Ykai-f/wiki_yuekai_fr_BMCU/home.md

---
title: Home page
description: 
published: true
date: 2025-07-13T19:34:54.650Z
tags: 
editor: markdown
dateCreated: 2025-01-26T21:11:08.155Z
---

# Welcome to yuekai's wiki - BMCU wiki

Backup site that can be accessed in case of failure of this site ：wiki2.yuekai.fr

You can contact me by
Reddit : [u/Ok_Design6972](https://www.reddit.com/user/Ok_Design6972/)
By mail : contact@yuekai.fr
I also recommend asking your question directly in the Reddit forums to get responses from other enthusiasts: https://www.reddit.com/r/BMCU/.

>Update 4th June : 
>📢 Printer Firmware Update Notice –**A Series** - **01.05.00.00**
>✅ This update does not affect the functionality of BMCU. You can safely update your printer without concerns regarding BMCU compatibility.
>⚠️ However, this firmware does impact third-party integrations such as Orca Slicer and Home Assistant.
{.is-success}

> Update on 1st July
>📢 BMCU Firmware Update Notice –**BMCU-C 0019**
> The problem of not being able to change filament on P/X printers has been successfully fixed in BMCU-C firmware version 0019.
{.is-success}

# Table of contents

- [🏠 Home](/home)
- [🛍️ Buy BMCU](/BMCU/buy_bmcu)
{.links-list}

### Introduction
- [📖 What's BMCU](/BMCU)
- [🅿️ BMCU in P/X series](/BMCU/BMCU_in_p_series)
{.links-list}

### Before building
- [🌿 Current Version Branches](/BMCU/bmcu_branches)
- [📝 Preparation Before Building](/BMCU/preparation_before_building)
- [📦 BMCU Bill Of Materials](/BMCU/BMCU_bill_of_materials)
{.links-list}

### While building
- [🛠️ BMCU Download Center *Print files, Firmwares*](/BMCU/BMCU_Download_Center)
- [🎓 BMCU Tutorial Center *Tutorials*](/BMCU/BMCU_Tutorial)
- [🔬 BMCU Testing *Before connect to printer you must..*](/BMCU/BMCU_testing)
{.links-list}

### After building
- [🆕 First time using BMCU](/BMCU/new_bmcu)
- [⚙️ Troubleshooting](/BMCU/troubleshooting)
{.links-list}

# Content Sources & Acknowledgements

> **内容来源声明**
>本网站部分内容转载自作者的交流群，以及 BMCU WIKI 编辑部 其他成员的贡献内容。特此声明并向所有原作者及编辑部成员表示感谢。
>📌 BMCU WIKI 编辑部中文网站: https://bmcu-cf.wanzii.cn
>📌 BMCU WIKI 编辑部中文站点源码 (GitHub): https://github.com/xwzkj/bmcu-doc
>📌 BMCU 作者官方QQ交流群 ： 829433420
{.is-info}

> **Content Source Declaration**
>Some content on this website has been reposted from the author's discussion group and contributions from other members of the BMCU WIKI Editorial Team. We hereby acknowledge and express our gratitude to all original authors and editorial team members.
>📌 BMCU WIKI Editorial Team Chinese Website: https://bmcu-cf.wanzii.cn
>📌 Backup site for oversea visiter ： https://bmcu.wanzii.cn/
>📌 BMCU WIKI Editorial Team Chinese Site Source Code (GitHub): https://github.com/xwzkj/bmcu-doc
>📌BMCU authors Chinese exchange group : QQ group - 829433420
{.is-info}

# 特别感谢 / Special thanks
特别感谢WIKI编辑部的所有成员及作者大佬
Special thanks to all the members of the WIKI editorial team and the authors!
`@4061N`，`@括号`，`@苹果香蕉泥`，`@丸子`，`@高性能萝卜子`，`@星尘`，`@2333`，`@青铜扳子`，`@白小淘`，`@Carlos`，`@David`，`@独来独往独自言`，`@二月 喵～`，`@HC`，`@憨批`，`@花雨烟然、繁华乱了`，`@1064 aka 曼波 aka 朱孔明 aka 袁大头`，`@十`，`@神棍`，`@我是懒大王`，`@星玲可`，`@晓心乐子人`，`@心已死`，`@言`，`@知悟`，`@ `，`@。。。`，`@少年谈情不说爱`，`@.`

# To do list for the updates

~~- Hall version tutorials~~
- New what's BMCU page
- New first time use page
- BMCU videos
- BMCU Hub for multiple BMCU
- BMCU D info
- update version branch info
~~- troubleshooting rebuild~~
- test rebuild
- flashing -> linux and macos info
- troubleshooting hall version -> squeezes / Mouse sounds
- all versions -> update on motor fixiation
- aliexpress list for parts -> note for gears !
