Ykai-f/wiki_yuekai_fr_BMCU/not_only_bmcu.md

---
title: Not Only BMCU
description: 
published: true
date: 2025-05-27T17:19:48.553Z
tags: 
editor: markdown
dateCreated: 2025-05-27T17:18:15.644Z
---

To do

BMCU hub to connect 4 bmcus -> but in the end still 4 colors in one print.

B1 rewinder device

tool for catching packets
