Ykai-f/wiki_yuekai_fr_BMCU/BMCU/home.md

---
title: Home page
description: 
published: true
date: 2025-03-21T14:36:12.856Z
tags: 
editor: markdown
dateCreated: 2025-01-26T21:11:08.155Z
---

# Welcome to yuekai's wiki - BMCU wiki

You can contact me by
Reddit : u/Ok_Design6972
By mail : contact@yuekai.fr
By vinted : https://www.vinted.fr/member/234363406

> Please never hot-plug the cable between the BMCU and the printer, I have already fried my BMCU and printer 🥶. More details on : [BMCU-accident-hot-swapping](/BMCU/BMCU-accident-hot-swapping)
{.is-warning}

# Table of contents

- [🏠 Home](/home)
- [🛍️ Buy BMCU](/BMCU/buy_bmcu)
{.links-list}

### Introduction
- [📖 What's BMCU](/BMCU)
- [❓ FAQ](/BMCU/faq)
{.links-list}

### Before building
- [🌿 Current Version Branches](/BMCU/bmcu_branches)
- [📝 Preparation Before Building](/BMCU/preparation_before_building)
- [📦 BMCU Bill Of Materials](/BMCU/BMCU_bill_of_materials)
{.links-list}

### While building
- [🛠️ BMCU Download Center *Print files, Firmwares*](/BMCU/BMCU_Download_Center)
- [🎓 BMCU Tutorial Center *Tutorials*](/BMCU/BMCU_Tutorial_Center)
- [🔬 BMCU Testing *Before connect to printer you must..*](/BMCU/BMCU_testing)
{.links-list}

### After building
- [⚙️ Troubleshooting](/BMCU/troubleshooting)
{.links-list}

# Content Sources & Acknowledgements

> **内容来源声明**
>本网站部分内容转载自作者的交流群，以及 BMCU WIKI 编辑部 其他成员的贡献内容。特此声明并向所有原作者及编辑部成员表示感谢。
>📌 BMCU WIKI 编辑部中文网站: https://xwzkj.github.io/bmcu-doc/
>📌 备份站点 ： https://bmcu.wanzii.cn/
>📌 BMCU WIKI 编辑部中文站点源码 (GitHub): https://github.com/xwzkj/bmcu-doc
>📌 BMCUz作者官方QQ交流群 ： 829433420
{.is-info}

> **Content Source Declaration**
>Some content on this website has been reposted from the author's discussion group and contributions from other members of the BMCU WIKI Editorial Team. We hereby acknowledge and express our gratitude to all original authors and editorial team members.
>📌 BMCU WIKI Editorial Team Chinese Website: https://xwzkj.github.io/bmcu-doc/
>📌 Backup site for oversea visiter ： https://bmcu.wanzii.cn/
>📌 BMCU WIKI Editorial Team Chinese Site Source Code (GitHub): https://github.com/xwzkj/bmcu-doc
>📌BMCU authors Chinese exchange group : QQ group - 829433420
{.is-info}

> 特别感谢WIKI编辑部的所有成员及作者大佬
> Special thanks to all the members of the WIKI editorial team and the authors!
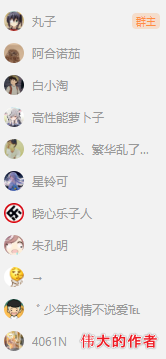
[picture p22: wiki编辑部.png]
>
{.is-success}
