Ykai-f/wiki_yuekai_fr_BMCU/BMCU/BMCU_in_p_series.md

---
title: BMCU with P/X series
description: 
published: true
date: 2025-07-21T20:22:22.619Z
tags: 
editor: markdown
dateCreated: 2025-03-20T14:42:09.077Z
---

> The problem of not being able to change filament on P/X printers has been successfully fixed in BMCU-C firmware version 0019.
{.is-success}

# BMCU Version Adaptation Status

- **BMCU-A**: Not supported; no plans for future adaptation.
- **BMCU-B**: Starting from firmware version 01.08.00.00, the switching filament parameter is no longer available, meaning filament switching in the AMS (BMCU) system cannot be configured. All versions below 01.08.00.00 are fully supported. Currently, there is no update planned to reintroduce this feature.
- **BMCU-C**: Fully supported and running well on the P-Series, Multi BMCU or BMCU+AMS supported.

# BMCU firmware with P/X printer

Starting from firmware version 2-6, the BMCU firmware is capable of identifying whether your printer belongs to the P/X series or A series. In the original firmware developed by `@4061N`, the logic for P/X series printers is as follows:

- **Feeding**: Identical to the A series, no special handling.

- **Unloading**: When unloading is triggered, the filament is retracted until the BMCU's filament detection mechanism (optical sensor or steel ball-based) no longer detects the filament. At that point, the unloading stops, the motor briefly reverses direction and feeds forward for 100ms to reinsert the filament slightly into the BMCU.

Under this default behavior, a rewinder is required to take up the slack, as the filament will be pulled out by a significant length.

This also means that, provided you have a compatible rewinder setup, you are free to upgrade your BMCU to any firmware version.

## With rewinder system

With a rewind device, you can use any BMCU and any version of BMCU firmware, and the BMCU will perform similar behavioral logic as the AMS.

## Without rewinder system
For setups without a rewinder, there are some special firmwares modified by `@XC`. Unlike the original firmware which relies on filament detection (e.g., optical or steel ball sensors), this version uses a time-based retraction mechanism to define the unloading distance.

This approach results in a **shorter** retraction distance.

> Note: Previous documentation have inaccurately stated otherwise. In reality, the default behavior causes the filament to retract all the way until it exits the BMCU, whereas this modified firmware only retracts until it reaches the internal or external five-way connector.
{.is-danger}

### Using externe 5 way

You will need a bambu 4-in-1 ptfe adapter or anything similar.
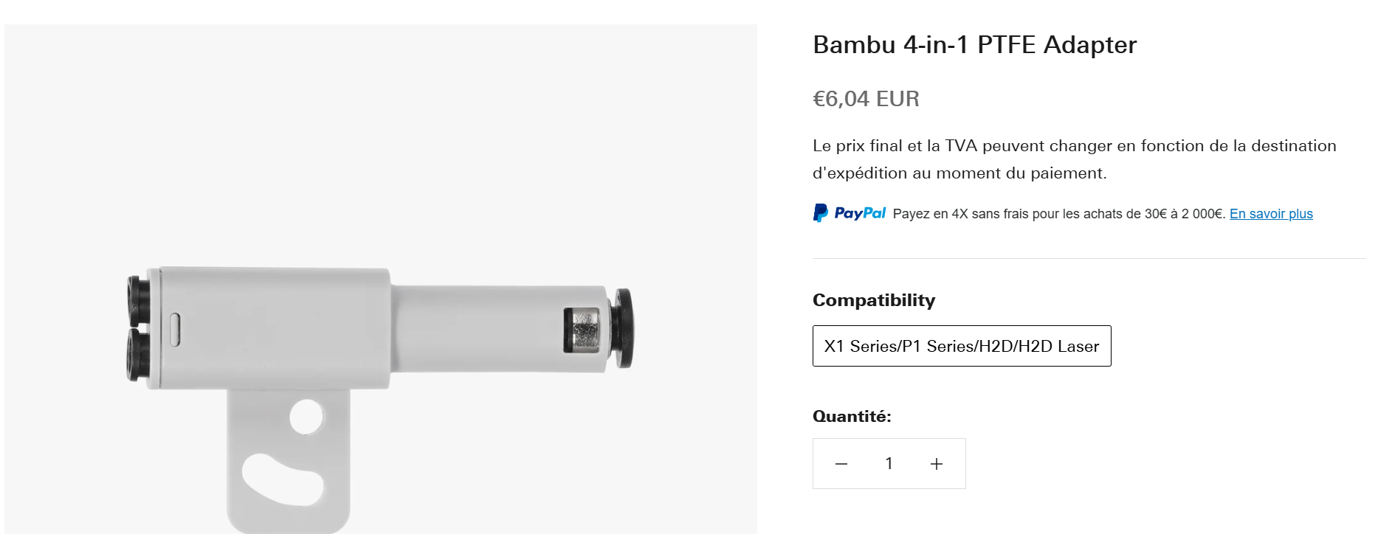
[picture p23: assets/images/p_series/4_in_1_adapter.png]
4-in-1 adapter


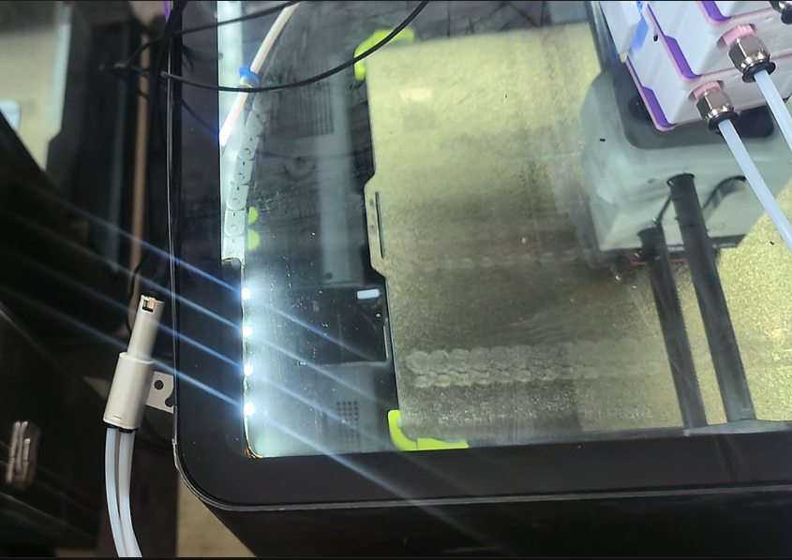
[picture p24: assets/images/p_series/bmcu_p_ext_5way.png]


### Using internal 5 way

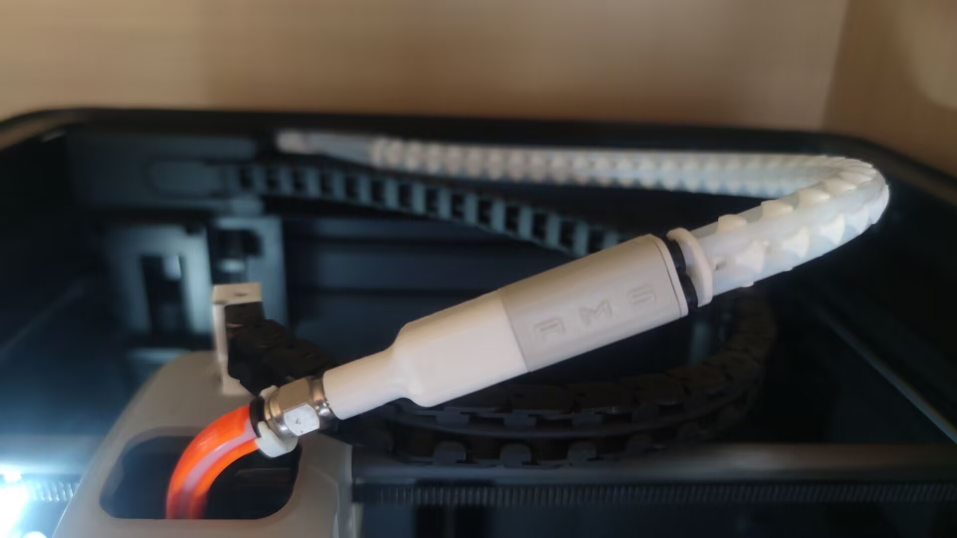
[picture p25: assets/images/p_series/p1_int_5way_1.jpg]
internal 5 way 1

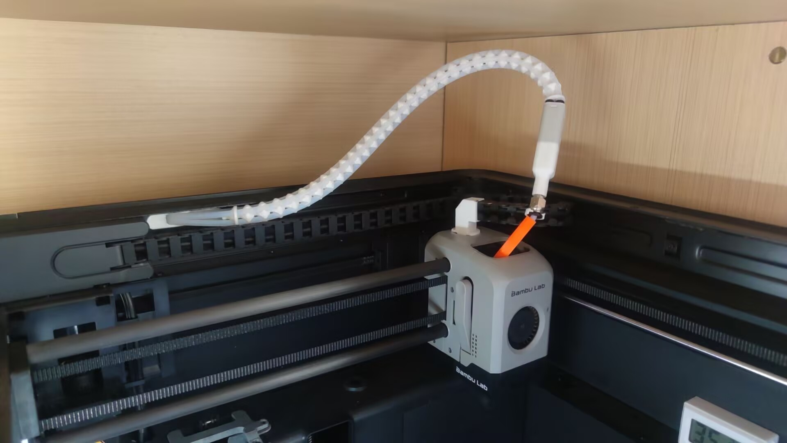
[picture p26: assets/images/p_series/p1_int_5way_2.jpg]
internal 5 way 2


### Firmwares

These firmwares are modified by XC `@星尘`

#### BMCU-B

##### 3.14
Externe 5 way:
- [P1S_RetModified_BMCU370-3.14_15s_Ext5Way.rar](/assets/files/download_center/p_series/P1S_RetModified_BMCU370-3.14_15s_Ext5Way.rar)
- [P1S_RetModified_BMCU370_3.14_14s_Ext5Way.rar](/assets/files/download_center/p_series/P1S_RetModified_BMCU370_3.14_14s_Ext5Way.rar)

Internal 5 way:
- [P1S_RetModified_BMCU370_3.14_4s_Int5Way.rar](/assets/files/download_center/p_series/P1S_RetModified_BMCU370_3.14_4s_Int5Way.rar)
- [P1S_RetModified_BMCU370_3.14_3.5s_Int5Way.rar](/assets/files/download_center/p_series/P1S_RetModified_BMCU370_3.14_3.5s_Int5Way.rar)

#### BMCU-C

##### Using internal 5 way
- [0013-Plus-Color-Noise-Heat-Improve.zip](/assets/files/download_center/firmware_and_source_code/0013-Plus-Color-Noise-Heat-Improve.zip)

- [BMCU-C-V0.1-0020.zip](/assets/files/download_center/firmware_and_source_code/BMCU-C-V0.1-0020.zip)

# Using AMS + BMCU or more than one BMCU

> **Update on 2nd July 2025**:
> We are excited to announce that in the latest firmware release (currently available as version 0019), @4061 has introduced support for using multiple BMCUs alongside AMS units on P/X-series printers. With this update, combining BMCU and AMS has become simpler and more user-friendly than ever. Due to inherent limitations of the P-series system, you can now freely mix and use any combination of BMCUs and AMS units, as long as the total number of devices does not exceed four.
{.is-success}

- You can only use the BMCU-C for the following operations
- You can use up to 4 devices, any number of combinations of AMS and BMCUs.
- You can safely upgrade your P/X printer to the latest firmware
- You will still need a rewind device to rewind the filament as it will exit quite a distance.
- For multiple BMCUs, you will need to flash different firmware for each of the up to four BMCUs you own, number 1 to 4 respectively

**Current Known Issues:**
- Because BMCUs do not communicate with each other / between BMCUs and AMS, when switching filament, it is possible that BMCU1 is still retreiving but BMCU2 is starting to feed, so you need to make the BMCU-Hub distance much larger than the Hub-Printer distance
- We have noticed that in the current 0016-0019 firmware, the AT8236 chip may heat up abnormally in an unworked state, waiting for the developer to fix it in a future release
- In the current 0016-0018 versions of the firmware, the authors have not included the PID tuning parameters etc. developed by @XC for the time being, so there is a possibility that it may not be as good as the 0013Plus version in terms of gear wear/noise/heating issues

## Interface diagram

```diagram
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
```

## Wire diagram

```diagram
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
```

### Multi BMCU

You can simply connect the cables in parallel to split multiple 4-pin ports from a single 4-pin port, as shown below：
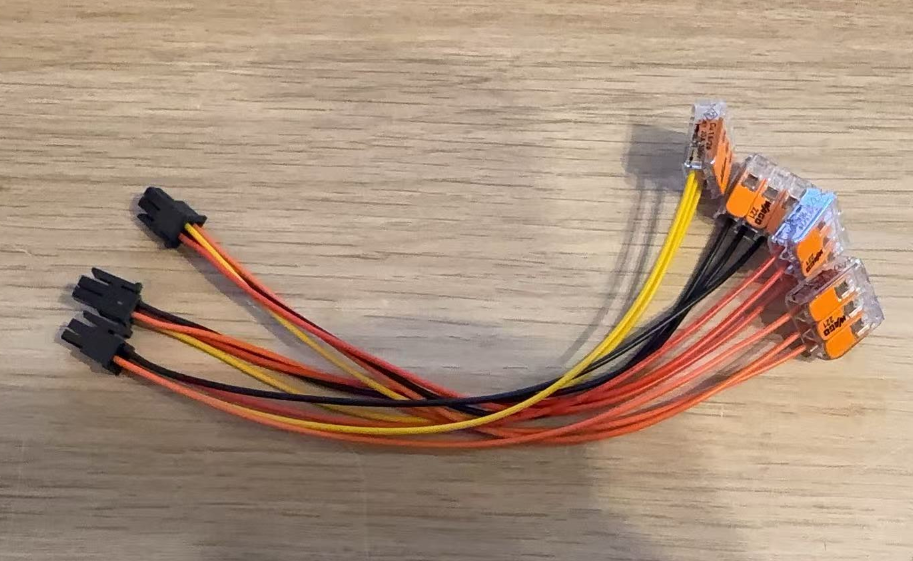
[picture p27: assets/images/p_series/并联接线.png]


You can also use e.g. BIGREETECH's Panda Branch or similar devices to connect multiple bmcu/AMS：

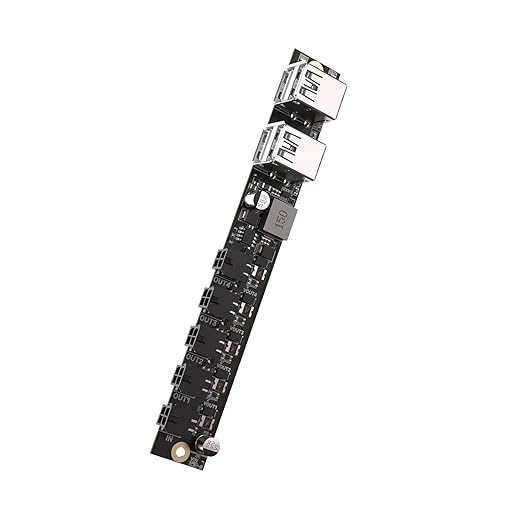
[picture p28: assets/images/p_series/panda_branch.jpg]


### AMS + BMCU

❌ There is no need to buy a Bambu AMS Hub.

```diagram
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
```

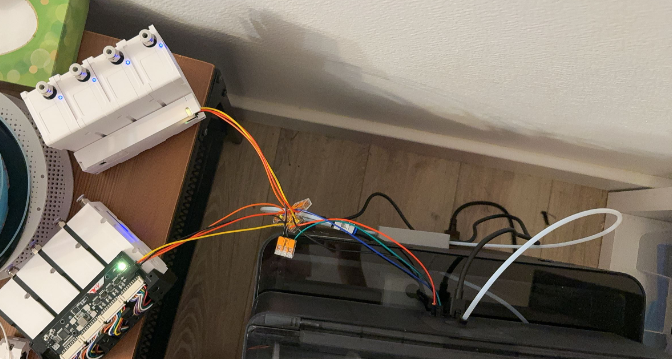
[picture p29: assets/images/p_series/AMS_plus_BMCU.png]

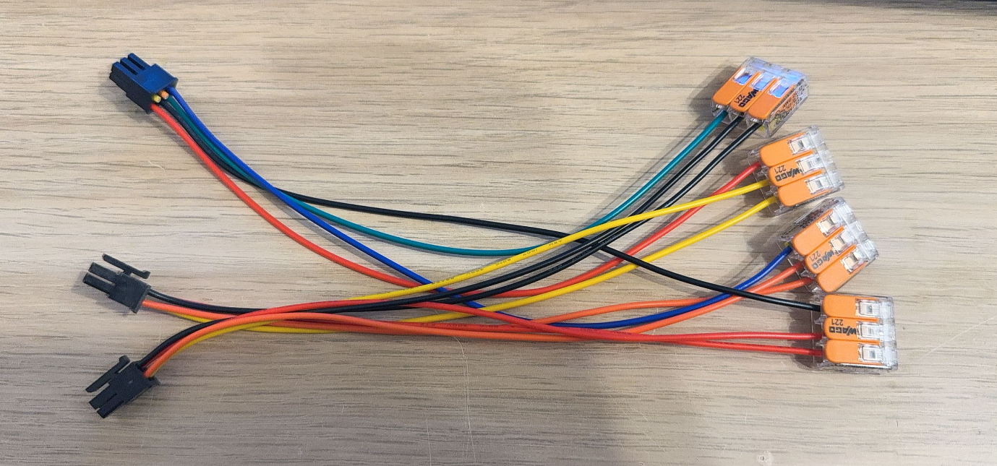
[picture p30: assets/images/p_series/并联接线AMSBMCU.png]


## PTFE tube diagram

```diagram
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
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
