Ykai-f/wiki_yuekai_fr_BMCU/assets/images/bmcu_bracket/all_bracket.jpg

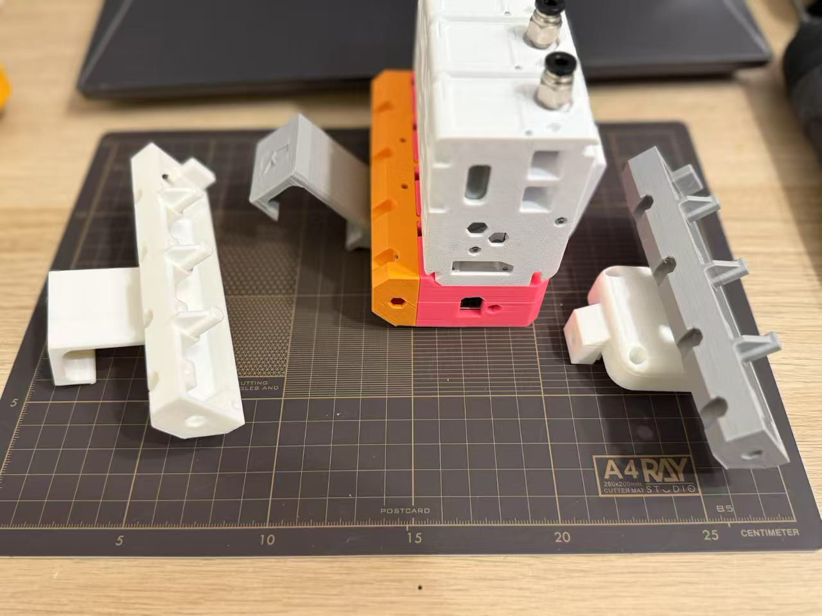
assets/images/bmcu_bracket/all_bracket.jpg
