Ykai-f/wiki_yuekai_fr_BMCU/assets/images/bmcu_branch/bmcu_version_diagram240205.png

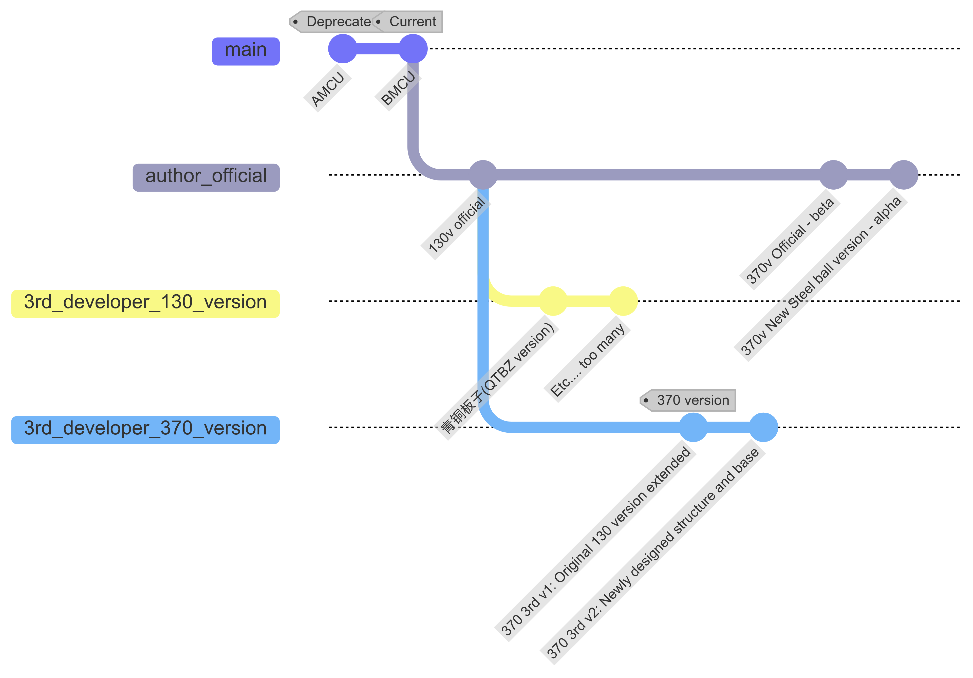
assets/images/bmcu_branch/bmcu_version_diagram240205.png
