Ykai-f/wiki_yuekai_fr_BMCU/assets/images/bmcu_flashing/2.png

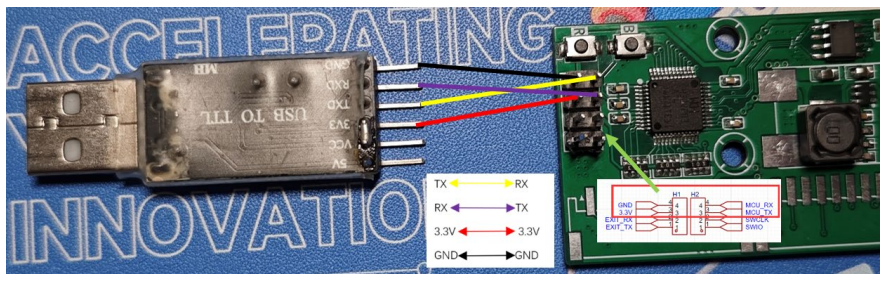
assets/images/bmcu_flashing/2.png
