Ykai-f/wiki_yuekai_fr_BMCU/assets/images/bmcu_flashing/5.png

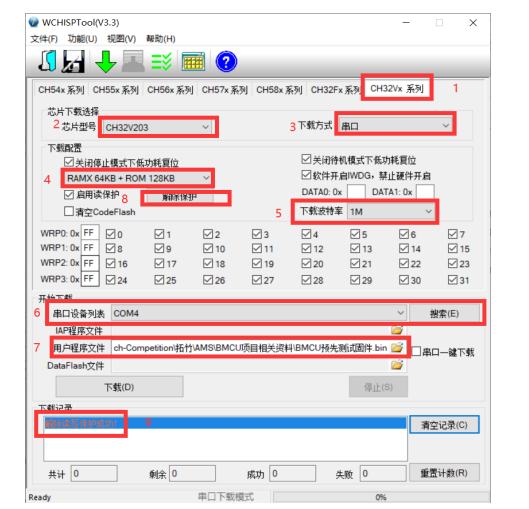
assets/images/bmcu_flashing/5.png
