Ykai-f/wiki_yuekai_fr_BMCU/assets/images/bmcu_flashing/6.png

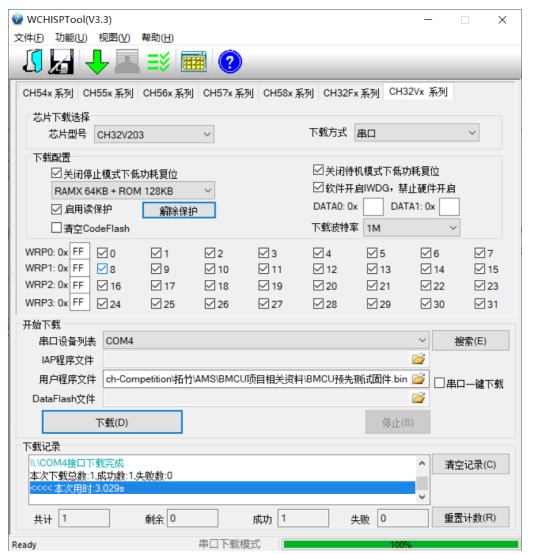
assets/images/bmcu_flashing/6.png
