Ykai-f/wiki_yuekai_fr_BMCU/assets/images/p_series/bmcu_on_p_1.jpg

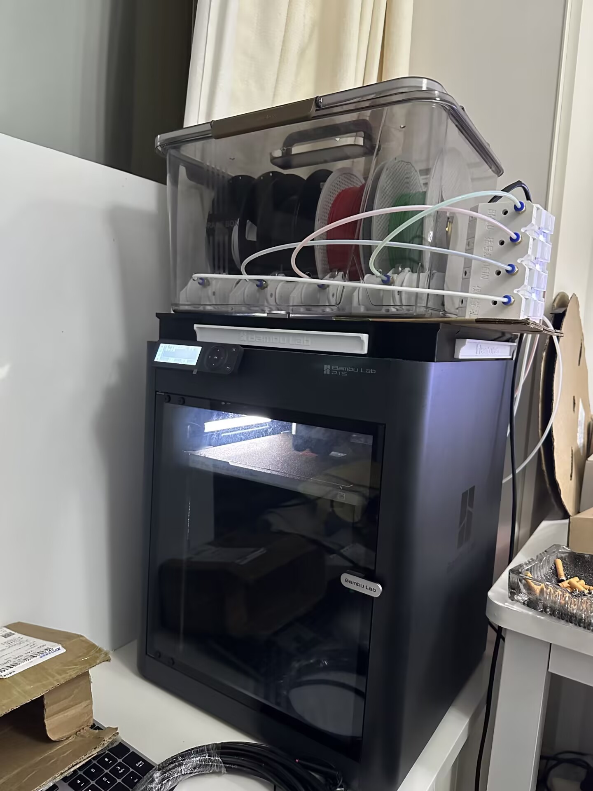
assets/images/p_series/bmcu_on_p_1.jpg
