Ykai-f/wiki_yuekai_fr_BMCU/assets/files/bom_sheet/mechanical_components_bom.xlsx

Sheet: English
Extruded component parts (already multiplied by four channels)
 | Name | Quantity | Link(note: only avaible in china) | quantity in the link
 | MR85ZZ bearing | 8 | https://item.taobao.com/item.htm?id=729395585260&skuId=5058406261745 | 8（recommend 9）
 | BMG gear set | 4 | https://item.taobao.com/item.htm?id=623450049026&skuId=5274263566537 | 4
 | D5x22mm shaft | 4 | https://detail.tmall.com/item.htm?id=690274527829&skuId=5659167538247 | 1
 | D2x10mm shaft | 16 | https://detail.tmall.com/item.htm?id=680516964370&skuId=4882059537282 | 1
 | D2x20mm shaft | 12 | https://item.taobao.com/item.htm?id=25771992682 | 12（recommend 15）
 | 20082B double-layer straight gear | 8 | https://item.taobao.com/item.htm?id=18751470868&skuId=45440640259 | 8（recommend 9）
 | 182A gear | 8 | https://item.taobao.com/item.htm?id=18760030298 | 8（recommend 9）
 | 242A gear | 4 | https://item.taobao.com/item.htm?id=18762710098 | 4（recommend 5）
 | 682A worm gear | 4 | https://item.taobao.com/item.htm?id=20964703851 | 4（recommend 5）
 | FF-130 SH motor | 4 | https://item.taobao.com/item.htm?id=586011289551 | 4（recommend 5）
 | Wires (over 5cm) | 8 | https://item.taobao.com/item.htm?id=555198400702&skuId=3425843024777 | 1
 | 62B shaft sleeve | 28 | https://item.taobao.com/item.htm?id=557038811656 | 3（recommend 4）
 | PC4 pneumatic connector 6mm | 4 | https://detail.tmall.com/item.htm?id=644546493913&skuId=4816633895773 | 4（recommend 5）
 | Spring 0.5*6x10mm | 4 | https://detail.tmall.com/item.htm?id=649882524891&skuId=4728198936053 | 1
 | Spring 0.6*4x10mm | 4 | https://detail.tmall.com/item.htm?id=651034855393&skuId=4686988224285 | 1
 | M2*8 countersunk self-tapping screws | 48 | https://detail.tmall.com/item.htm?id=535515124518&skuId=3193947919795 | 1
 | 1.75mm transparent consumables (used for light guidance) | 1m
Chassis section
 | M2*8 countersunk self-tapping screws | 3 | already bought | The above purchases are sufficient (100 units)
 | M3*14 countersunk self-tapping screws | 9 | https://detail.tmall.com/item.htm?id=535515124518&skuId=4431253120193 | 1
 | MX3.0-4P mirrored connecting cable | 1 | https://item.taobao.com/item.htm?id=748449242763&skuId=5162239945869 | 1
Support section
 | M3*10 standard screws | 2 | https://detail.tmall.com/item.htm?id=534706775015&skuId=3191939497531 | 1
 | M3 nuts | 2 | https://detail.tmall.com/item.htm?id=584675839451&skuId=5087996454459 | 1
Other tools and consumables (please check yourself, not counted in the total BOM)
 | One roll of opaque consumables
 | Lubricating oil/grease (worm gear must be lubricated)
 | Four Teflon tubes with an inner diameter of over 2.5mm and an outer diameter of 4mm
 | USB to TTL serial module
 | Four Dupont wires
 | 3mm Phillips screwdriver (thicker ones cannot be used)
 | Soldering tools, including soldering iron, tweezers, solder wire, flux, etc.
 | Bambulab printer
 | Stand for holding consumables

Sheet: Sheet1
挤出组件部分（已乘四通道）
 | 名称 | 总数量 |  | 链接选择购买量
 | MR85ZZ轴承 | 8 | https://item.taobao.com/item.htm?id=729395585260&skuId=5058406261745 | 8（推荐9）
 | BMG齿轮套装 | 4 | https://item.taobao.com/item.htm?id=623450049026&skuId=5274263566537 | 4
 | D5x22mm轴 | 4 | https://detail.tmall.com/item.htm?id=690274527829&skuId=5659167538247 | 1
 | D2x10mm轴 | 16 | https://detail.tmall.com/item.htm?id=680516964370&skuId=4882059537282 | 1
 | D2x20mm轴 | 12 | https://item.taobao.com/item.htm?id=25771992682 | 12（推荐15）
 | 20082B双层直齿轮 | 8 | https://item.taobao.com/item.htm?id=18751470868&skuId=45440640259 | 8（推荐9）
 | 182A齿轮 | 8 | https://item.taobao.com/item.htm?id=18760030298 | 8（推荐9）
 | 242A齿轮 | 4 | https://item.taobao.com/item.htm?id=18762710098 | 4（推荐5）
 | 682A蜗杆齿轮 | 4 | https://item.taobao.com/item.htm?id=20964703851 | 4（推荐5）
 | FF - 130 SH电机 | 4 | https://item.taobao.com/item.htm?id=586011289551 | 4（推荐5）
 | 导线（5cm以上） | 8 | https://item.taobao.com/item.htm?id=555198400702&skuId=3425843024777 | 1
 | 62B轴套 | 28 | https://item.taobao.com/item.htm?id=557038811656 | 3（推荐4）
 | PC4气动头 6mm | 4 | https://detail.tmall.com/item.htm?id=644546493913&skuId=4816633895773 | 4（推荐5）
 | 弹簧0.5*6x10mm | 4 | https://detail.tmall.com/item.htm?id=649882524891&skuId=4728198936053 | 1
 | 弹簧0.6*4x10mm | 4 | https://detail.tmall.com/item.htm?id=651034855393&skuId=4686988224285 | 1
 | M2*8沉头自攻螺丝 | 48 | https://detail.tmall.com/item.htm?id=535515124518&skuId=3193947919795 | 1
 | 1.75mm透明耗材（用于导光） | 1m
底座部分
 | M2*8沉头自攻螺丝 | 3 | 已有 | 上述购买量已足够（100只）
 | M3*14沉头自攻螺丝 | 9 | https://detail.tmall.com/item.htm?id=535515124518&skuId=4431253120193 | 1
 | MX3.0-4P镜像连接线 | 1 | https://item.taobao.com/item.htm?id=748449242763&skuId=5162239945869 | 1
支架部分
 | M3*10普通螺丝 | 2 | https://detail.tmall.com/item.htm?id=534706775015&skuId=3191939497531 | 1
 | M3螺母 | 2 | https://detail.tmall.com/item.htm?id=584675839451&skuId=5087996454459 | 1
其他工具及耗材（请自行核对，不计入总BOM）
 | 不透明耗材一卷
 | 润滑油/润滑脂（蜗杆齿轮必须润滑）
 | 内径2.5mm以上,外径4mm特氟龙管四根
 | USB转TTL串口模块
 | 杜邦线4根
 | 3MM十字螺丝刀（更粗的不能用）
 | 烙铁、镊子、焊锡丝、焊油等焊接工具
 | 拓竹打印机
 | 放耗材的支架
