Ykai-f/wiki_yuekai_fr_BMCU/assets/files/bom_sheet/pcb_bom.xlsx

Sheet: ENGLISH
Main PCB
 | N° | Quantity | Name | Package/Model | Reference Purchase Link （only avaible in china) | Quantity to purchase via the link
 | 1 | 4 | PH2.0 connector | PH2.0/10P (horizontal mount) | https://item.taobao.com/item.htm?id=553223118722&skuId=4983117084125 | 1
 | 2 | 3 | 10kΩ resistor array | 0603*4 | https://item.taobao.com/item.htm?id=522573249593 | 1
 | 3 | 12 | 100nF capacitor (50V voltage rating) | C0603 | https://item.taobao.com/item.htm?id=522573286298 | 1
 | 4 | 4 | 0.68Ω resistor | R1210 | https://item.taobao.com/item.htm?id=524216878082 | 1
 | 5 | 4 | AT8236 | SOP8 | https://item.taobao.com/item.htm?id=803949868593 | 4（Recommend 5）
 | 6 | 2 | Micro switch | KEY-SMD_B3U-1000PM | https://item.taobao.com/item.htm?id=546724645617&skuId=3950794532931 | 1
 | 7 | 1 | CH32V203C8T6 | LQFP48 | https://item.taobao.com/item.htm?id=708687799232&skuId=4970679344122 | 1（Recommend 2）
 | 8 | 1 | MX3.0 connector | 4pin | https://detail.tmall.com/item.htm?id=624554633508&skuId=4592301798674 | 1
 | 9 | 2 | 2.54mm pin header | 4pin | https://item.taobao.com/item.htm?id=553875848479&skuId=3694578925276 | 1
 | 10 | 1 | SMBJ24CA | DO-214AA | https://item.taobao.com/item.htm?id=565061951670 | 1
 | 11 | 1 | TP75176E-SR | SOP8 | https://item.taobao.com/item.htm?id=654383182827 | 1（Recommend 2）
 | 12 | 1 | WS2812B | 5050 | https://item.taobao.com/item.htm?id=686018450822 | 5（Recommend 7）
 | 13 | 2 | 10Ω resistor | 0603 | https://item.taobao.com/item.htm?id=525724626983 | 1
 | 14 | 1 | 120Ω resistor | 0603 | https://item.taobao.com/item.htm?id=525735174372 | 1
 | 15 | 1 | PSM712 | SOT23-3 | https://item.taobao.com/item.htm?id=652999552289 | 1（Recommend 2）
 | 16. Either one of the following
 | Use of power supply modules | 1 | 3.3V power module | 24V-3.3V | https://item.taobao.com/item.htm?id=644346322045&skuId=4634423556340 | 1（Recommend 2） | Simple soldering, lower cost
 | Use IC | 1 | TPS54202DDCR | SOT23-6 | https://item.taobao.com/item.htm?id=635845819681 | 1（Recommend 2） | Free mix and match with alternative components
 |  | 1 | 47pF | C0603 | https://item.taobao.com/item.htm?id=537579223445 | 1
 |  | 1 | 15kΩ | R0603 | https://item.taobao.com/item.htm?id=525796963242 | 1
 |  | 1 | 68kΩ | R0603 | https://item.taobao.com/item.htm?id=525878306847 | 1
 |  | 3 | 22uF | C0805 | https://item.taobao.com/item.htm?id=555159599251 | 1
 |  | 1 | 10uH | 7.3*6.8mm | https://item.taobao.com/item.htm?id=522572781147&skuId=4554704774433 | 1（Recommend 2）
Component PCB (already multiplied by 4)
 | 1 | 4 | WS2812B | See n° 12 in the Main PCB section |  | already purchased 5 in section Main PCB, no need to buy additional
 | 2 | 16 | 100nF | See n° 3 in the Main PCB section |  | already purchased 50 in section Main PCB, no need to buy additional
 | 3 | 4 | PH2.0 connector | See n° 1 in the Main PCB section |  | already purchased 7 in section Main PCB, no need to buy additional
 | 4 | 4 | PH2.0 cable | 10Pin | https://item.taobao.com/item.htm?id=607000261049&skuId=4258117528707 | 4（Recommend 5）
 | 5 | 8 | 470Ω resistor | 0603 | https://item.taobao.com/item.htm?id=525787826203 | 1
 | 6 | 8 | ITR9606 photoelectric switch | Through-hole mount (or direct insertion) | https://item.taobao.com/item.htm?id=522574501806 | 8（Recommend 9）
 | 7 | 4 | AS5600 (with magnet) | SOP8 | https://detail.tmall.com/item.htm?id=708179430150&skuId=5003349357859 | 4（Recommend 5）
 | 8 | 4 | LM393 | SOP8 | https://item.taobao.com/item.htm?id=548082479129 | 4（Recommend 5）
 | 9 | 8 | 1kΩ resistor | 0603 | https://item.taobao.com/item.htm?id=525795113143 | 1
 | 10 | 8 | LED | 0603 | https://item.taobao.com/item.htm?id=522554271548 | 1
 |  |  |  |  |  | If purchased in Recommend quantities, the total cost of the components is RMB 80, including shipping.

Sheet: BOM_Board1_Schematic1_2024-09-2
主机PCB
 | 序号 | 数量 | 名称 | 封装/型号 | 参考购买链接（已选择好对应型号） | 链接选择购买数量
 | 1 | 4 | PH2.0座子 | PH2.0/10P（卧贴） | https://item.taobao.com/item.htm?id=553223118722&skuId=4983117084125 | 1
 | 2 | 3 | 10kΩ排阻 | 0603*4 | https://item.taobao.com/item.htm?id=522573249593 | 1
 | 3 | 12 | 100nF(50V耐压) | C0603 | https://item.taobao.com/item.htm?id=522573286298 | 1
 | 4 | 4 | 0.68R电阻 | R1210 | https://item.taobao.com/item.htm?id=524216878082 | 1
 | 5 | 4 | AT8236 | SOP8 | https://item.taobao.com/item.htm?id=803949868593 | 4（推荐5）
 | 6 | 2 | 微动开关 | KEY-SMD_B3U-1000PM | https://item.taobao.com/item.htm?id=546724645617&skuId=3950794532931 | 1
 | 7 | 1 | CH32V203C8T6 | LQFP48 | https://item.taobao.com/item.htm?id=708687799232&skuId=4970679344122 | 1（推荐2）
 | 8 | 1 | MX3.0座子 | 4pin | https://detail.tmall.com/item.htm?id=624554633508&skuId=4592301798674 | 1
 | 9 | 2 | 2.54排针 | 4pin | https://item.taobao.com/item.htm?id=553875848479&skuId=3694578925276 | 1
 | 10 | 1 | SMBJ24CA | DO-214AA | https://item.taobao.com/item.htm?id=565061951670 | 1
 | 11 | 1 | TP75176E-SR | SOP8 | https://item.taobao.com/item.htm?id=654383182827 | 1（推荐2）
 | 12 | 1 | WS2812B | 5050 | https://item.taobao.com/item.htm?id=686018450822 | 5（推荐7）
 | 13 | 2 | 10Ω电阻 | 0603 | https://item.taobao.com/item.htm?id=525724626983 | 1
 | 14 | 1 | 120Ω电阻 | 0603 | https://item.taobao.com/item.htm?id=525735174372 | 1
 | 15 | 1 | PSM712 | SOT23-3 | https://item.taobao.com/item.htm?id=652999552289 | 1（推荐2）
 | 16.以下二选一
 | 使用电源模块 | 1 | 3.3V电源模块 | 24V-3.3V | https://item.taobao.com/item.htm?id=644346322045&skuId=4634423556340 | 1（推荐2） | 焊接简单，成本更低
 | 使用IC | 1 | TPS54202DDCR | SOT23-6 | https://item.taobao.com/item.htm?id=635845819681 | 1（推荐2） | 自由搭配，有替代元件
 |  | 1 | 47pF | C0603 | https://item.taobao.com/item.htm?id=537579223445 | 1
 |  | 1 | 15kΩ | R0603 | https://item.taobao.com/item.htm?id=525796963242 | 1
 |  | 1 | 68kΩ | R0603 | https://item.taobao.com/item.htm?id=525878306847 | 1
 |  | 3 | 22uF | C0805 | https://item.taobao.com/item.htm?id=555159599251 | 1
 |  | 1 | 10uH | 7.3*6.8mm | https://item.taobao.com/item.htm?id=522572781147&skuId=4554704774433 | 1（推荐2）
组件PCB（已乘4）
 | 1 | 4 | WS2812B | 见主机部分序号12 |  | 主机已购买5只，无需额外购买
 | 2 | 16 | 100nF | 见主机部分序号3 |  | 主机已购买50只，无需额外购买
 | 3 | 4 | PH2.0座子 | 见主机部分序号1 |  | 主机已购买10只，无需额外购买
 | 4 | 4 | PH2.0排线 | 10Pin | https://item.taobao.com/item.htm?id=607000261049&skuId=4258117528707 | 4（推荐5）
 | 5 | 8 | 470R电阻 | 0603 | https://item.taobao.com/item.htm?id=525787826203 | 1
 | 6 | 8 | ITR9606光电开关 | 直插 | https://item.taobao.com/item.htm?id=522574501806 | 8（推荐9）
 | 7 | 4 | AS5600（带磁铁) | SOP8 | https://detail.tmall.com/item.htm?id=708179430150&skuId=5003349357859 | 4（推荐5）
 | 8 | 4 | LM393 | SOP8 | https://item.taobao.com/item.htm?id=548082479129 | 4（推荐5）
 | 9 | 8 | 1K电阻 | 0603 | https://item.taobao.com/item.htm?id=525795113143 | 1
 | 10 | 8 | LED | 0603 | https://item.taobao.com/item.htm?id=522554271548 | 1
 |  |  |  |  |  | 若按推荐量购买，元件总花费80元，包含运费
