Ykai-f/wiki_yuekai_fr_BMCU/assets/files/print_files/BMCU_C.3mf

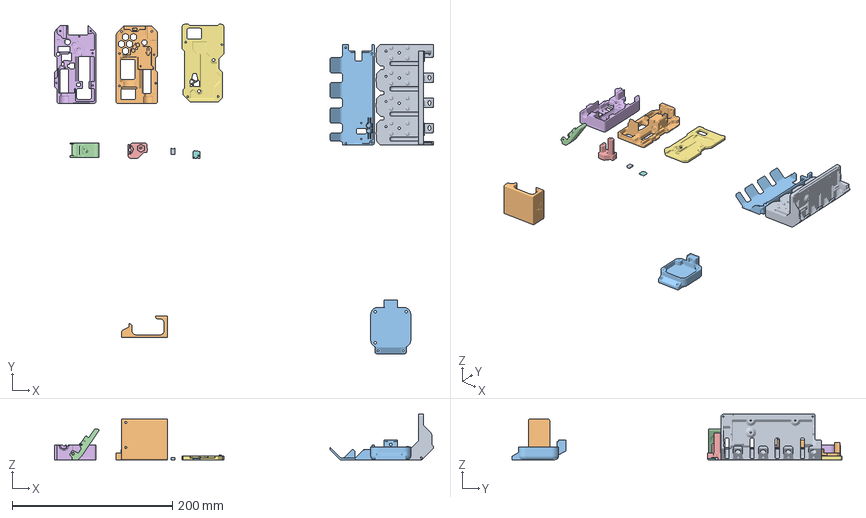
[picture p40: CAD file, 2025-04-15]
assets/files/print_files/BMCU_C.3mf
472.8 x 411.1 x 56.8 mm
Base.obj
Back cover.obj
PCB cover.obj
Lever.obj
Buffer.obj
Middle frame.obj
Front cover.obj
Steel ball slider.obj
Nut plug.obj
370+steel+ball+version+3.stl_1
370+steel+ball+version+3.stl_2
