Ykai-f/wiki_yuekai_fr_BMCU/assets/files/print_files/180 version.3mf

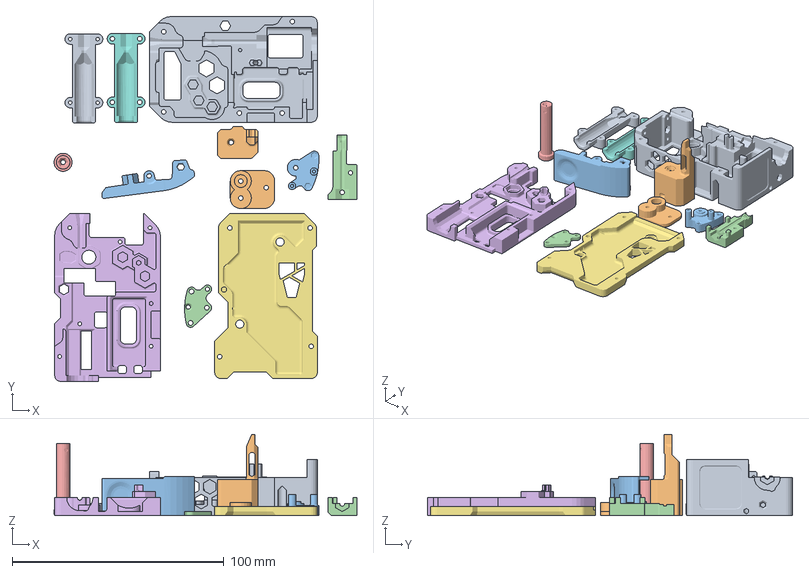
[picture p41: CAD file, 2025-03-31]
assets/files/print_files/180 version.3mf
142.9 x 172.3 x 38.3 mm
_组件_底盖_V2.1.stl
_组件_双向缓冲器.stl_1
_组件_手柄.stl
_组件_耗材流道盖_V2.1.stl
_组件_双向缓冲器.stl_4
_组件_中框.stl
_组件_上盖.stl
_组件_双向缓冲器.stl_2
_组件_双向缓冲器.stl_3
_组件_安装辅助件.stl
_组件_离合器零件B.stl
_组件_离合器零件A.stl
