Ykai-f/wiki_yuekai_fr_BMCU/assets/files/print_files/370+v2.5+original.3mf

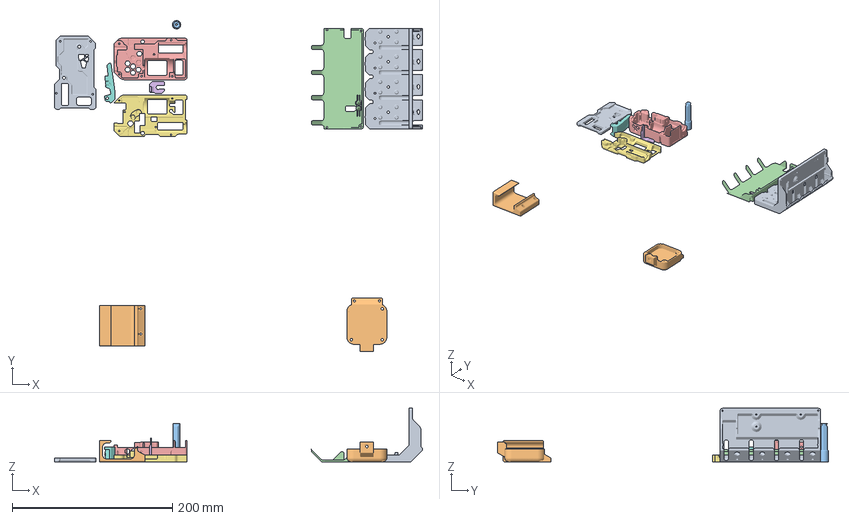
[picture p42: CAD file, 2025-03-31]
assets/files/print_files/370+v2.5+original.3mf
459.4 x 413.1 x 66.8 mm
底座.obj
BMCU0.6底座支架a1mini.stp
滑块柱 (1).obj
PCB盖板.obj
后盖.obj
滑块.obj
中框.obj
扳手.obj
前盖.obj
BMCU0.6底座支架A1（孔没有开歪）.stp
