Ykai-f/wiki_yuekai_fr_BMCU/assets/files/print_files/370+steel+ball+version+3.14.3mf

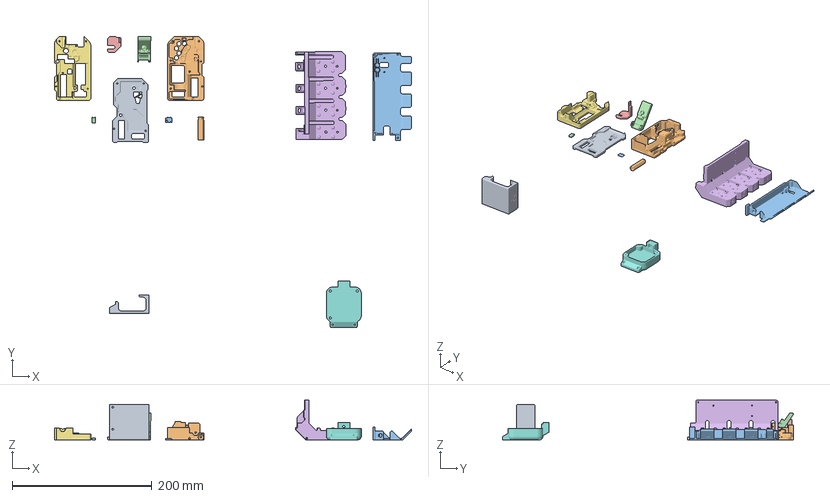
[picture p43: CAD file, 2025-03-31]
assets/files/print_files/370+steel+ball+version+3.14.3mf
511.0 x 416.6 x 56.8 mm
370 底座A1.stl.stl
Back frame.obj
PCB cover.obj
lever.obj
Buffer slider.obj
Base.obj
Middle frame.obj
370 底座A1 mini.stl.stl
Front frame.obj
Buffer slider bar.obj
Ball slider.obj
nut plug.obj
