Ykai-f/wiki_yuekai_fr_BMCU/BMCU/BMCU_Tutorial.md

---
title: BMCU Tutorial
description: 
published: true
date: 2025-06-23T10:58:03.189Z
tags: 
editor: markdown
dateCreated: 2025-02-25T12:56:58.306Z
---

# BMCU Flashing
> If you build your own PCB, please make sure that there are no short circuits, otherwise you may damage your computer/printer.
{.is-warning}

- [BMCU_Flashing](/BMCU/BMCU_Tutorial/BMCU_Flashing)
{.links-list}

# BMCU Assembling

## BMCU-C
- [BMCU-C Hall version v0.2](/BMCU/BMCU_Tutorial/BMCU_Assembling_370_Hall)
{.links-list}

## BMCU-B

- [📝BMCU-B v3.14 edited by Wanzi](/BMCU/BMCU_Tutorial/BMCU_Assembling_370_steel_ball_by_wanzi)
- [📝370X edited by XC (!Attention different PCB required!)](/BMCU/BMCU_Tutorial/BMCU_Assembling_370_mircoswitch_by_xc)
{.links-list}

🎬An amazing assembleing video for the 370 steel ball version made by `@Lukas`!
- https://www.youtube.com/watch?v=sP-fDCnXkro

## Obsolete version

We no longer recommend that you assemble or print these obsolete versions, except for specific reasons.

<details>
<summary>Click here to expend</summary>

### BMCU-B
- [Obsolete - 📝370 version v2.5 edited by Yuekai](/BMCU/BMCU_Tutorial/BMCU_Assembling_370_v1_Yuekai.md)
{.links-list}
## BMCU-A:130 and 180

### BMCU-A
- [Obsolete - 📝130 version edited by QTBZ (Adjustable photoelectric sensing block)](/BMCU/BMCU_Tutorial/Assembling)
- [Obsolete - 📝130 version edited by Yuekai](/BMCU/BMCU_Tutorial/BMCU_Assembling_130_Yuekai.md)
- [Obsolete - 📝180 version edited by BXT](/BMCU/BMCU_Tutorial/BMCU_Assembling_180_by_bxt)
{.links-list}

</details>

# BMCU Bracket Installation
- [BMCU Bracket Installation](/BMCU/BMCU_Tutorial/BMCU_Mounting)
{.links-list}
