Ykai-f/wiki_yuekai_fr_BMCU/BMCU/BMCU_Tutorial/BMCU_Assembling_370_Hall.md

---
title: BMCU-C (370 Hall Version) Assembly Guide
description: 
published: true
date: 2025-07-21T20:36:17.787Z
tags: 
editor: markdown
dateCreated: 2025-06-17T13:28:36.330Z
---

New version is Still todo
also check https://bmcu.wanzii.cn/doc/build/370hall.html

# Introduction

This guide is written for BMCU-C v0.2 channel component assembly.

# Pre-assembly Preparation

Integration package for this tutorial: Coming soon, please check group files

- **A fully soldered BMCU `Hall version` circuit board**: ensuring no soldering defects (cold joints, missing solder, bridges, wrong components, etc.).
- **Flash the mainboard with Hall version compatible firmware**. As of 21/07/25, the latest available firmware is `v0020`
- **3D printed housing** : You can choose between 
	[1. The original file from the author](https://makerworld.com/zh/models/1322913-bmcu-c-hall-sensor-version#profileId-1359453)
  [2. BMCU-C improved version by @Kongmingn](https://makerworld.com/zh/models/1539594-bmcu-c-v0-2-model-kongming-optimized-final-version#profileId-1615601)
  [3. BMCU-C improved version by @ZhuBuZaiHu (Highly recommended!!!)](https://makerworld.com/zh/models/1438783-bmcu-hall-sensor-version-370-optimized-casing#profileId-1500247)
  **I strongly recommend you to use the 3rd link!**
- **Print this tool to check the polarity of magnets later** [Magnet Polarity Detector](https://makerworld.com.cn/zh/models/1141340)

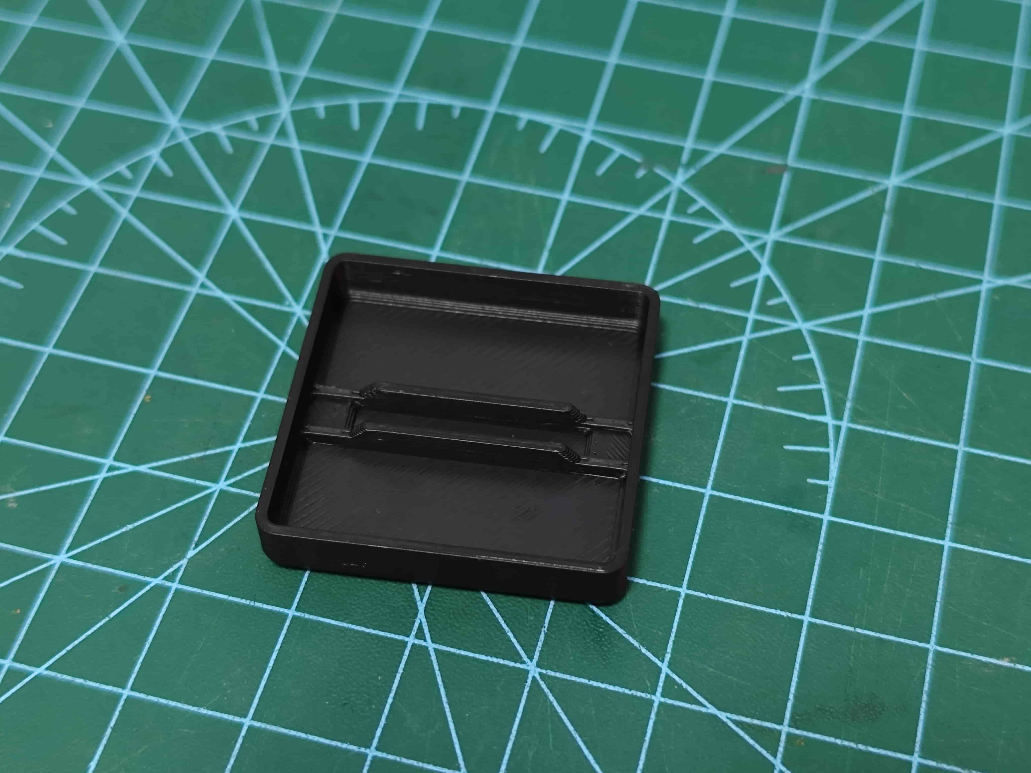
[picture p44: assets/images/bmcu_c_hall/极性确定装置.jpg]
Magnet Polarity Detector


# Main Content

## Component Names

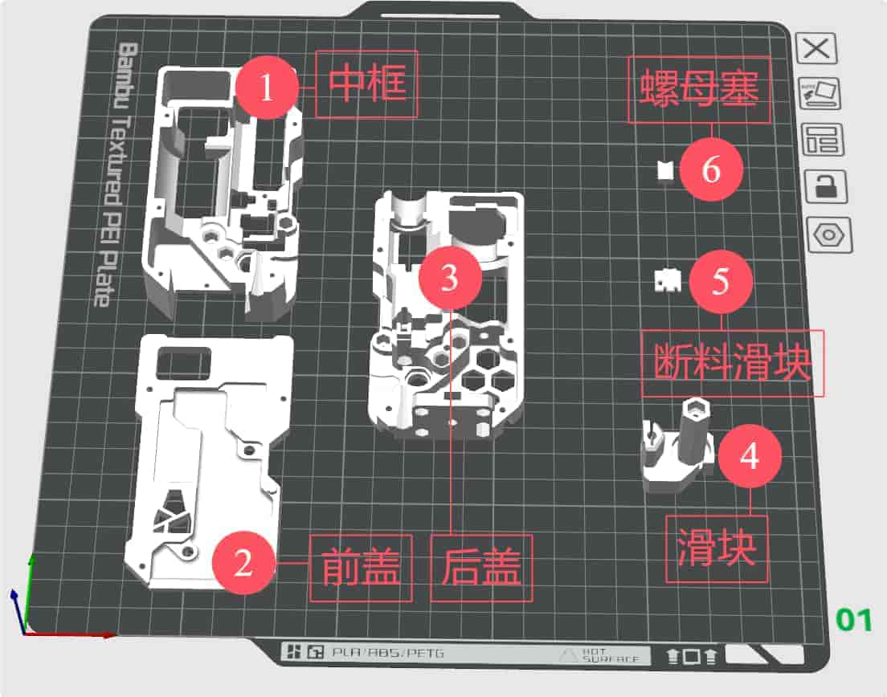
[picture p45: assets/images/bmcu_c_hall/名称介绍.jpg]
Component Names


1. Middle Frame
2. Front Cover
3. Bottom Frame
4. Buffer Slider
5. Filament Detection Slider
6. Nut Plug

## Install Bushing

Insert 62B bushing into back cover and middle frame as shown

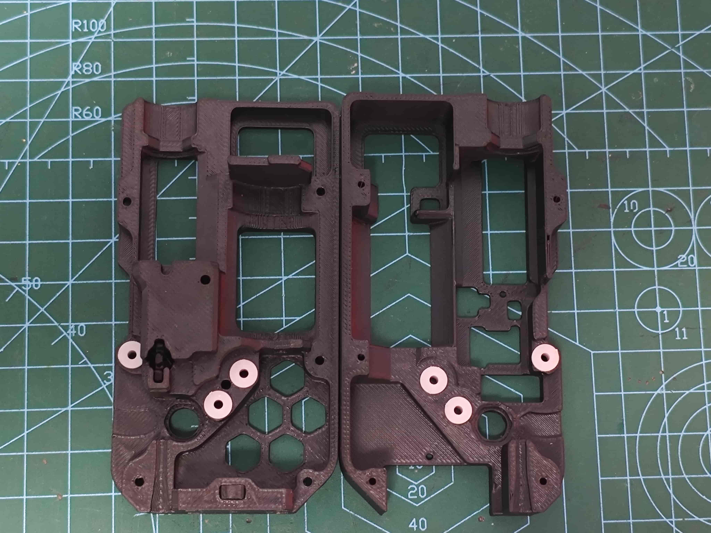
[picture p46: assets/images/bmcu_c_hall/轴套.jpg]
Install Bushing


## Assemble D2\*20 Shaft with 182A Gear

Ensure both ends protrude approximately equal lengths

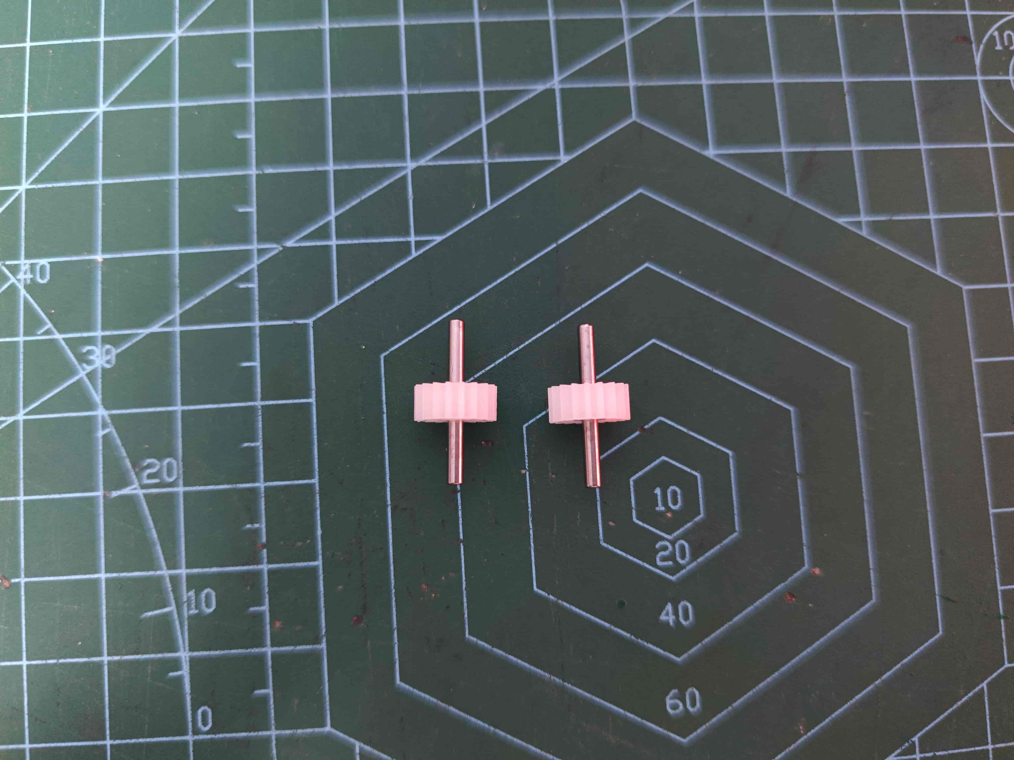
[picture p47: assets/images/bmcu_c_hall/齿轮轴.jpg]
Assemble Shaft and Gear


## Install Worm Gear on 370 Motor and Solder Wires

Align motor shaft with worm gear. Apply 502 glue if needed.

The pin with red dot is positive

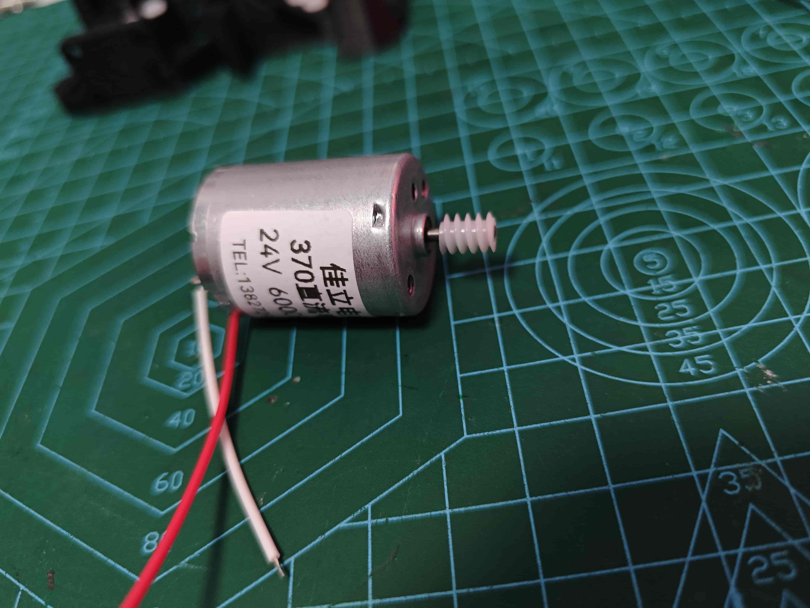
[picture p48: assets/images/bmcu_c_hall/蜗杆.jpg]
Install Worm Gear


## Determine Slider Magnet Polarity

> You can use the magnetic pole detection device designed by @Wanzi to detect the magnetic poles of a magnet. 
> [Magnet Polarity Detector - Link Makerworld](https://makerworld.com.cn/zh/models/1141340)
{.is-info}

Find a container and add water

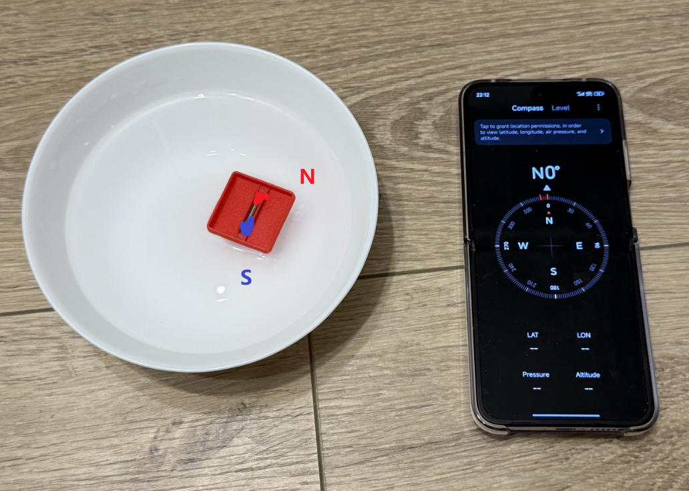
[picture p49: assets/images/bmcu_c_hall/Magnet_dirction.png]
Water Container.png


Attach two D3\*10 magnets or one single D3\*20 magnets, place in the [Magnet Polarity Detector](https://makerworld.com.cn/zh/models/1141340), and float on water

The geographic north pole is slightly different from the geomagnetic north pole, so just take the one with a similar direction.

Once stable, the end pointing south is the south pole, the other end is north pole

## Install Magnet in Slider

With slider oriented as shown, insert magnet (south pole near pneumatic)

Important: **Center the magnet in the slider's magnet mounting position**

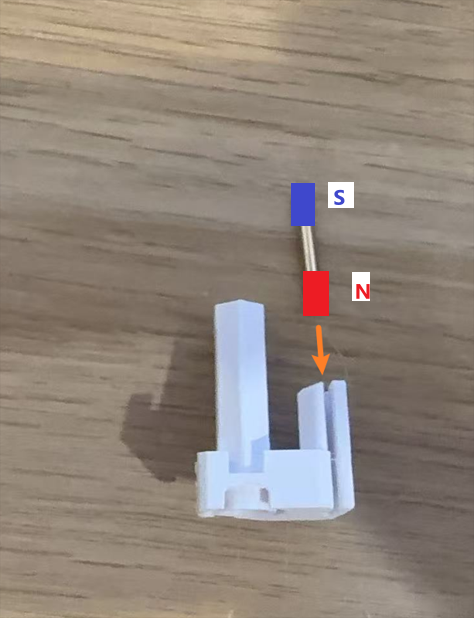
[picture p50: assets/images/bmcu_c_hall/Insert_magnet.png]


> Emergency withdrawal of the picture, previously shown with the wrong magnetic poles!
{.is-danger}

## Secure Slider Magnet

Use M2*8 self-tapping screw to secure

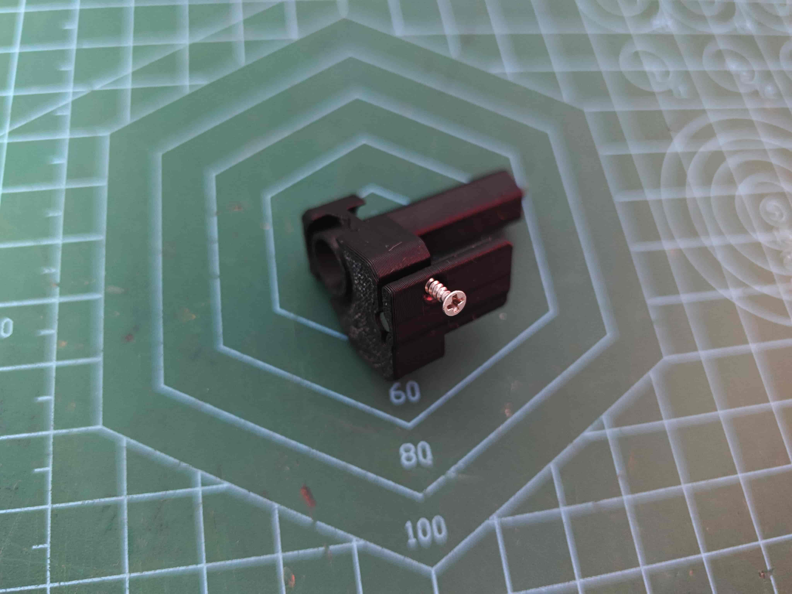
[picture p51: assets/images/bmcu_c_hall/滑块螺丝.jpg]
Secure Slider Magnet


## Install Motor

Place motor in position and secure with M3*5 machine screw

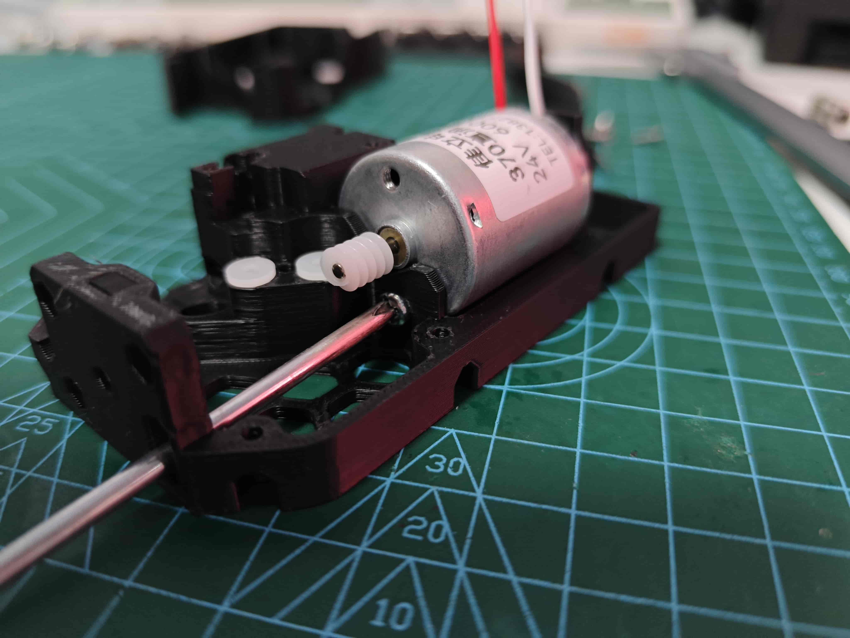
[picture p52: assets/images/bmcu_c_hall/电机螺丝.jpg]
Install Motor


## Install Nut and Nut Plug

Place M3 hex nut in recess and insert nut plug to secure

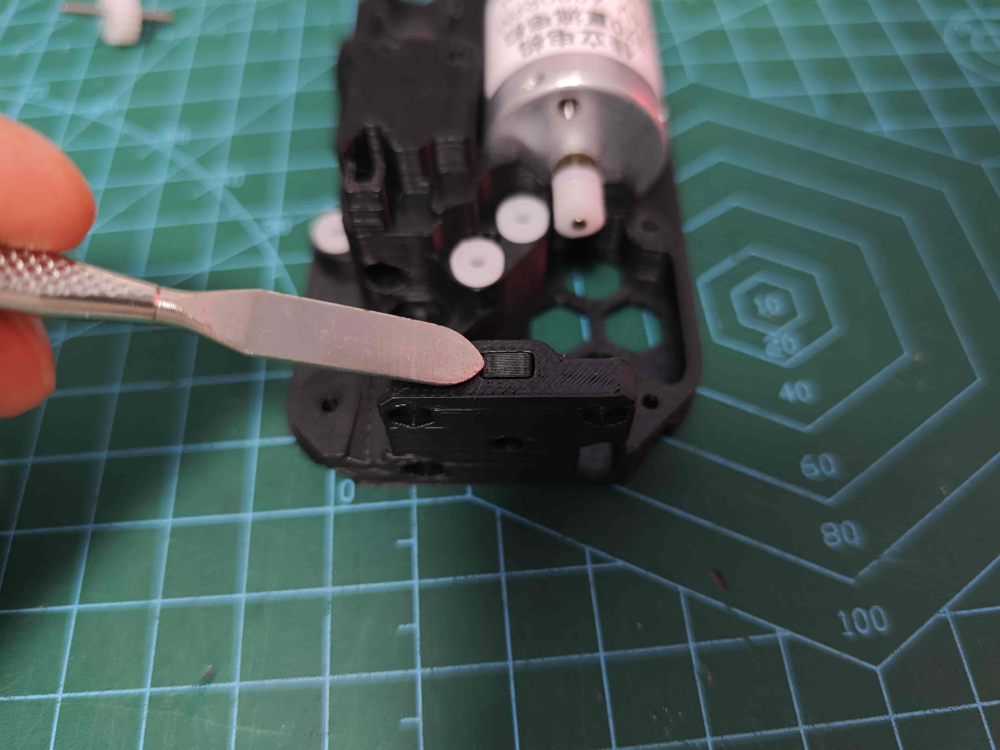
[picture p53: assets/images/bmcu_c_hall/螺母塞.jpg]
Install Nut and Plug


## Install Gear

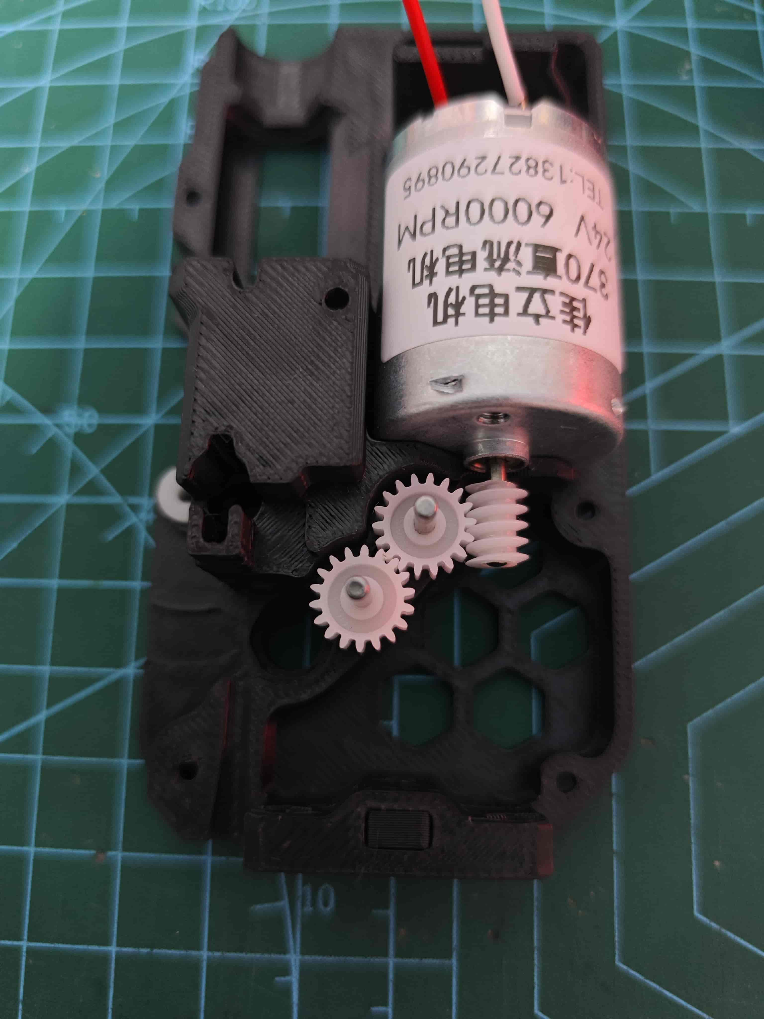
[picture p54: assets/images/bmcu_c_hall/齿轮.jpg]
Install Gear


## Assemble BMG Drive Wheel

These are all the parts included in the BMG gear set:

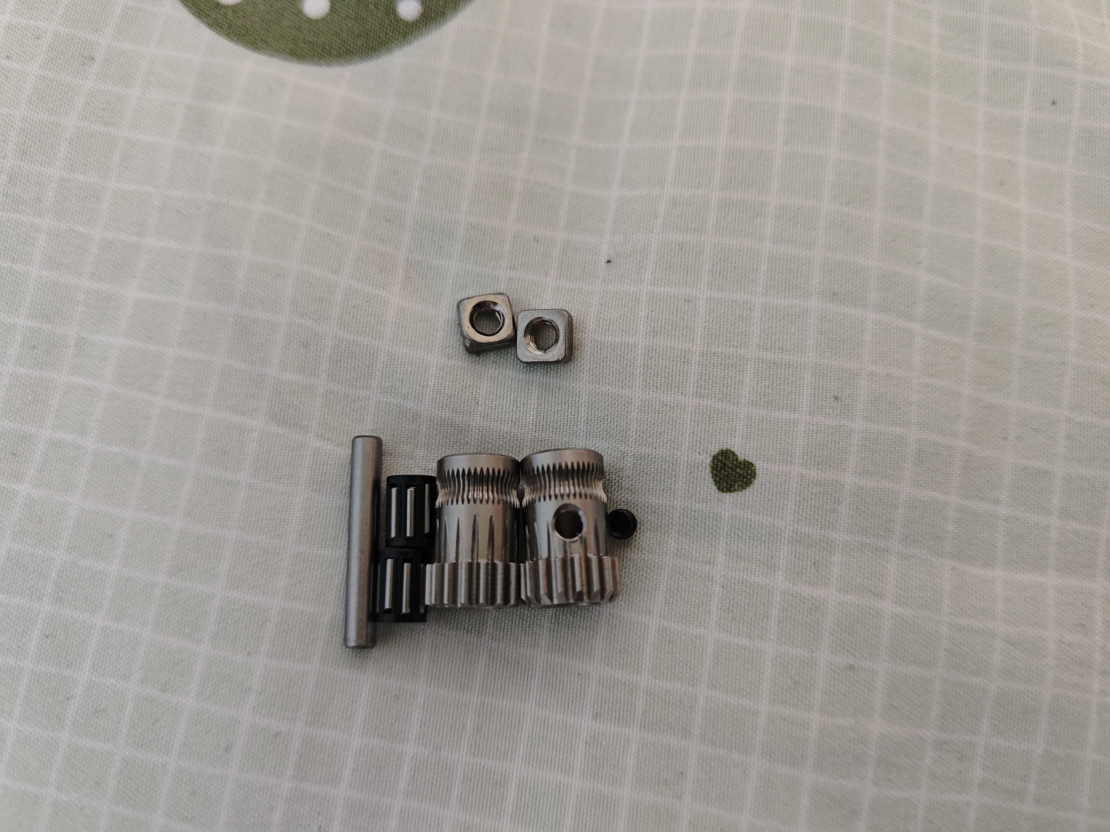
[picture p55: assets/images/build-370/components/BMG齿轮套装.jpg]
BMG Gear Set


Take one **D5x22mm shaft** and two **MR85ZZ bearings**. Press the shaft into one bearing until flush.

> Apply even force during installation. Install the shaft vertically to avoid damaging the bearing. Check shaft precision before use—some may not be perfect.
{.is-warning}

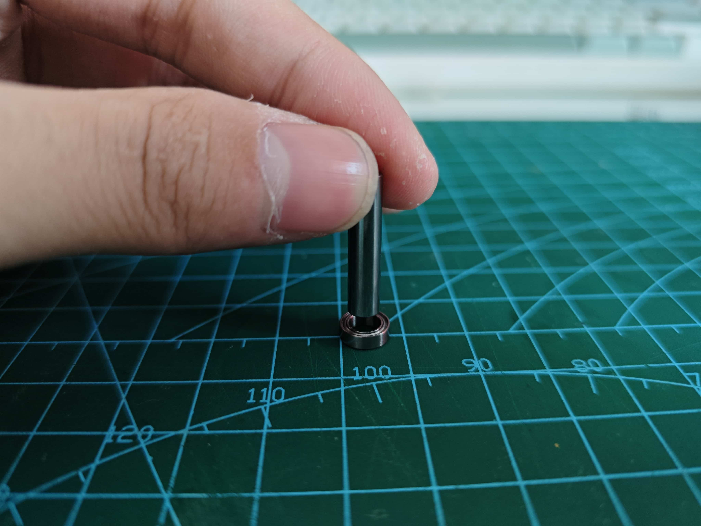
[picture p56: assets/images/build-370/components/组装bmg主动轮-1-底部轴承.jpg]
BMG Drive Gear Step 1 - Bottom Bearing

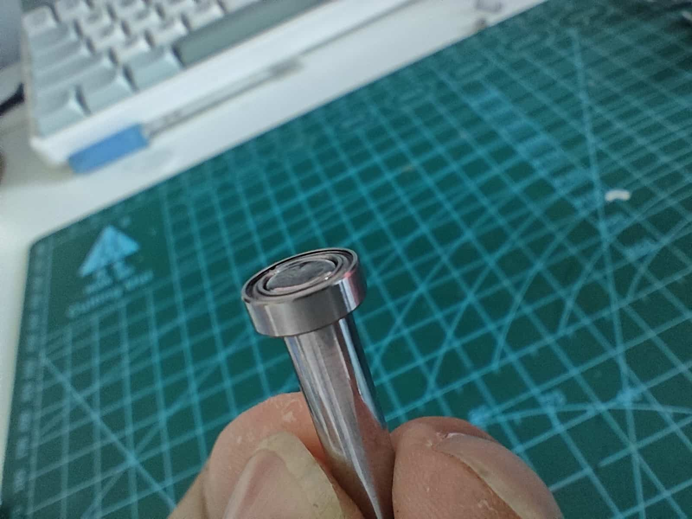
[picture p57: assets/images/build-370/components/组装bmg主动轮-2-底部轴承安装到位.jpg]
BMG Drive Gear Step 2 - Bearing In Place


Place the **BMG gear with set screw hole** as shown:

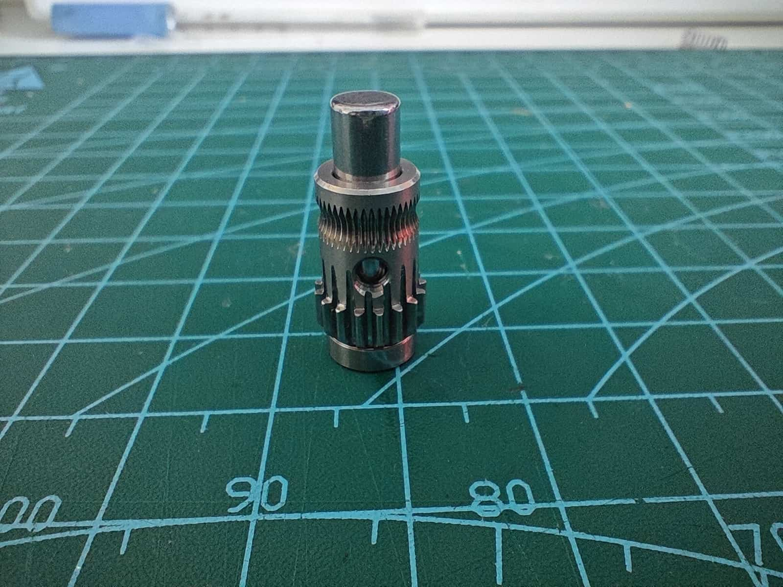
[picture p58: assets/images/build-370/components/组装bmg主动轮-3-bmg.jpg]
BMG Drive Gear Step 3 - Insert BMG Gear


Insert the **set screw** using a hex key.

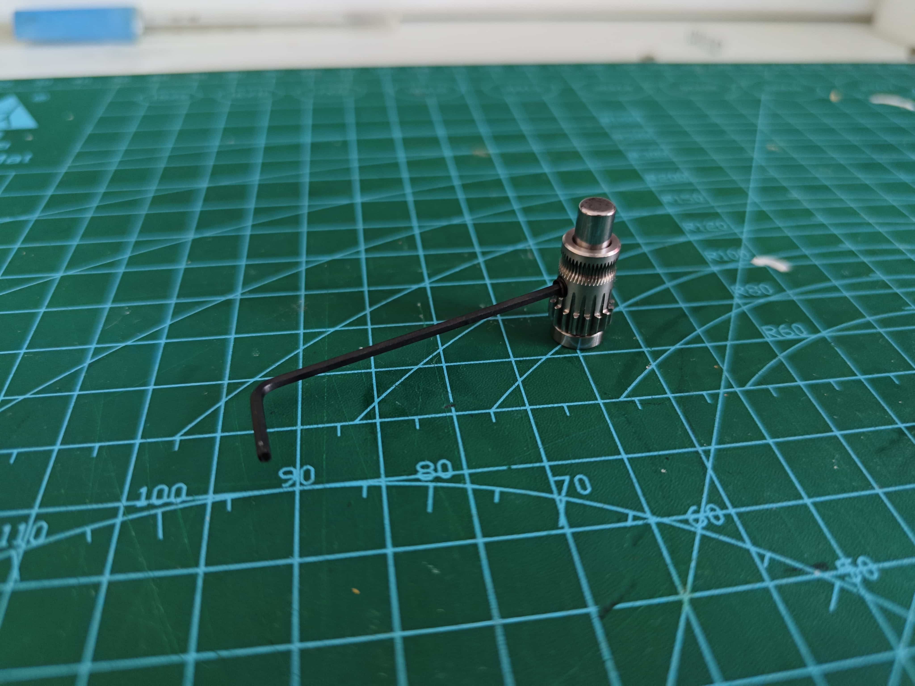
[picture p59: assets/images/build-370/components/组装bmg主动轮-4-顶丝.jpg]
BMG Drive Gear Step 4 - Set Screw


Install the **top bearing**, ensuring it sits flush against the gear.

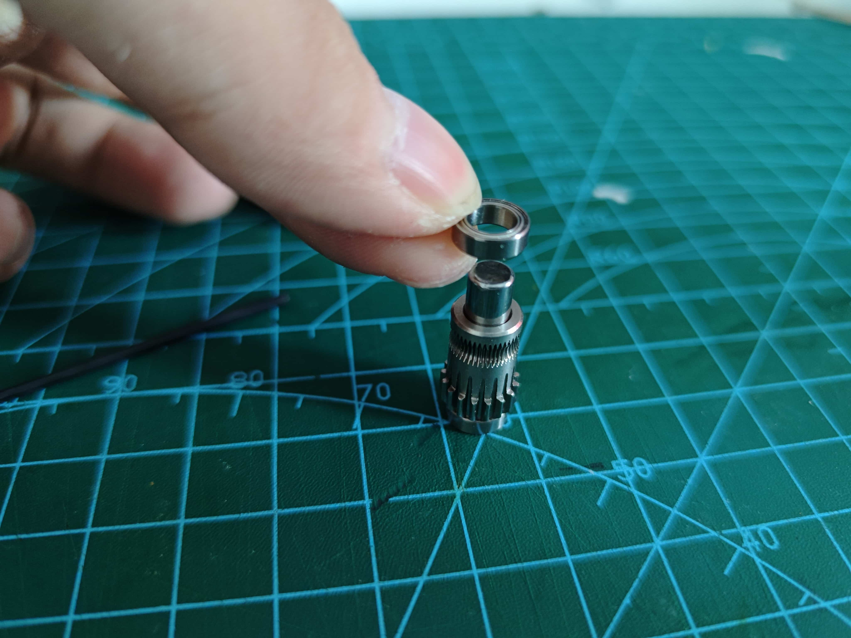
[picture p60: assets/images/build-370/components/组装bmg主动轮-5-顶部轴承.jpg]
BMG Drive Gear Step 5 - Top Bearing

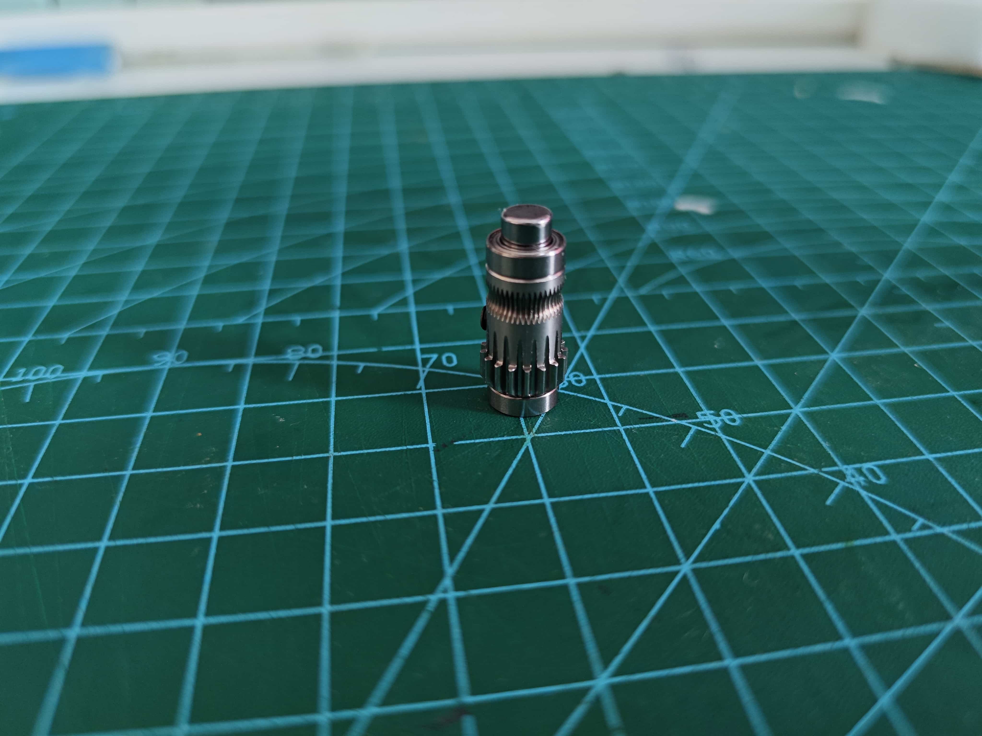
[picture p61: assets/images/build-370/components/组装bmg主动轮-6-完成.jpg]
BMG Drive Gear Step 6 - Completed


Place the assembled **BMG drive gear** into the back frame, gear facing upward.

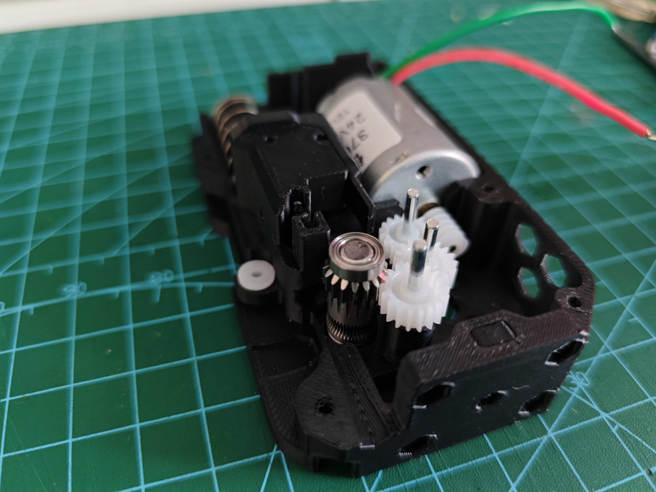
[picture p62: assets/images/build-370/components/把bmg主动轮放入后盖.jpg]
Insert BMG Drive Gear


### Assemble BMG Driven Wheel

Insert two **needle bearings** into the **Driven gear (no set screw hole)**.

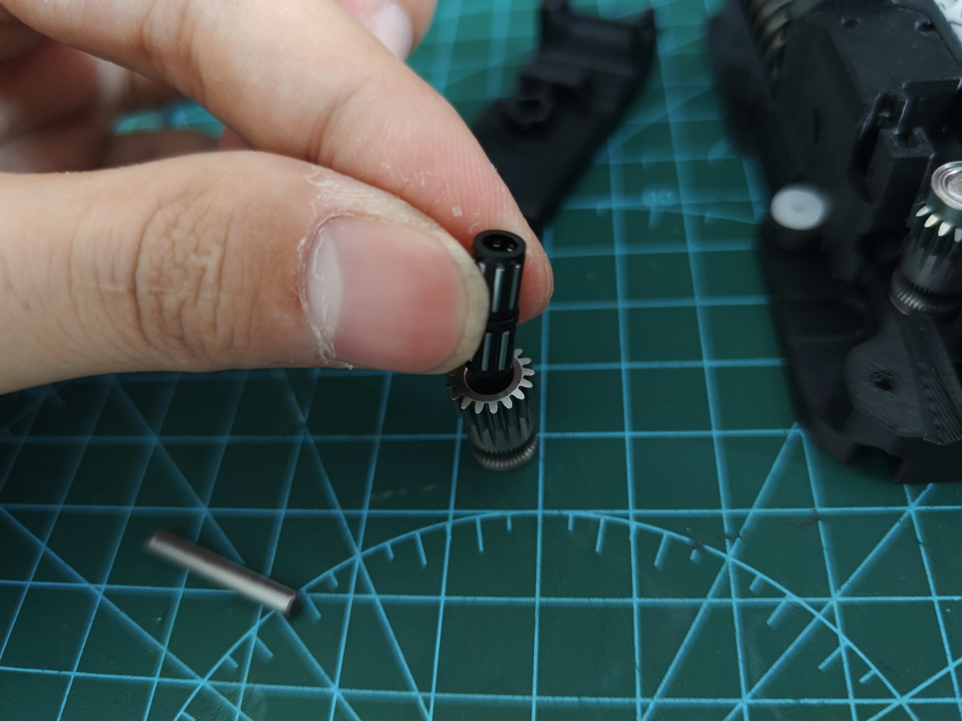
[picture p63: assets/images/build-370/components/组装bmg从动轮-1-放入滚针轴承.jpg]
Driven Gear Step 1 - Insert Needle Bearings


Place it into the **lever**, making sure the direction is correct, and insert the shaft from the BMG kit.

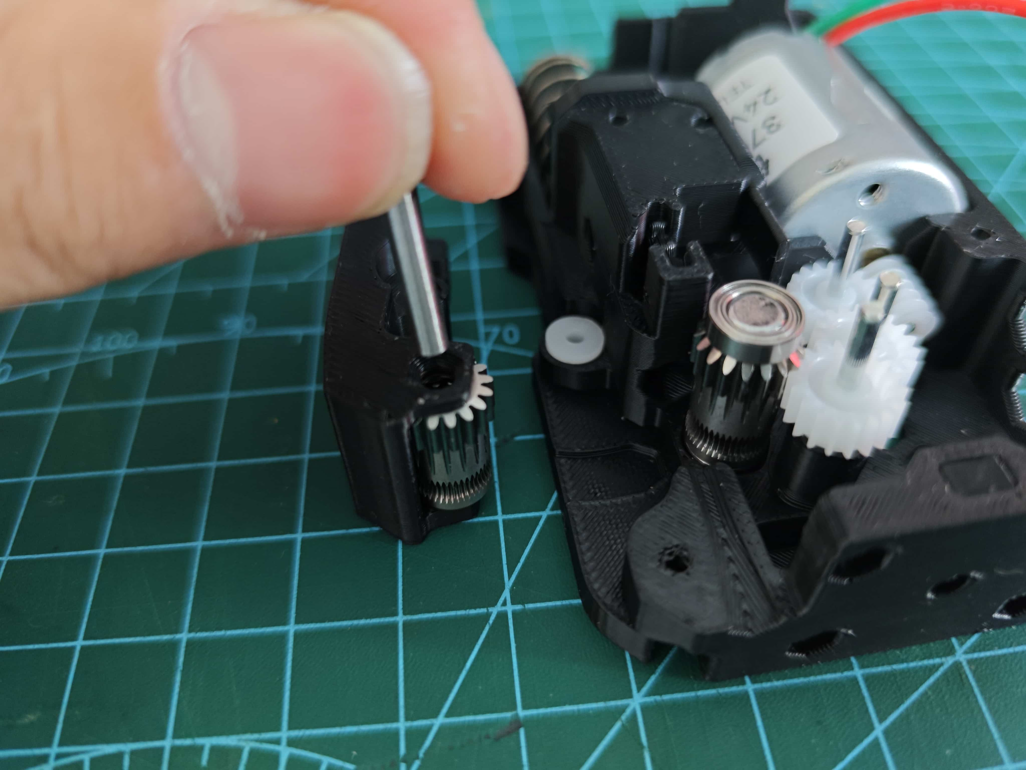
[picture p64: assets/images/build-370/components/组装bmg从动轮-2-放入扳手-插入轴.jpg]
Driven Gear Step 2 - Insert into Lever


## Install BMG Drive Wheel

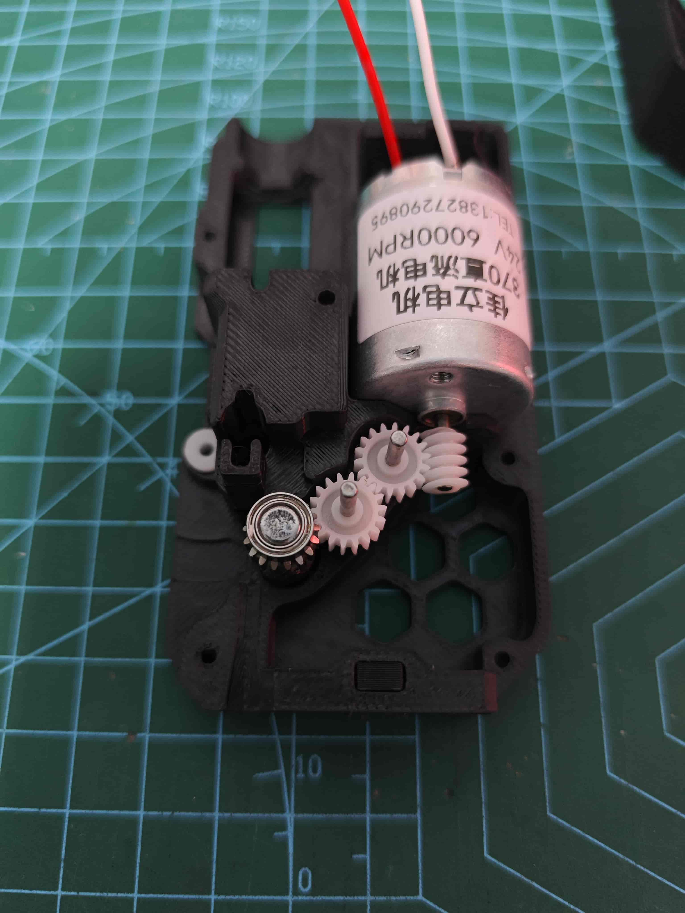
[picture p65: assets/images/bmcu_c_hall/bmg.jpg]
Install BMG Drive Wheel


## Install Ball Bearings

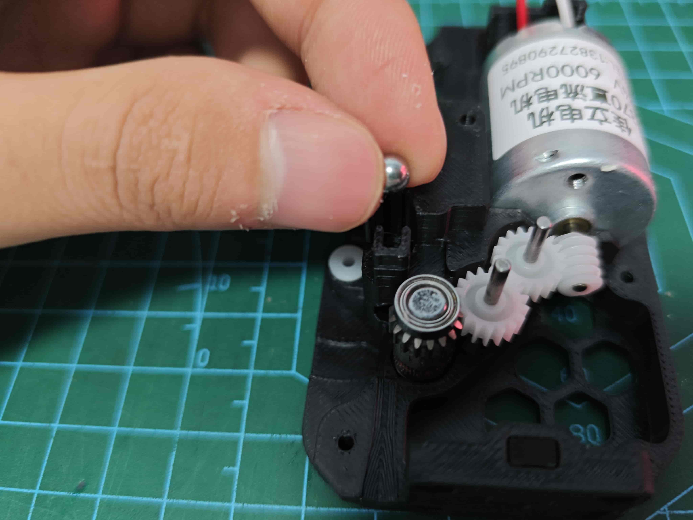
[picture p66: assets/images/bmcu_c_hall/钢珠.jpg]
Install Ball Bearings


## Install Filament Break Slider

Note slider orientation

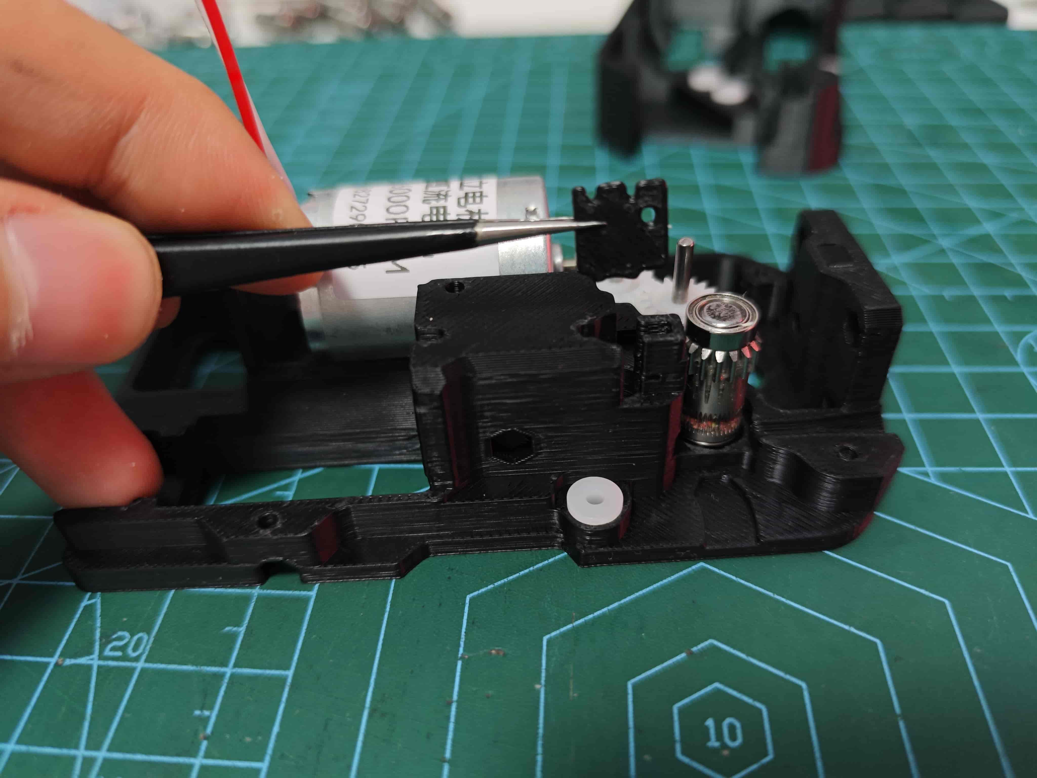
[picture p67: assets/images/bmcu_c_hall/断料滑块.jpg]
Install Filament Break Slider


## Apply Grease

> Here @Wanzi uses lubricant, but please note that we do not recommend the use of lubricant, but rather a grease with a certain viscosity, such as the one supplied with the Bambulab machine.
>
> But also, you should not choose a grease with too high a viscosity, for example, it is not recommended to use a grease for bicycles.
{.is-warning}

Lubricate gears (can remove to apply and reinstall, BMG doesn't need lubrication)

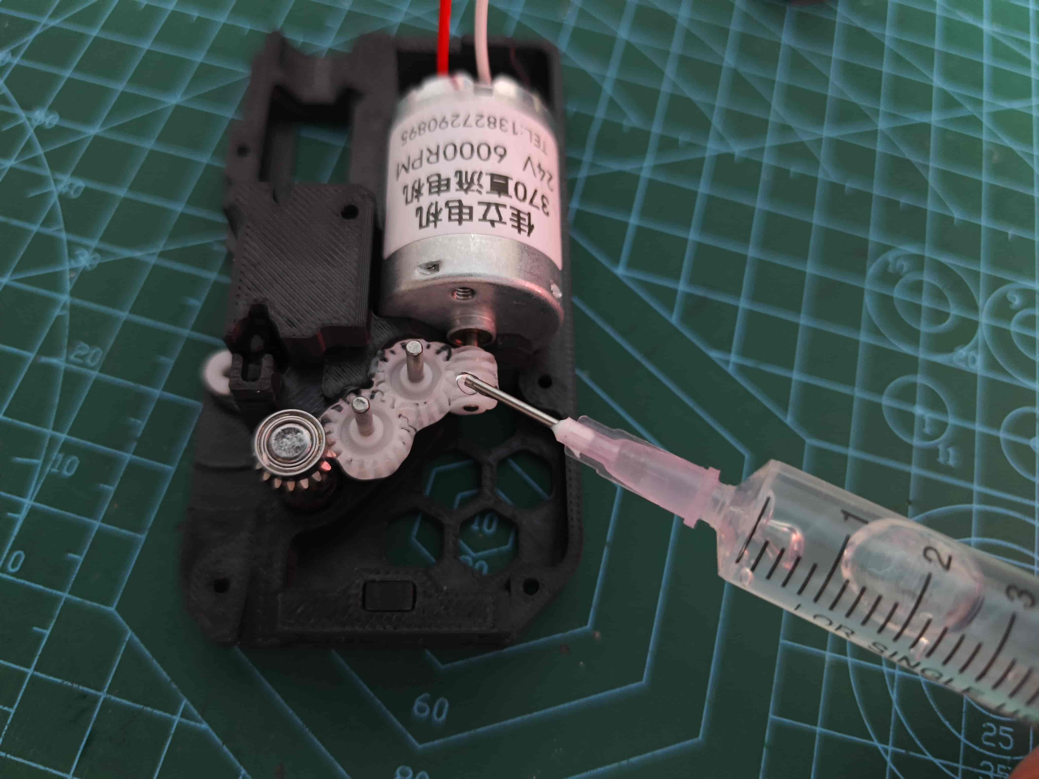
[picture p68: assets/images/bmcu_c_hall/润滑齿轮.jpg]
Lubricate Gears


Lubricate slider (optional)

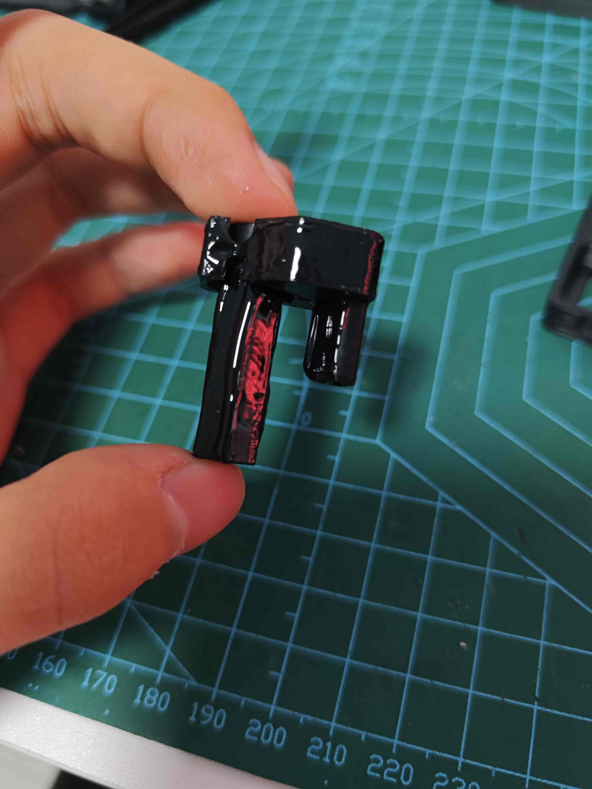
[picture p69: assets/images/bmcu_c_hall/润滑滑块.jpg]
Lubricate Slider


## Install Slider and Springs

Place two `0.8*12*25 springs` at slider ends, secured in mounting positions

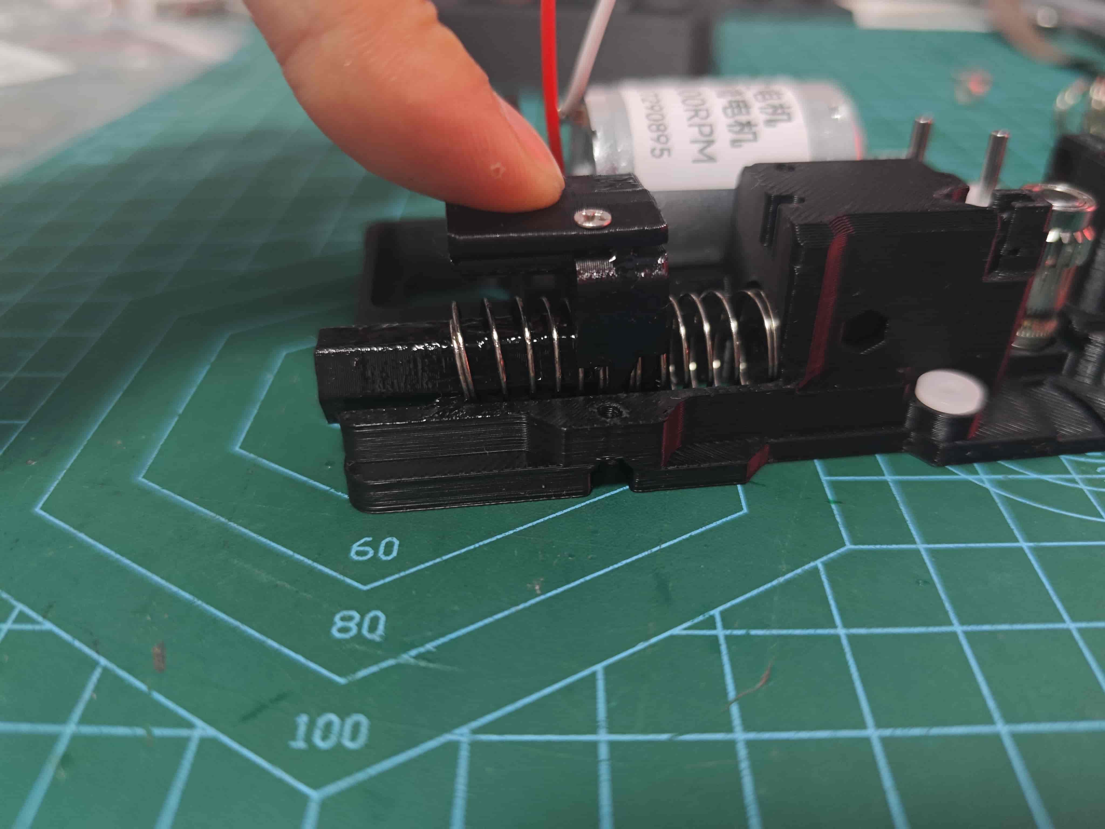
[picture p70: assets/images/bmcu_c_hall/滑块弹簧.jpg]
Install Slider and Springs


## Install Filament Break Slider Spring

Place one `0.3*4*5 spring` above filament break slider

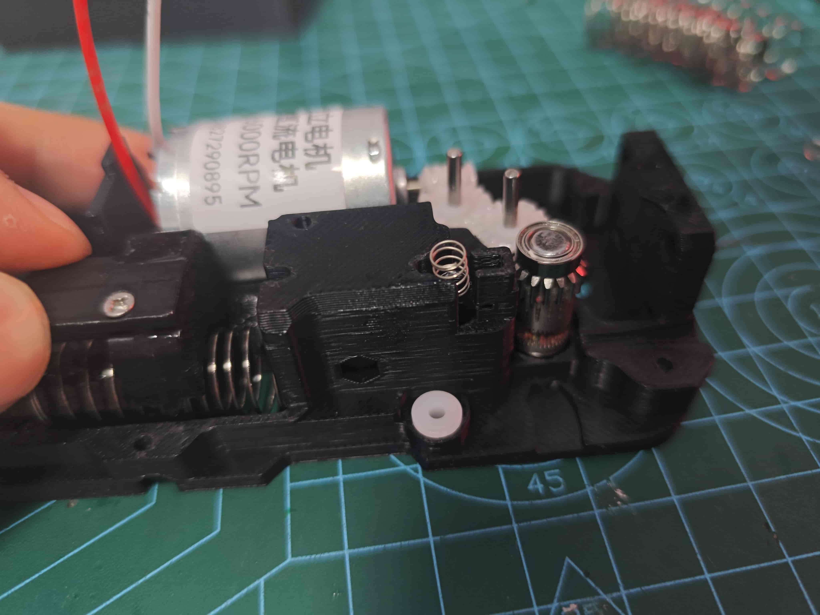
[picture p71: assets/images/bmcu_c_hall/断料滑块弹簧.jpg]
Install Filament Break Spring


## Install Middle Frame

Attach middle frame to back cover, ensuring magnet portion of slider passes through

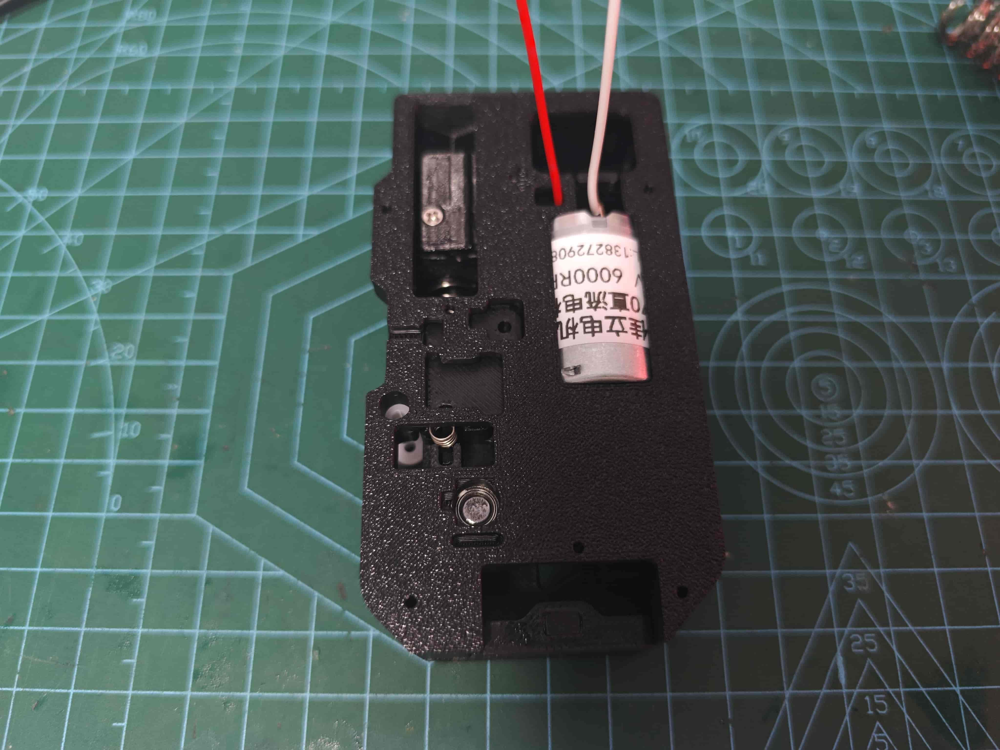
[picture p72: assets/images/bmcu_c_hall/中框.jpg]
Install Middle Frame


Secure with five M2*8 self-tapping screws

## Install Lever

> If available, now we recommend 0.6*4*15 springs, currently 10 lengths are considered too weak!
{.is-warning}

Place one ~~`0.6*4*10`~~ `0.6*4*15 spring`in position, then install lever

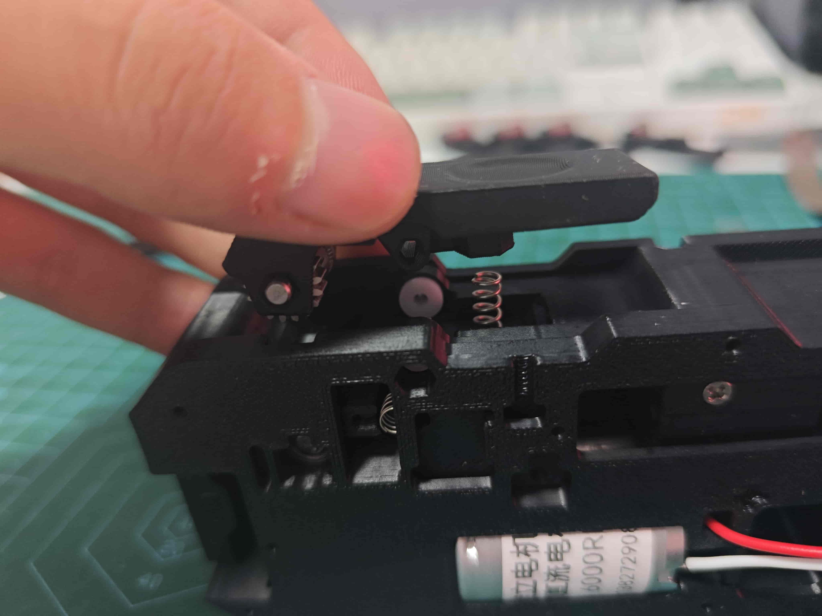
[picture p73: assets/images/bmcu_c_hall/扳手1.jpg]
Install Lever 1


Hold lever and insert D2*20 shaft

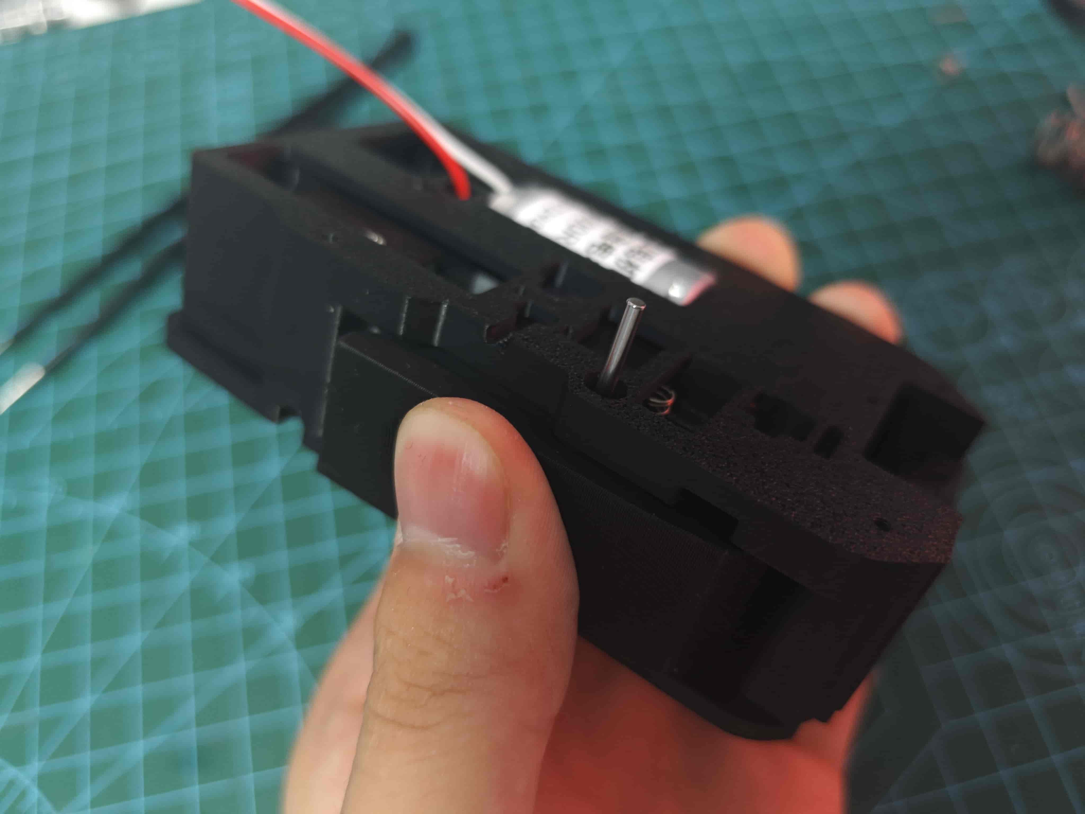
[picture p74: assets/images/bmcu_c_hall/扳手2.jpg]
Install Lever 2


Press firmly to bottom, then use screwdriver to press into recess

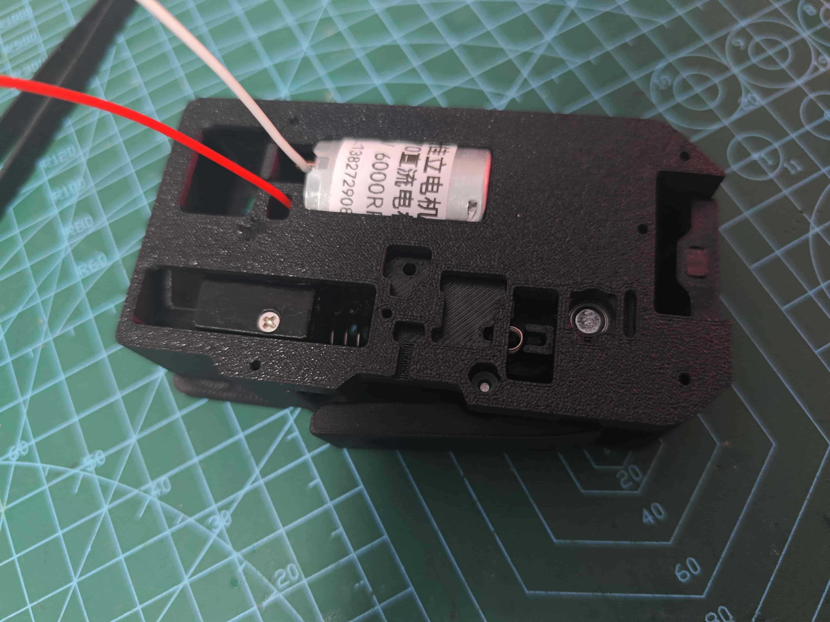
[picture p75: assets/images/bmcu_c_hall/扳手3.jpg]
Install Lever 3


## Install Radial Magnet

Attach D6*2.5 radial magnet above BMG drive wheel, ensuring it's not compressed and rotates with BMG (important)

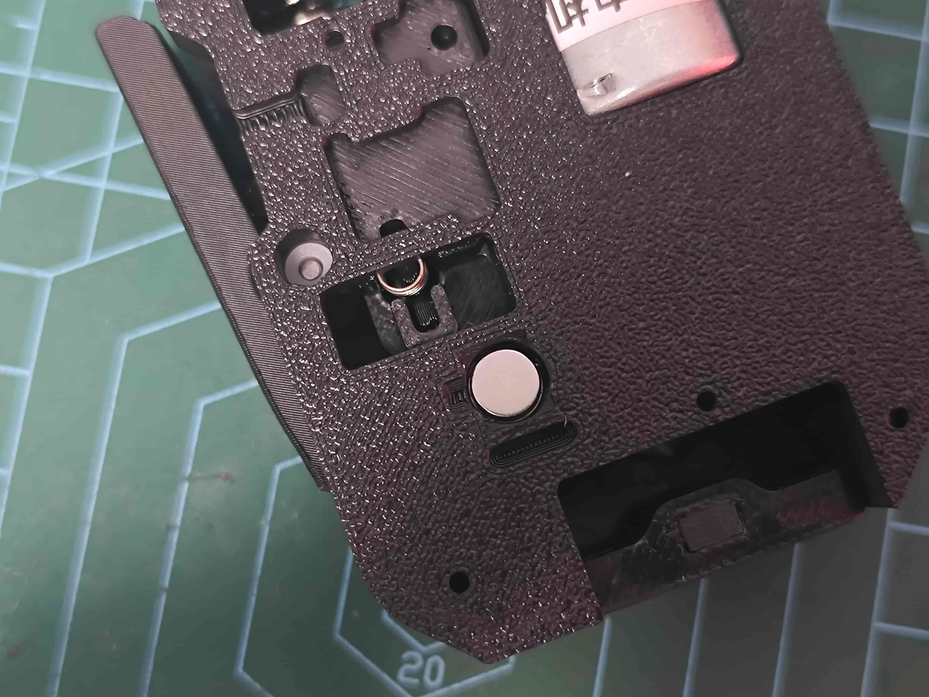
[picture p76: assets/images/bmcu_c_hall/径向磁铁.jpg]
Install Radial Magnet


> At this point, insert filament and power motor with 12v~24v to `test filament feeding`, `verify magnet rotation`, and `distribute lubricant`
{.is-info}

## Install Light Guider fiber

Insert 1.5mm fiber optic or simply a transparant PETG filament into small hole next to buffer slider, cut flush, for light guide

## Install Sub-board

Place sub-board in position

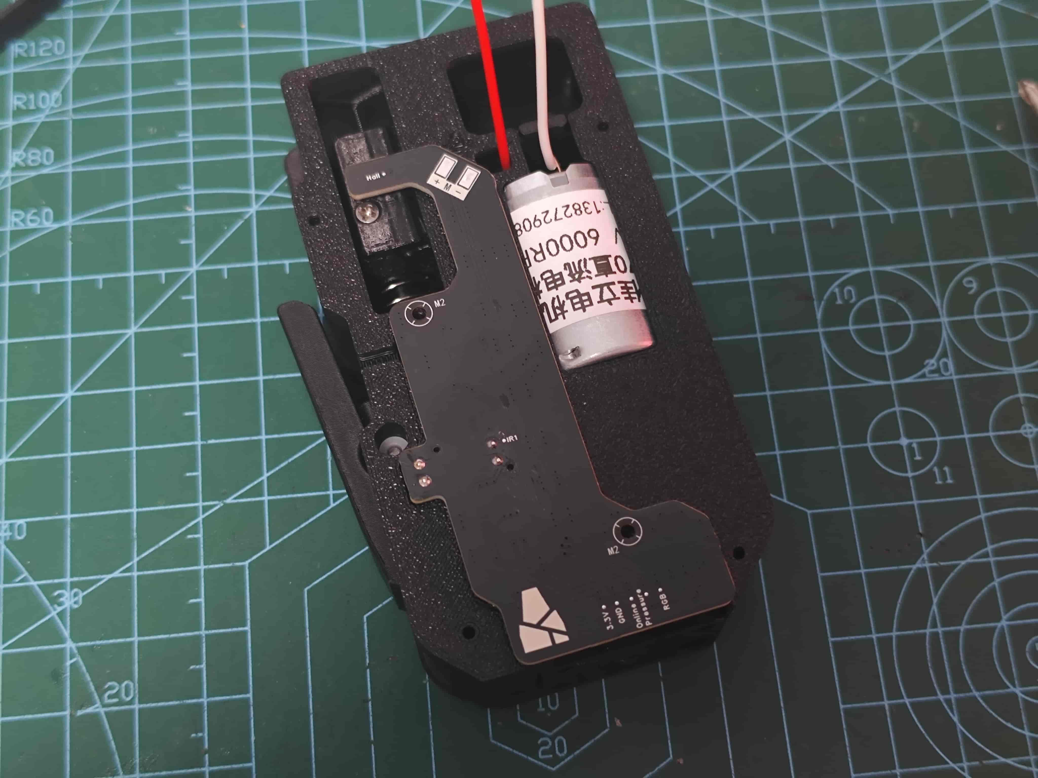
[picture p77: assets/images/bmcu_c_hall/副板.jpg]
Install Sub-board


Secure with two M2*8 self-tapping screws and solder motor wires

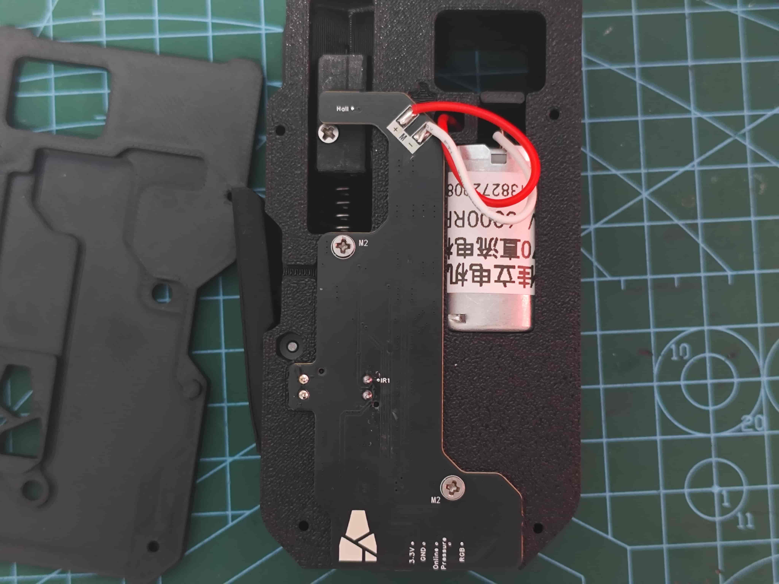
[picture p78: assets/images/bmcu_c_hall/固定副板并焊接电机线.jpg]
Secure and Solder


Tuck excess wires here

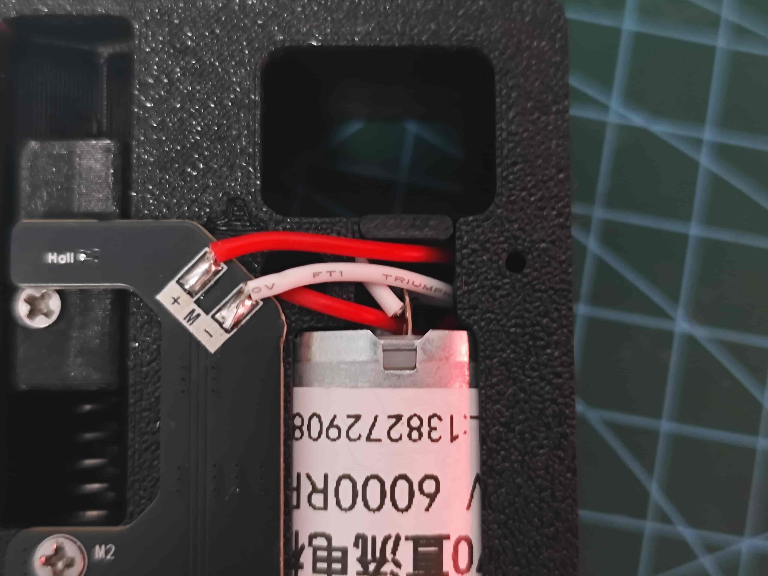
[picture p79: assets/images/bmcu_c_hall/整理线材.jpg]
Organize Wires


## Install Front Cover

Secure with four M2*8 self-tapping screws

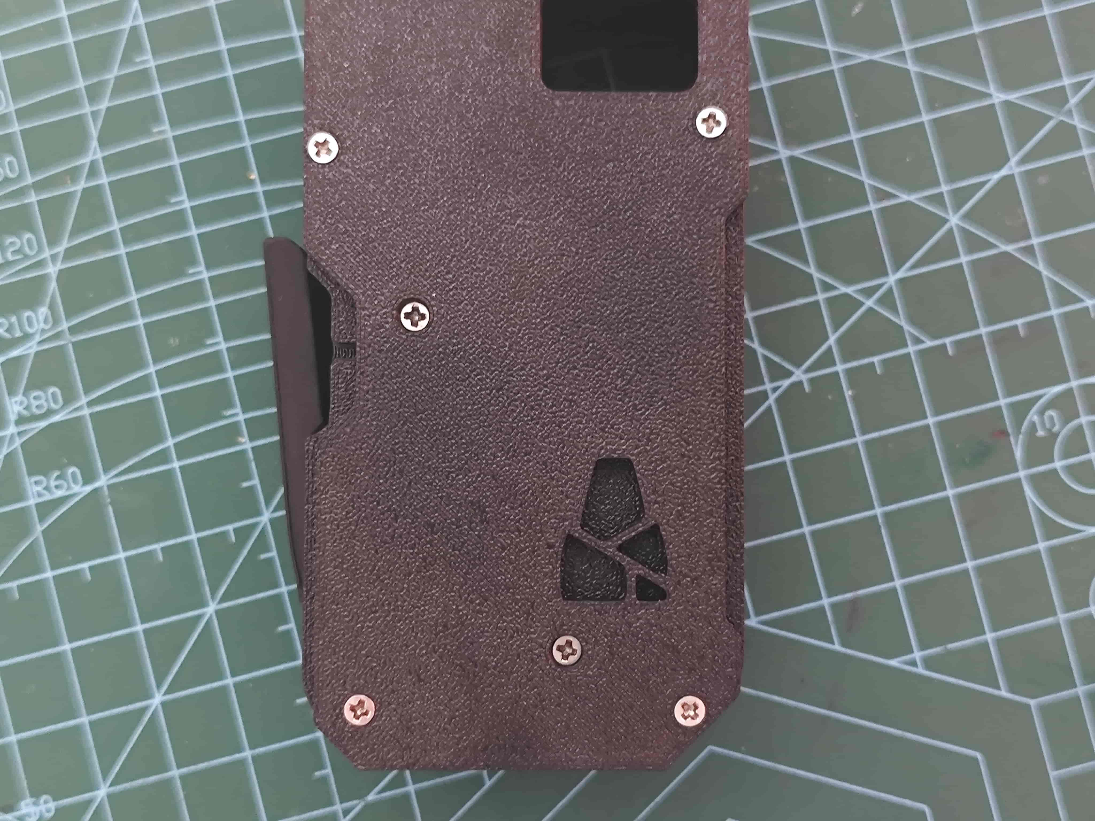
[picture p80: assets/images/bmcu_c_hall/前盖.jpg]
Install Front Cover


## Install Pneumatic Fitting

Screw pneumatic fitting onto slider

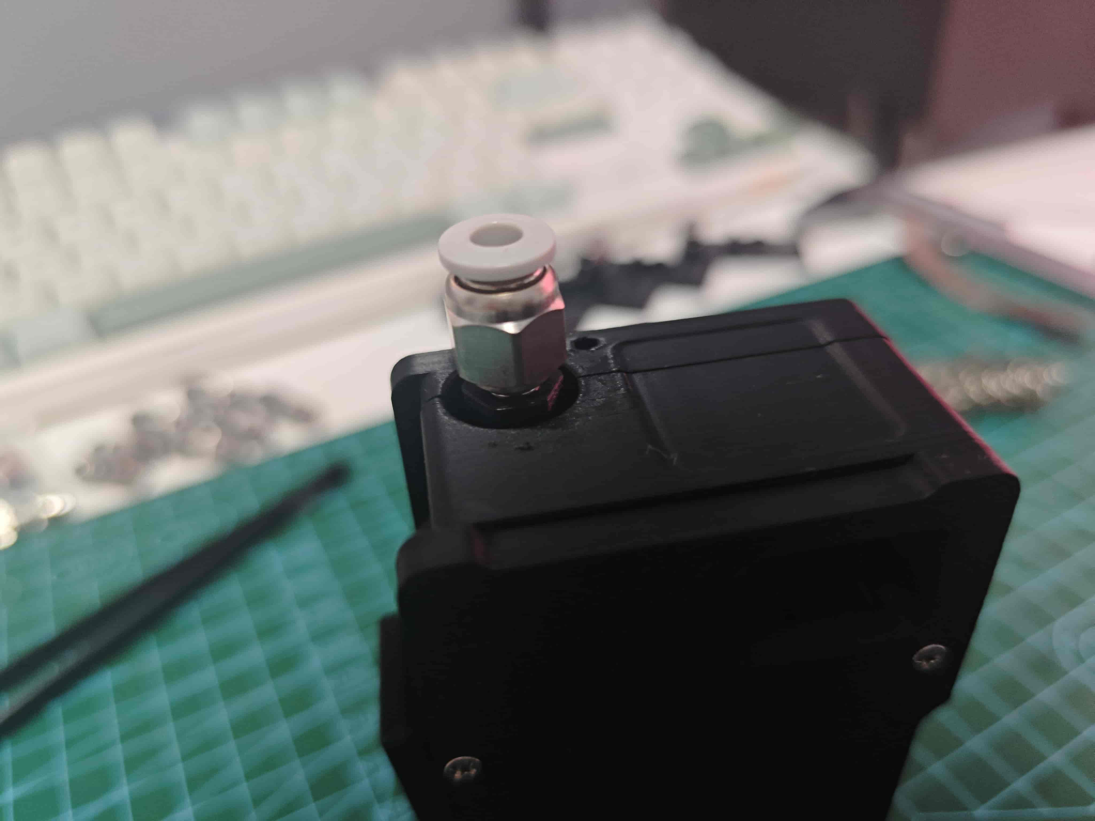
[picture p81: assets/images/bmcu_c_hall/气动接头.jpg]
Install Pneumatic Fitting


# LED Status

> `-` in table indicates no effect on LED or unknown status

| Condition | Side LED | Top LED (Fiber) | Troubleshooting |
| :--- | :--- | :--- | :--- |
| No radial magnet | - | Red | Check radial magnet and AS5600 soldering |
| Normal operation | - | Blue | - |
| Channel selected (in use) | - | White | - |
| No filament | Black | - | - |
| Filament loaded | White | - | - |
| Buffer pressed (slider) | Blue | - | If red, reverse slider magnet |
| Buffer pulled out (slider) | Red | - | If LED blue, reverse slider magnet |

Mainboard: Blue for normal printer communication, red for abnormal, any other color indicates malfunction
