Ykai-f/wiki_yuekai_fr_BMCU/BMCU/BMCU_Tutorial/BMCU_Assembling_370_steel_ball_by_wanzi.md

---
title: BMCU Assembling 370 steel ball version by wanzi
description: 
published: true
date: 2025-04-12T19:36:03.991Z
tags: 
editor: markdown
dateCreated: 2025-03-26T11:09:24.796Z
---

# 370 Steel Ball Version Assembly Guide

This tutorial is made by `@丸子`

There's also an AMAZING video adapted to this release, made by `@Lukas`, [link to youtube](https://www.youtube.com/watch?v=sP-fDCnXkro)

## Introduction

This guide covers the assembly of the 3-14 version of the 370 Steel Ball model. It is also generally applicable to other steel ball versions.

## Preparation Before Assembly

You will need a fully soldered BMCU circuit board. Please ensure there are no soldering defects such as cold joints, missed spots, solder bridges, or incorrect connections.

The firmware must be flashed before assembly. For the flashing guide, please refer to the group files.

Use firmware version **3-14**, which supports both **A series** and **P series**.

✅ Model used in this guide:  
[https://makerworld.com/zh/models/1250311-bmcu-370-steel-ball-version-v3-14#profileId-1272722](https://makerworld.com/zh/models/1250311-bmcu-370-steel-ball-version-v3-14#profileId-1272722)

---

## Feeding Mechanism Assembly

### Component Overview

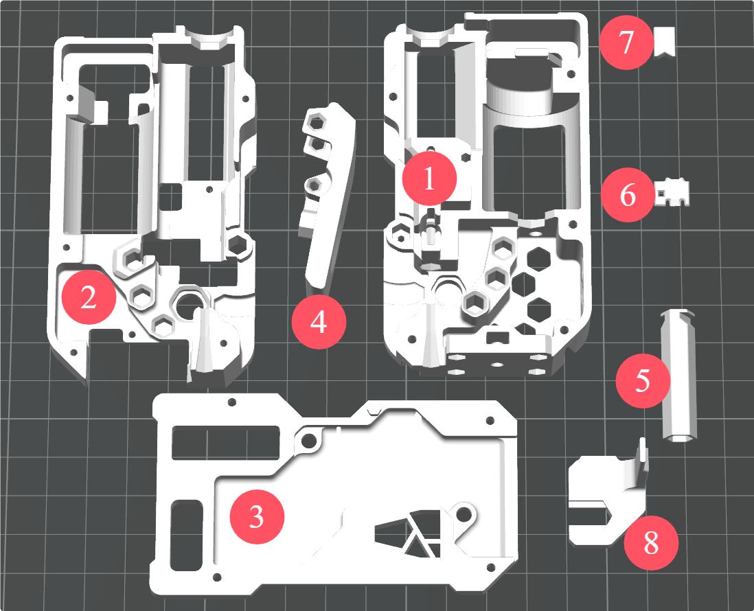
[picture p82: assets/images/build-370/components/组件名称序号.png]
Component Overview


- ① Back Frame
- ② Middle Frame
- ③ Front Frame
- ④ Lever
- ⑤ Buffer Slider Bar
- ⑥ Steel Ball Slider / Filament Break Sensor Slider
- ⑦ Nut block
- ⑧ Buffer slider

---

### Installing the Bushings

Insert the 62B bushings into the back cover and middle frame as shown below:

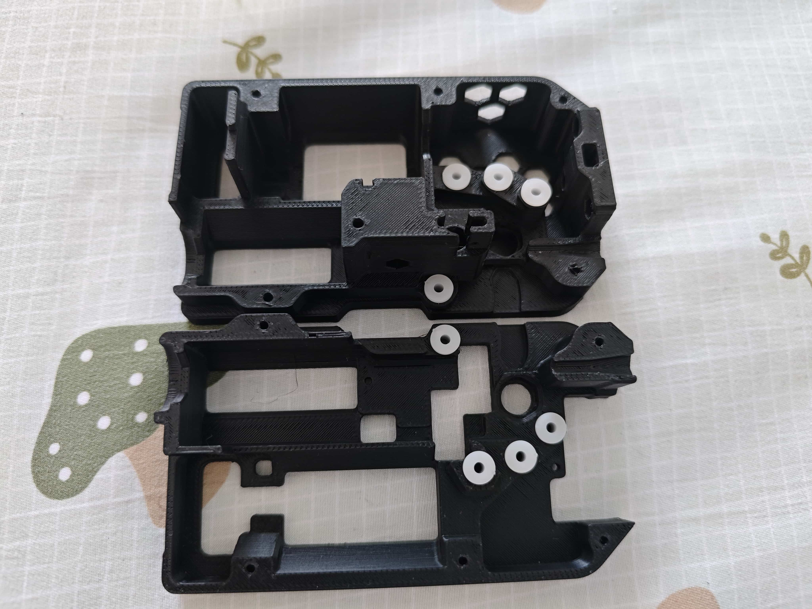
[picture p83: assets/images/build-370/components/安装轴套.jpg]
Install Bushings


---

### Assembling the 182A Gear and 2x20 Shaft

Press the shaft into the gear as shown, ensuring equal lengths extend from both sides.

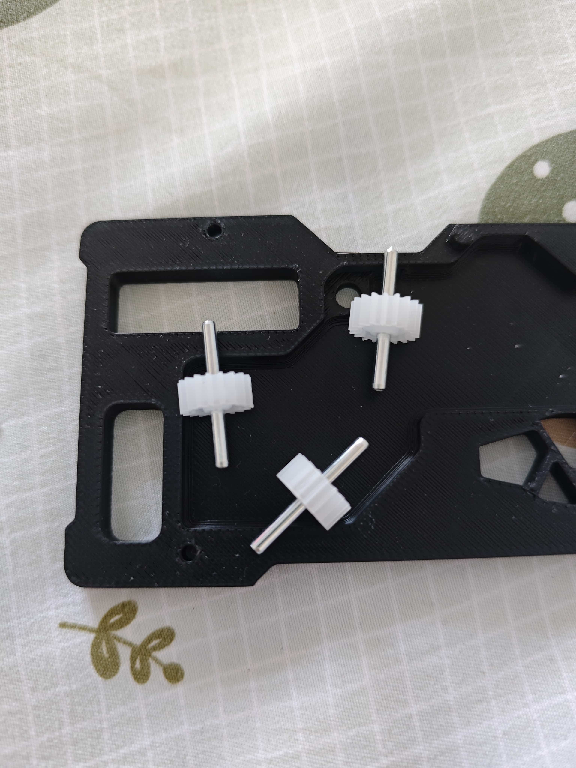
[picture p84: assets/images/build-370/components/给182a齿轮装轴.jpg]
Install Shaft to 182A Gear


---

### Installing the Worm Gear on the 370 Motor

For **Jiali motors**, press the worm gear all the way down. The length should align perfectly.

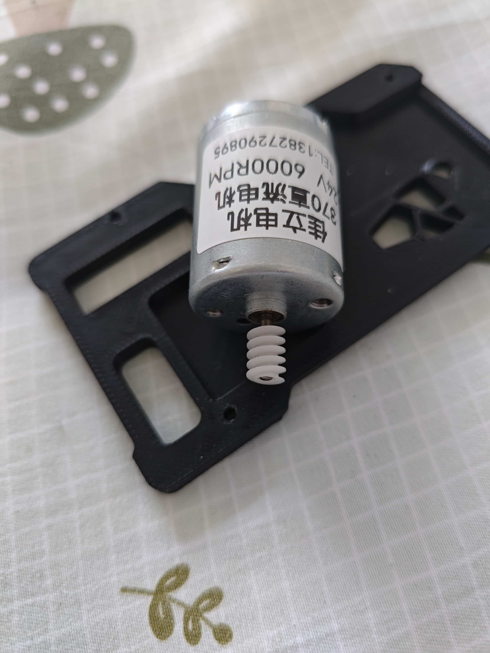
[picture p85: assets/images/build-370/components/给电机装蜗杆.jpg]
Install Worm Gear


---

### Assembling the Buffer Unit

Combine the **Buffer slider** and the **Slider bar**.

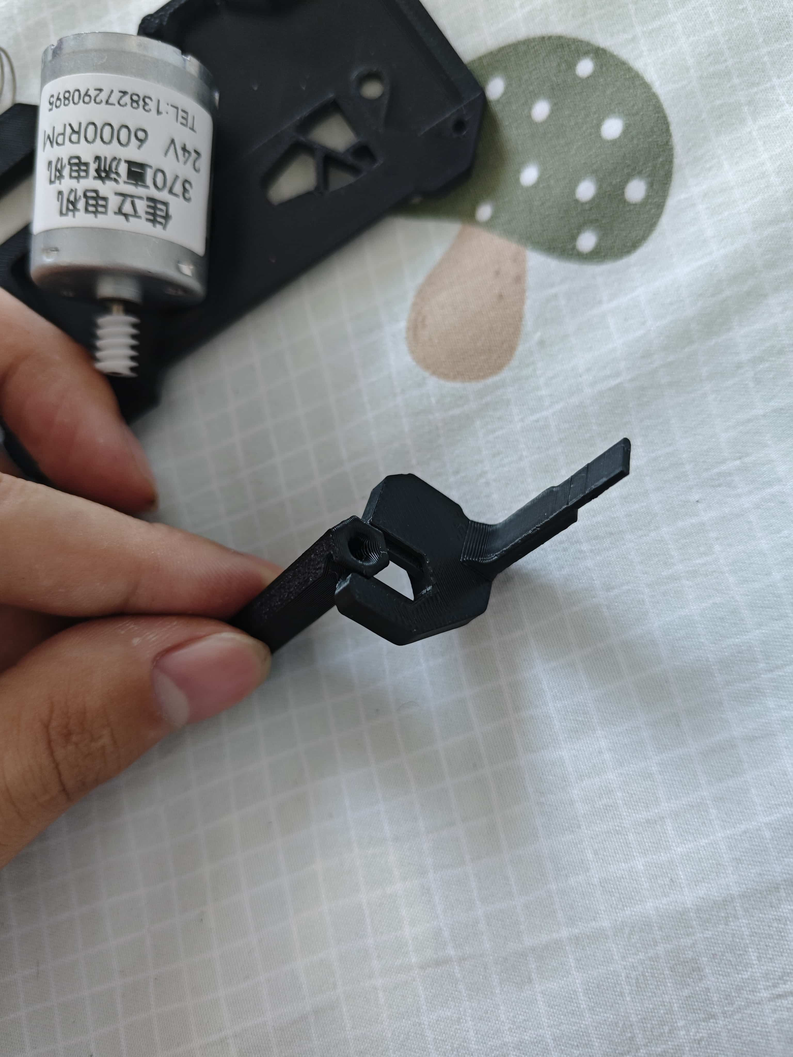
[picture p86: assets/images/build-370/components/组装缓冲-1.jpg]
Buffer Assembly Step 1

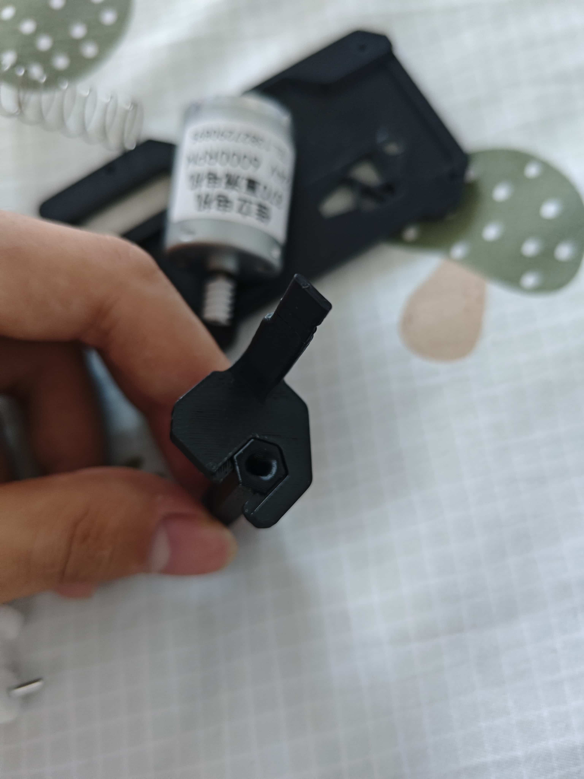
[picture p87: assets/images/build-370/components/组装缓冲-2.jpg]
Buffer Assembly Step 2


Slide the **0.6*12x30mm spring** over the buffer unit and place it into the **back cover**.

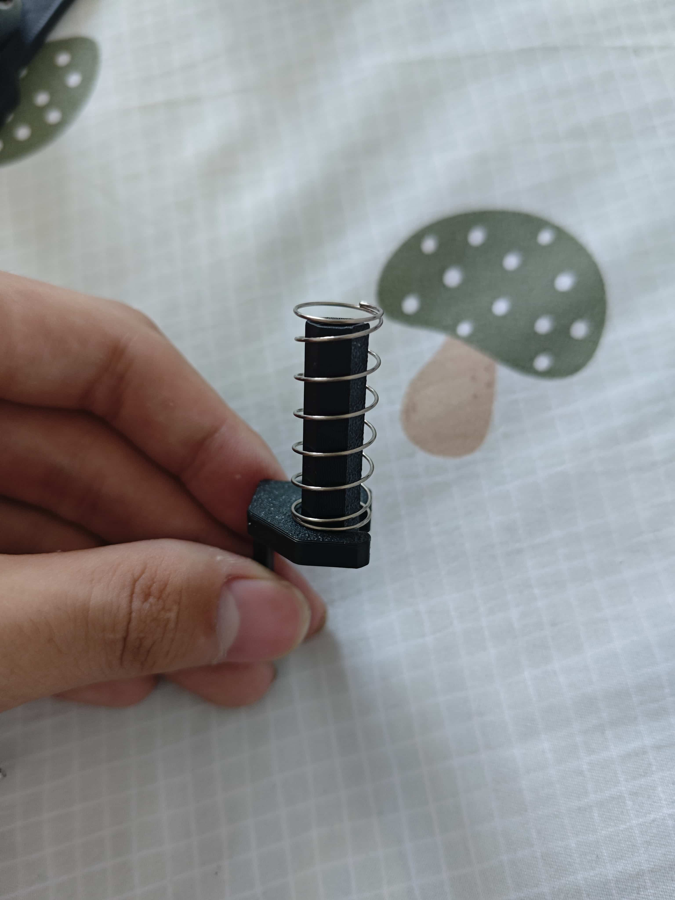
[picture p88: assets/images/build-370/components/组装缓冲-3.jpg]
Buffer Assembly Step 3


Ensure the spring hooks onto the edge of the back cover.

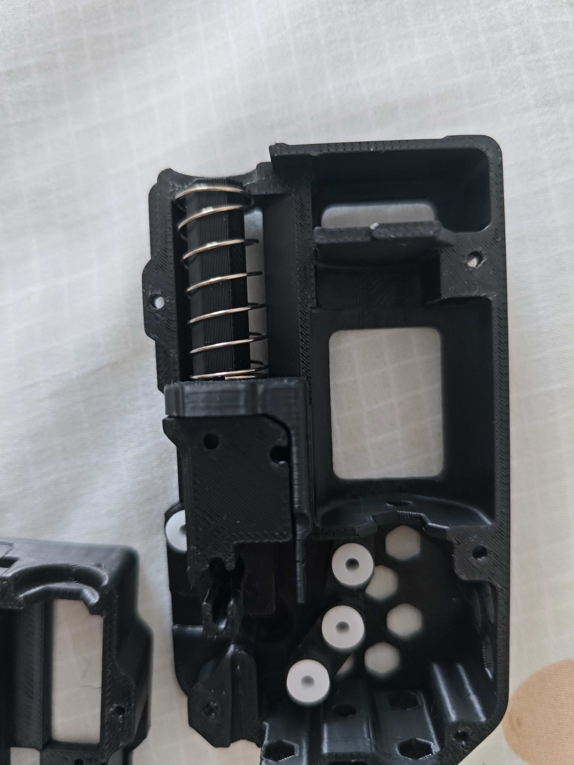
[picture p89: assets/images/build-370/components/组装缓冲-4.jpg]
Buffer Assembly Step 4


---

### Installing the Motor and Gear

Place the motor and the gear into the back frame.

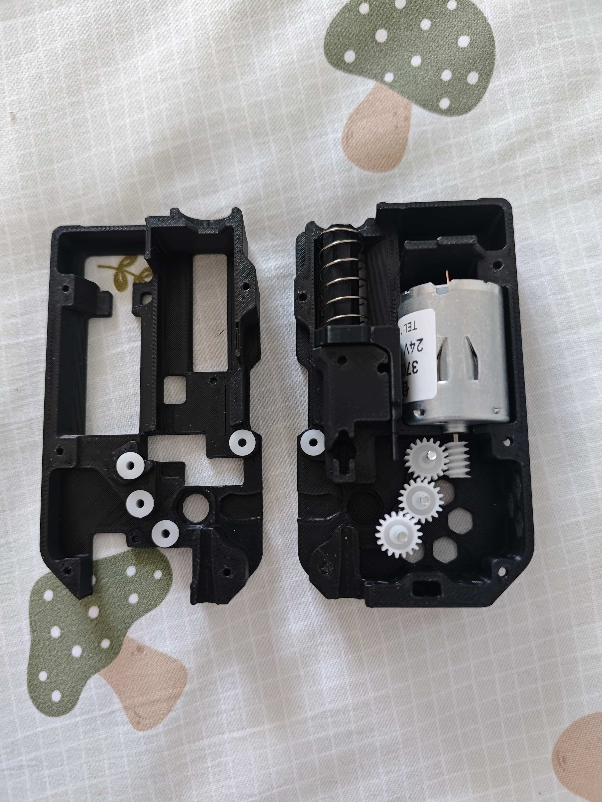
[picture p90: assets/images/build-370/components/把电机和齿轮放入后盖.jpg]
Insert Motor and Gear


Use a screwdriver through the bottom hole and secure the 370 motor with an **M3x5 flathead screw**.

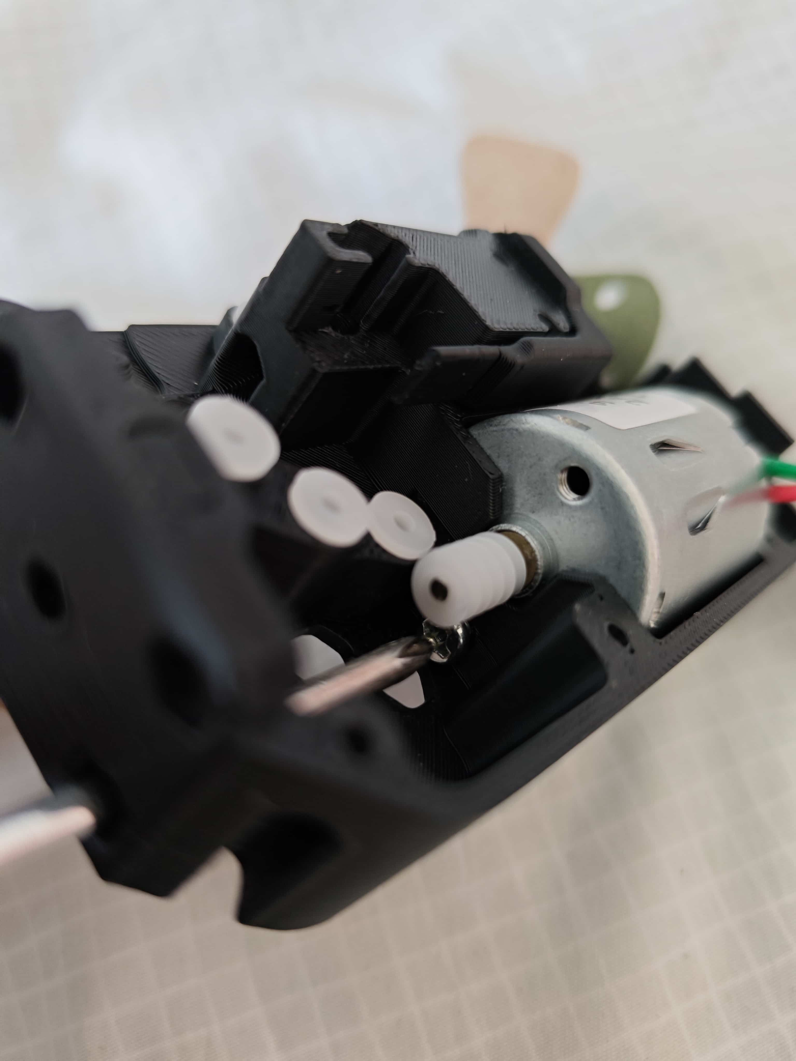
[picture p91: assets/images/build-370/components/固定370电机.jpg]
Secure 370 Motor


---

### Installing the Filament Break Detection Section

Place the **steel ball** into the back frame.

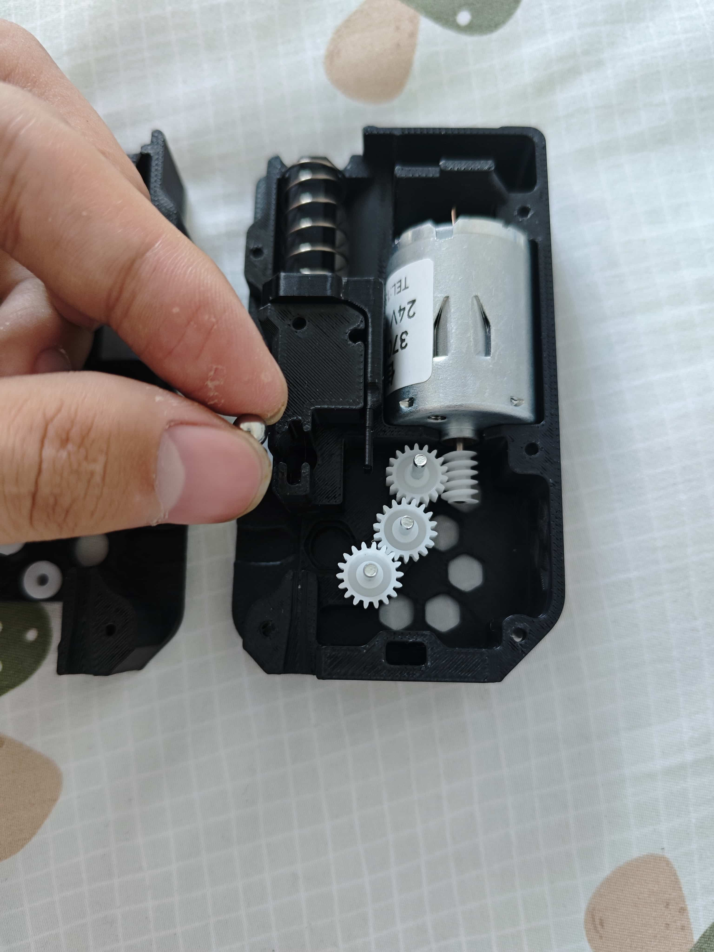
[picture p92: assets/images/build-370/components/把钢珠放入后盖.jpg]
Insert Steel Ball


Then insert the **steel ball slider**.

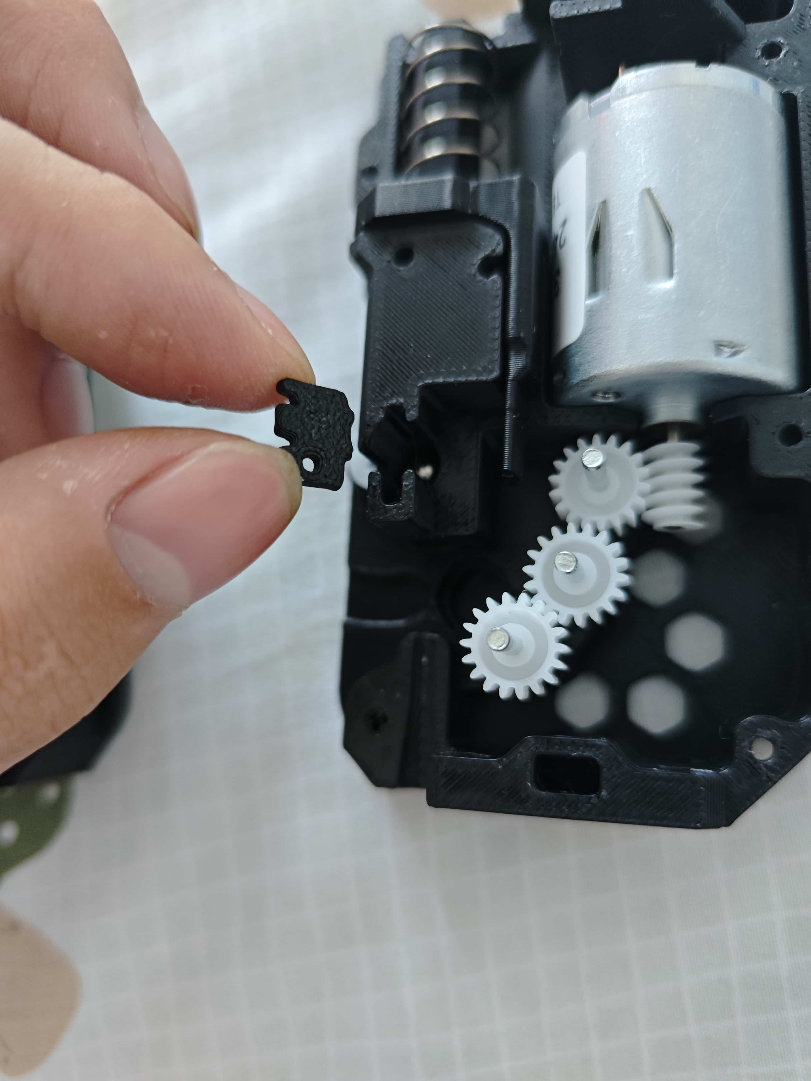
[picture p93: assets/images/build-370/components/把钢珠滑块放入后盖.jpg]
Insert Steel Ball Slider


---

### Installing the Hex Nut

In version 3-14, self-tapping holes are replaced with nuts to prevent thread wear from frequent disassembly.

Insert the **hex nut** into the back cover.

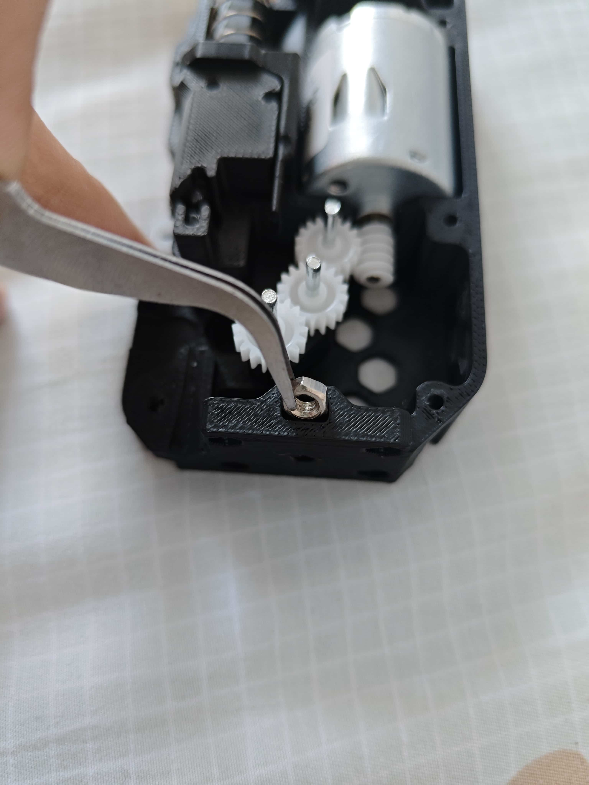
[picture p94: assets/images/build-370/components/把六角螺母放入后盖.jpg]
Insert Hex Nut


Secure it with the **nut insert**.

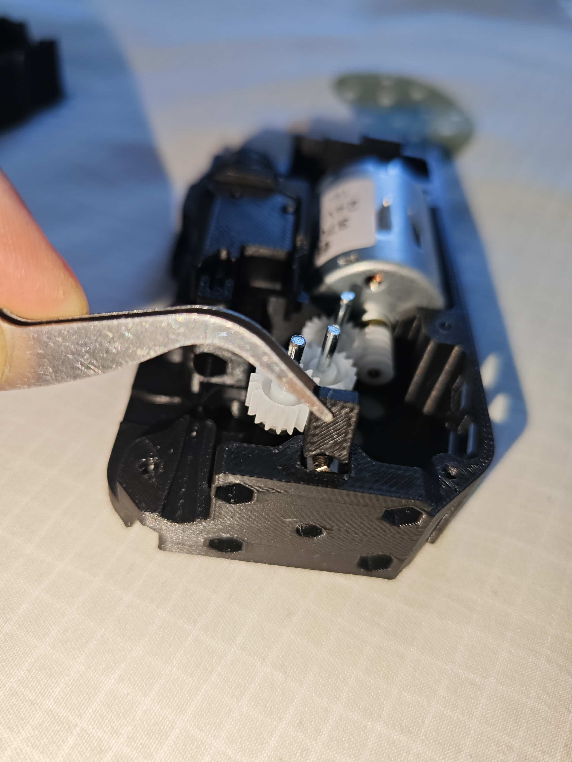
[picture p95: assets/images/build-370/components/放入螺母塞.jpg]
Insert Nut Plug

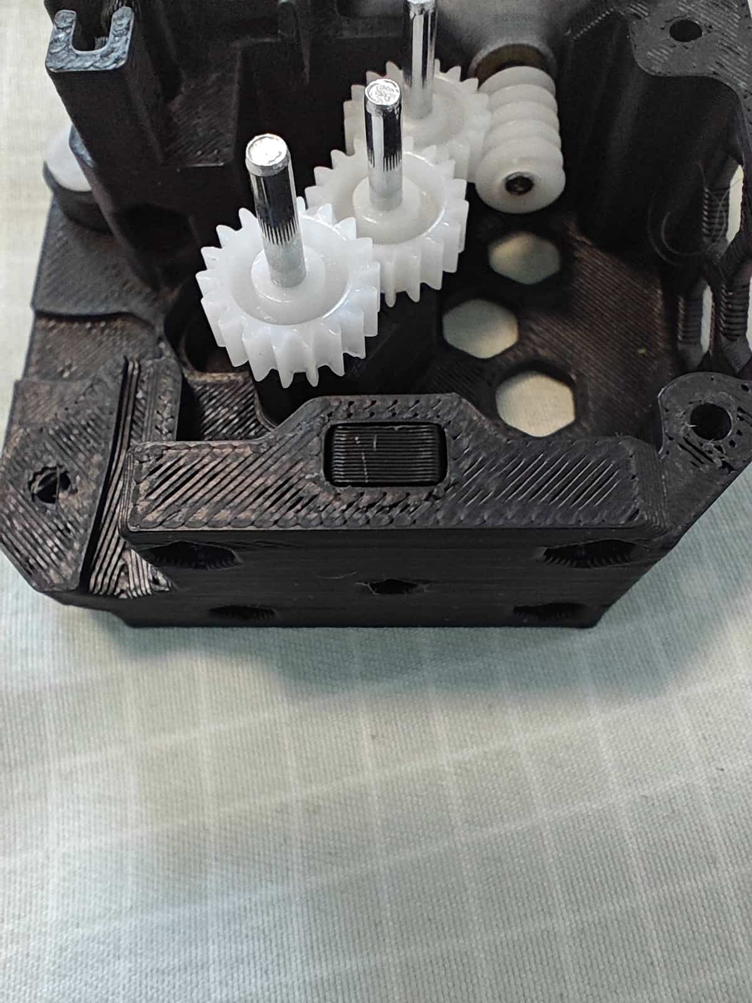
[picture p96: assets/images/build-370/components/把螺母塞安装到位.jpg]
Nut Plug Installed


---

### Assembling the BMG Drive Gear

These are all the parts included in the BMG gear set:

BMG Gear Set

Take one **D5x22mm shaft** and two **MR85ZZ bearings**. Press the shaft into one bearing until flush.

> Apply even force during installation. Install the shaft vertically to avoid damaging the bearing. Check shaft precision before use—some may not be perfect.
{.is-warning}

BMG Drive Gear Step 1 - Bottom Bearing
BMG Drive Gear Step 2 - Bearing In Place

Place the **BMG gear with set screw hole** as shown:

BMG Drive Gear Step 3 - Insert BMG Gear

Insert the **set screw** using a hex key.

BMG Drive Gear Step 4 - Set Screw

Install the **top bearing**, ensuring it sits flush against the gear.

BMG Drive Gear Step 5 - Top Bearing
BMG Drive Gear Step 6 - Completed

Place the assembled **BMG drive gear** into the back frame, gear facing upward.

Insert BMG Drive Gear

---

### Assembling the BMG Driven Gear

Insert two **needle bearings** into the **Driven gear (no set screw hole)**.

Driven Gear Step 1 - Insert Needle Bearings

Place it into the **lever**, making sure the direction is correct, and insert the shaft from the BMG kit.

Driven Gear Step 2 - Insert into Lever

---

### Lubricating the Gears

I used "Tiger Head" hinge and slideway grease. **Do not use oil**—only grease.

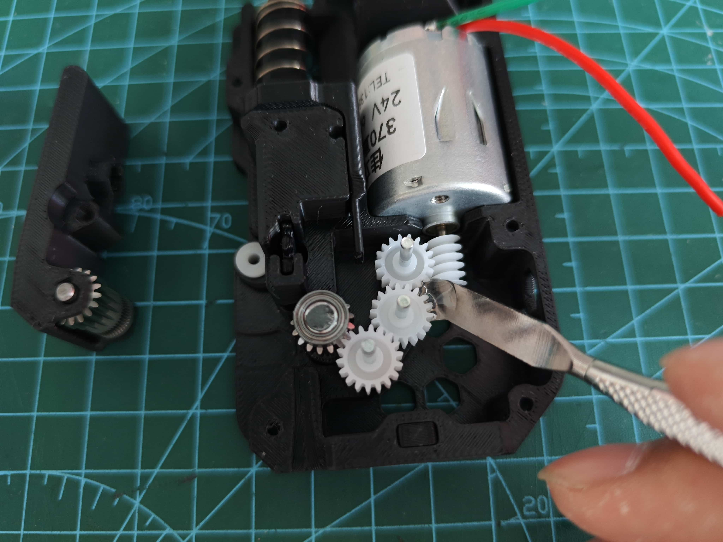
[picture p97: assets/images/build-370/components/给齿轮上润滑.jpg]
Apply Grease


---

### Insert the Steel Ball Spring

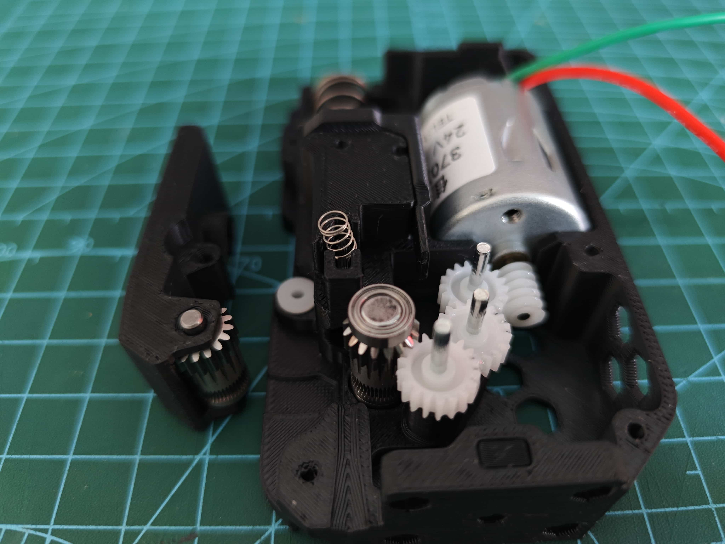
[picture p98: assets/images/build-370/components/放入钢珠弹簧.jpg]
Insert Steel Ball Spring


---

### Closing the Middle Frame

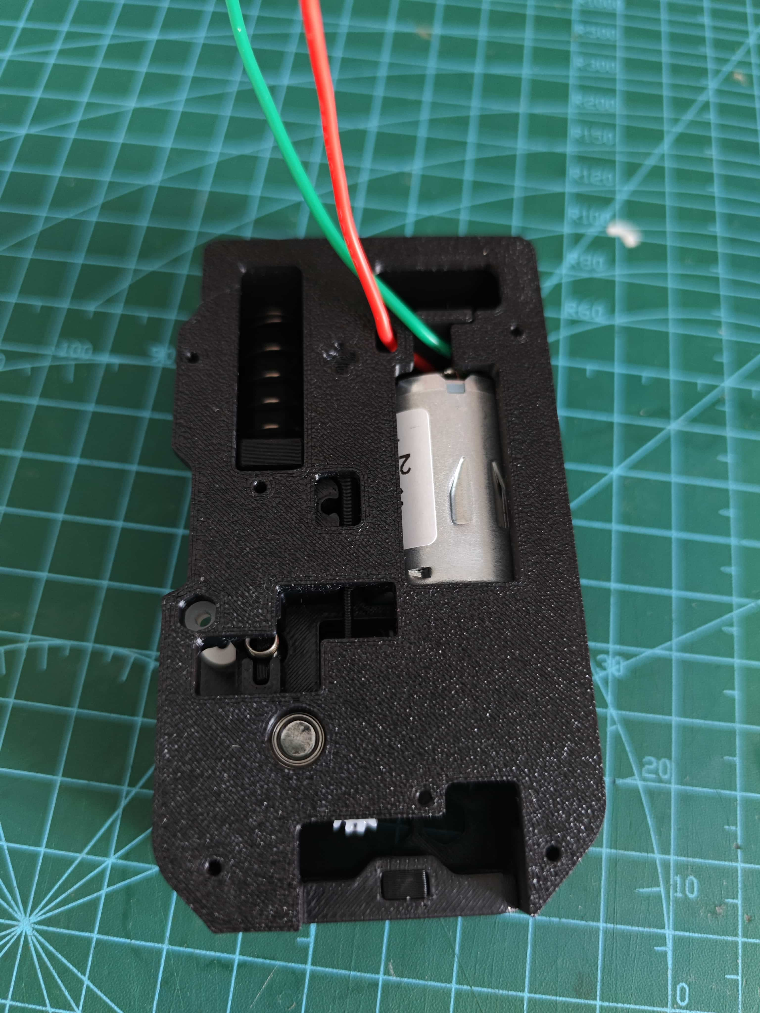
[picture p99: assets/images/build-370/components/合上中框.jpg]
Close the Middle Frame


Secure the middle frame with **M2x8 screws**.

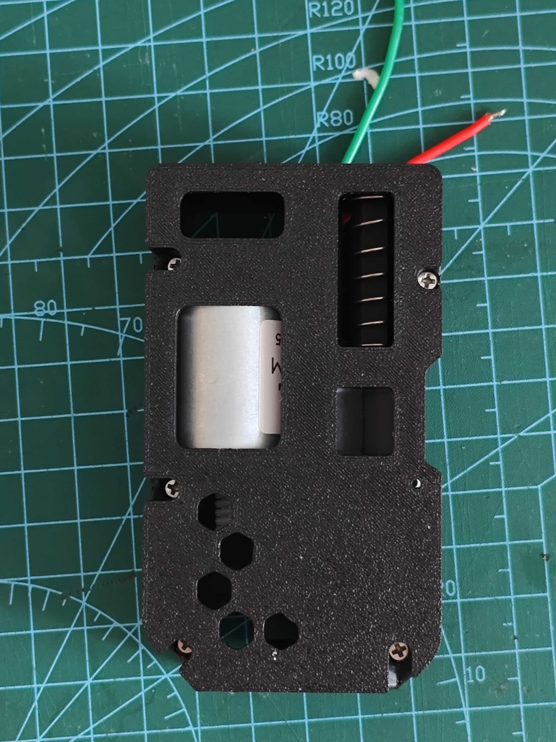
[picture p100: assets/images/build-370/components/用螺丝固定中框.jpg]
Secure Middle Frame


---

### Installing the Lever

Place the **lever** into the assembly and insert a **0.6*4x10mm spring**.

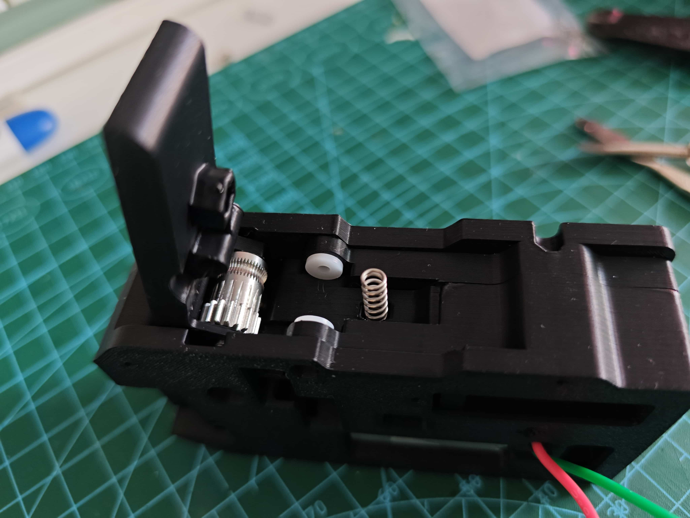
[picture p101: assets/images/build-370/components/安装扳手-1-弹簧.jpg]
Lever Installation - Spring


Press the lever down and insert a **2x20 shaft** to lock it in place.

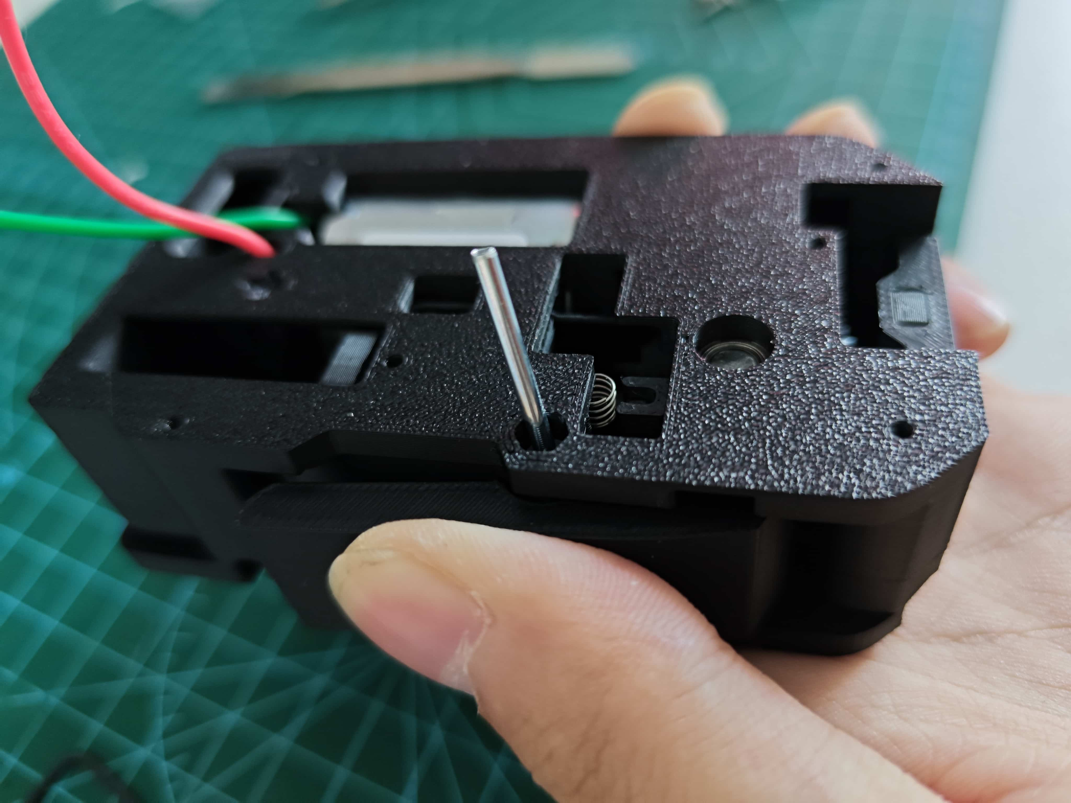
[picture p102: assets/images/build-370/components/安装扳手-2-轴.jpg]
Lever Installation - Shaft


---

### Installing the Pneumatic Connector on the Buffer

Screw the connector into the buffer.

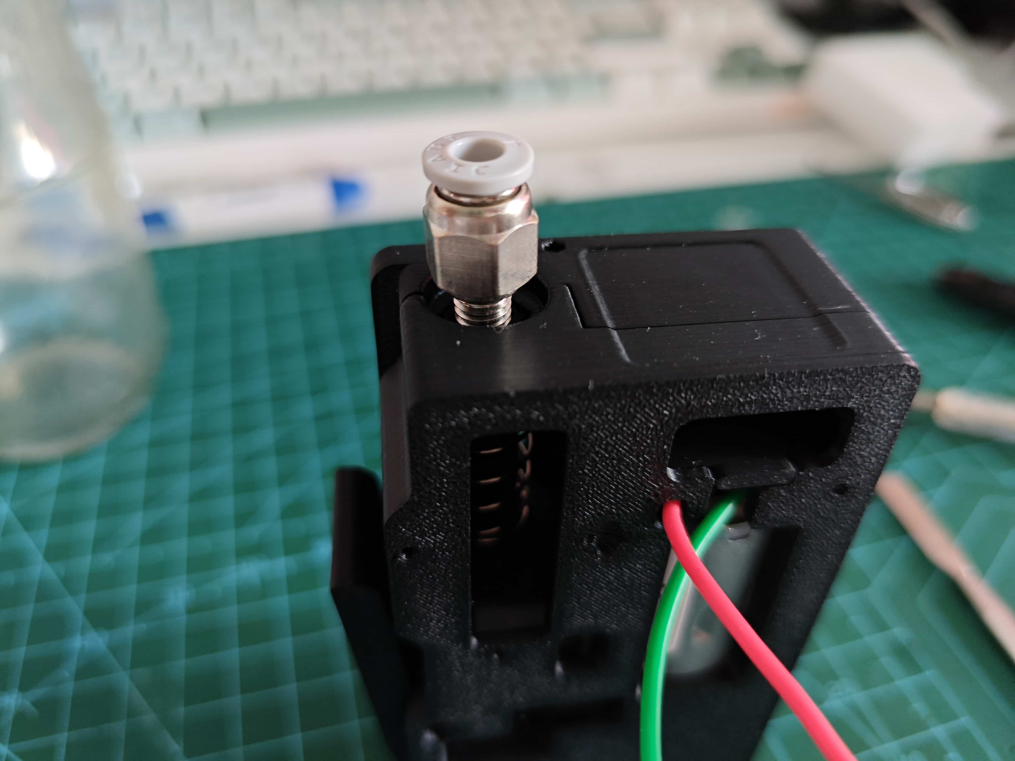
[picture p103: assets/images/build-370/components/安装缓冲器气动接头.jpg]
Install Pneumatic Connector


---

### Installing the Radial Magnet

Place the radial magnet into the slot on the middle frame. Ensure it sits slightly below the surface.

*(Illustration borrowed from the 370X version, but it's the same process)*

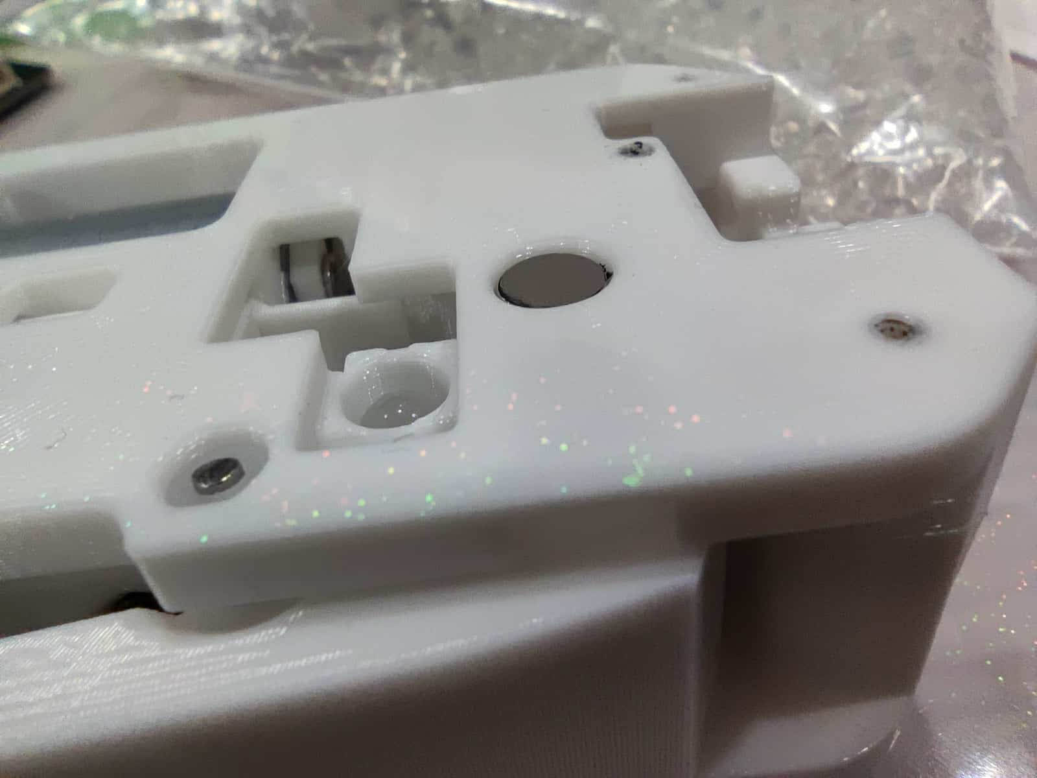
[picture p104: assets/images/build-370/components/安装磁铁-偷的图.jpg]
Install Magnet


#### How to Identify Radial vs. Axial Magnets

Radial magnets have stronger side pull and can spin freely when held sideways.

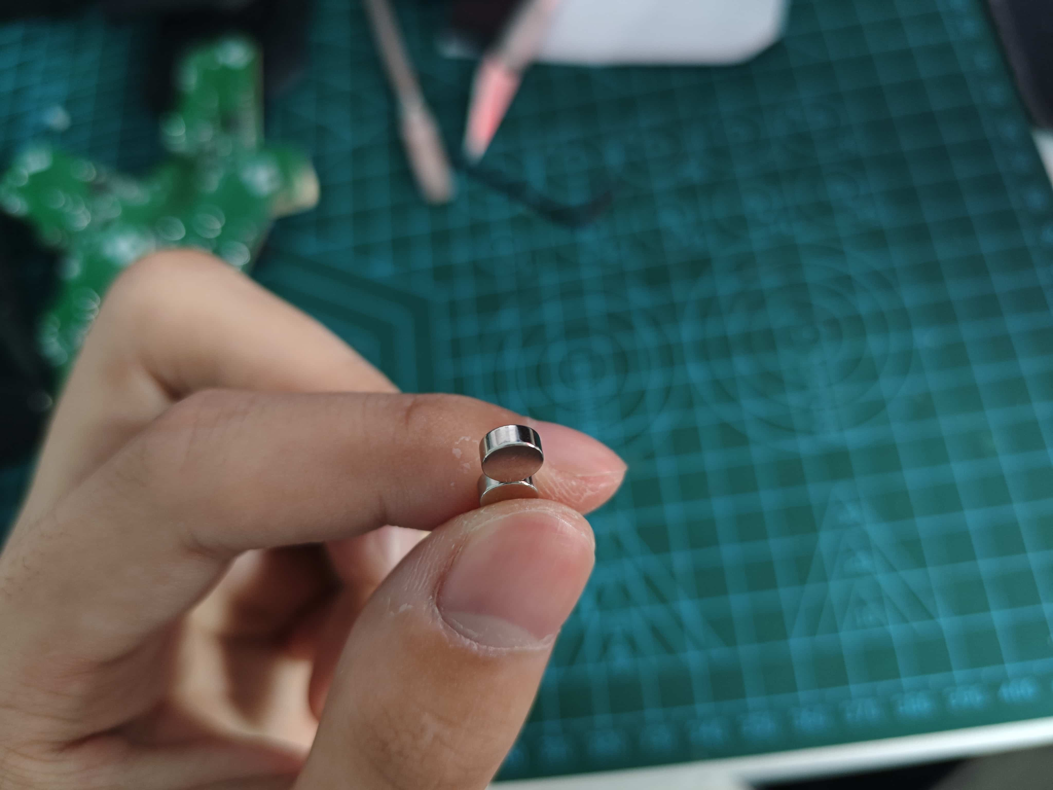
[picture p105: assets/images/build-370/components/径向磁铁.jpg]
Radial Magnet Example


> At this stage, insert filament and power the motor with 12V~24V to test:
> - Can it pull filament?
> - Does the magnet spin correctly?
> - Does the grease distribute evenly?

> You can insert an optical fiber into the small hole next to the buffer as a light guide.
> 

---

## Installing the Circuit Board and Final Testing

### Assembly

- Place the **secondary board** (sensor side down) onto the middle frame and secure with **two M2x8 screws**.
- Attach the **front frame** with **four M2x8 screws**.
- Connect the secondary board to the main board via ribbon cable.
- Connect the main board to your computer using a USB-to-TTL module (power and ground are enough). You can also wire it the same as during firmware flashing.

### Testing

> My pictures show the fully assembled unit, but I recommend testing after building one channel to avoid unnecessary trouble.

Initial power-up status (main board not shown, red LED on main board):

> Secondary board WS2812 red, buffer light ON, filament sensor OFF

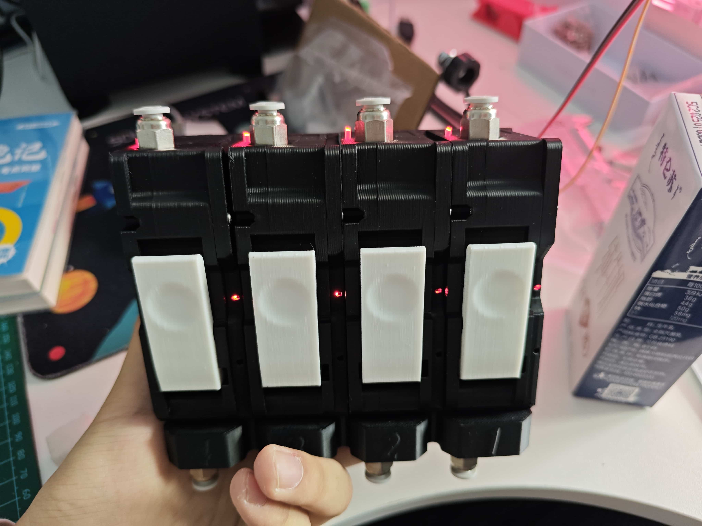
[picture p106: assets/images/build-370/components/测试-原始状态.jpg]
Test - Initial State


Press the lever, insert filament, then release:

> Secondary board WS2812 red, buffer light ON, filament sensor ON

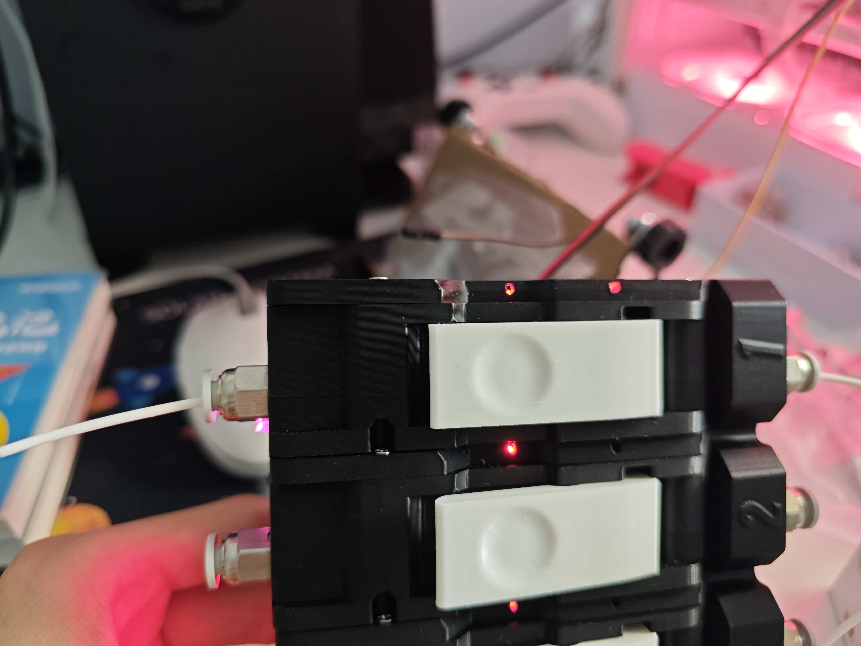
[picture p107: assets/images/build-370/components/测试-插入耗材丝.jpg]
Test - Insert Filament


Now pull the buffer open:

> Secondary board WS2812 red, buffer light OFF, filament sensor ON

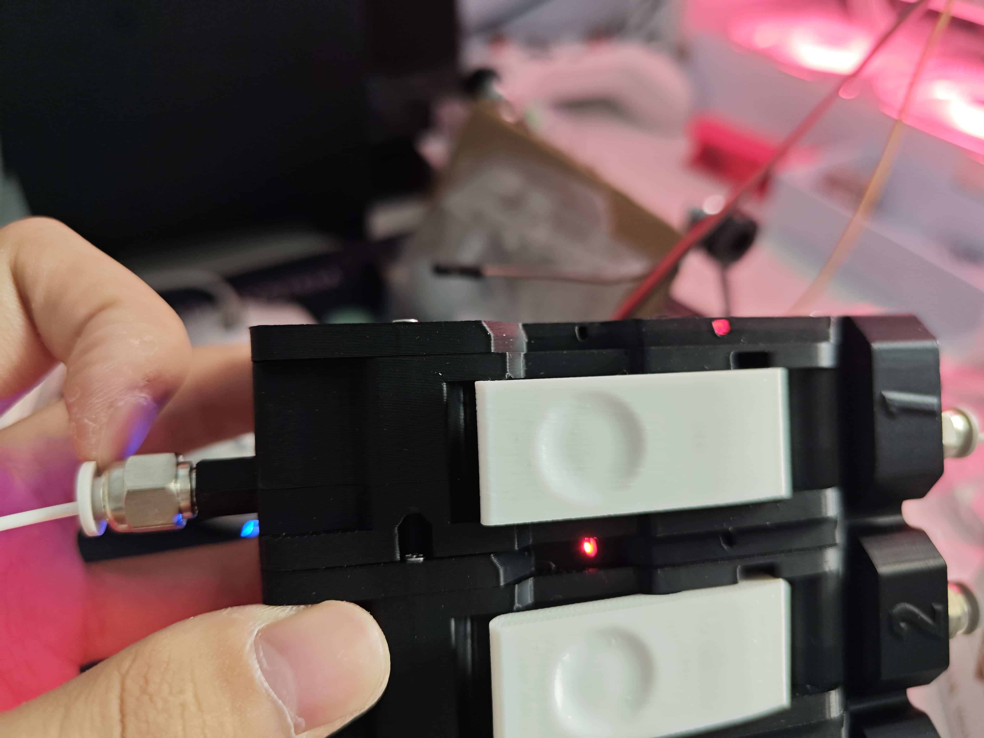
[picture p108: assets/images/build-370/components/测试-拉开缓冲器.jpg]
Test - Pull Buffer


---

## Installing the Feeding Assembly and Circuit Board to the Base

Very simple—refer to the image below:

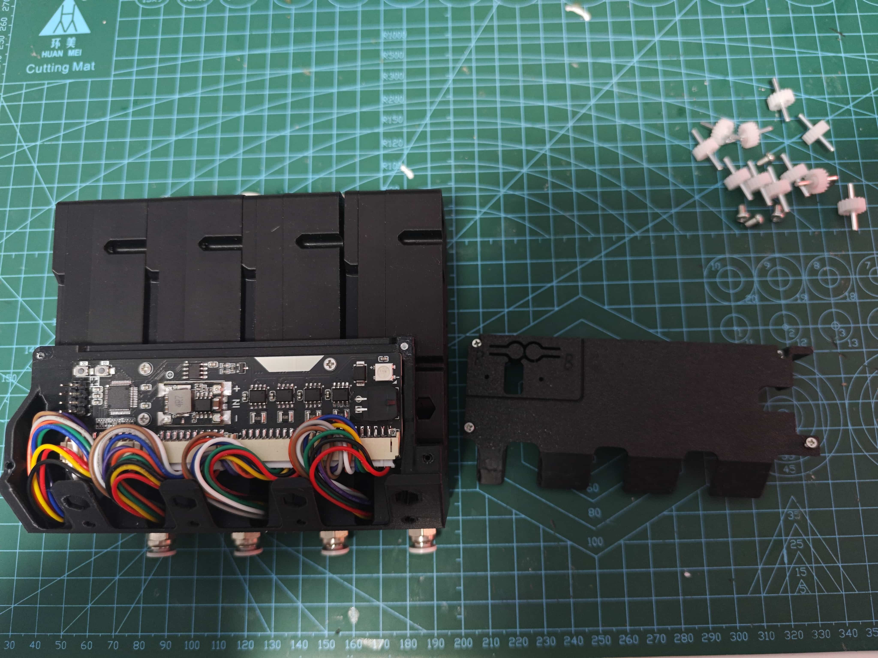
[picture p109: assets/images/build-370/底座安装.jpg]
Install to Base


- Secure the main board with **three M2x8 self-tapping screws**.
- Use **four M2x8 screws** to secure the main board cover.
- Fix the feeding assembly to the base using **M3x14 flathead screws**.
