Ykai-f/wiki_yuekai_fr_BMCU/BMCU/BMCU_Tutorial/BMCU_Assembling_BMCU_C.md

---
title: BMCU Assembling BMCU C
description: 
published: true
date: 2025-05-14T12:33:37.862Z
tags: 
editor: markdown
dateCreated: 2025-05-14T12:33:37.862Z
---

# Header
Your content here
