Ykai-f/wiki_yuekai_fr_BMCU/BMCU/BMCU_Tutorial/BMCU_Assembling_370_mircoswitch_by_xc.md

---
title: BMCU_Assembling_370_mircoswitch_by_xc
description: 
published: true
date: 2025-03-26T16:06:17.190Z
tags: 
editor: markdown
dateCreated: 2025-03-26T11:09:20.556Z
---

# 370 Motor Version x BMCU-Stardust Microswitch Modified Version Assembly Guide

> This version is a modified edition by the community member `@星尘`, and the content also comes from him.

## Introduction

1. This guide is for assembling the `370 Version X BMCU-Microswitch Modified Version`, which is highly compatible with the original version but not the BMCU370 original.
2. This means you can also use it as a reference for the original 370 version (non-steel ball inverted version).
3. Project open-source link: [BMCUx - Oshwhub.com](https://oshwhub.com/xingcc1/bmcu-370x)
4. Project model link: [Makerworld CN](https://makerworld.com.cn/zh/models/1000993-bmcu-370-tie-pian-wei-dong-bo-li-zhu-hong-fa-yuan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) [Makerworld Global](https://makerworld.com/zh/models/1175070-bmcu-370-surface-mount-microswitch-glass-bead-trig#profileId-1184075)
5. For the P1 series, some changes are required such as integrating the five-way connection, which is still under refinement and will be updated later.
6. Feel free to test the firmware (under organization), currently recommended: `BMCU Test Firmware 2-6.bin`.
7. You can customize the firmware and test it here: [bmcu370x github.com](https://github.com/Xing-C/BMCU370x)
8. This project model is based on the BMCU2.5 version shell.

## PCB BOM

1. [【Tencent Doc】BMCU370x - BOM List](https://docs.qq.com/sheet/DTXJPYXVjVXpnY0F3?tab=000001)

## PCB Notes

### Mainboard Soldering Section

1. Pay attention to the diode direction.
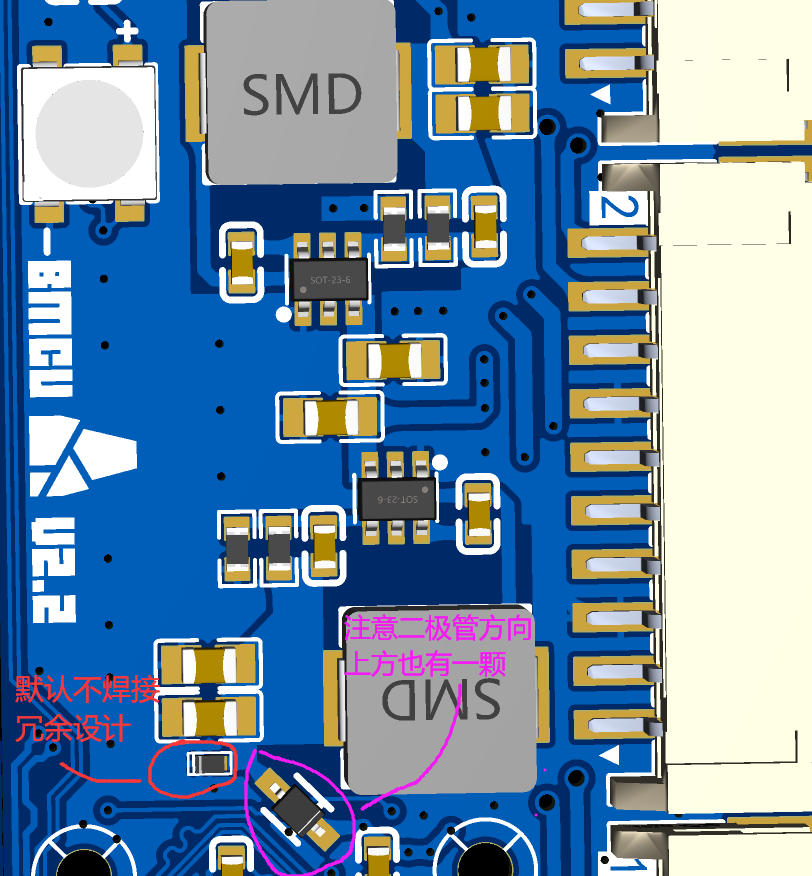
[picture p209: assets/images/build-370x/pcb/potect.jpg]
potect
   
- RED : *Default: Not soldered, redundant design*  
- Purple : *Check the diode direction*, there’s another one on the top side

2. Solder the back side as needed.
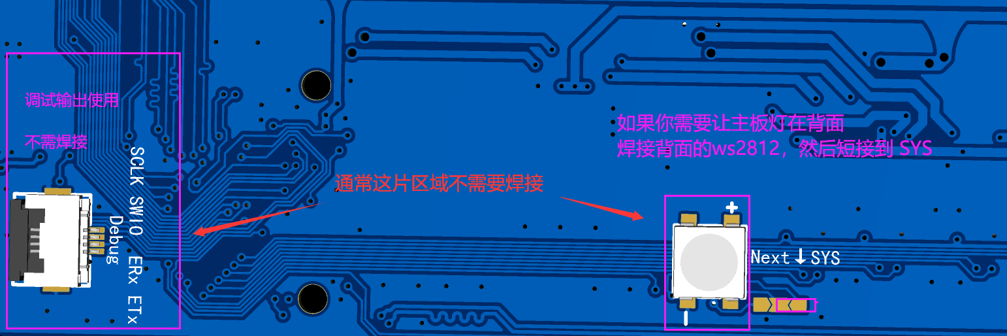
[picture p210: assets/images/build-370x/pcb/Myback.png]
Myback
   
 *For debugging output only, no soldering required*  
- *If you want the mainboard LED on the backside*:  
  - Solder the WS2812 LED on the backside  
  - Bridge to SYS  
- *This area usually doesn’t require soldering*   
   
3. Choose and solder the motor voltage.
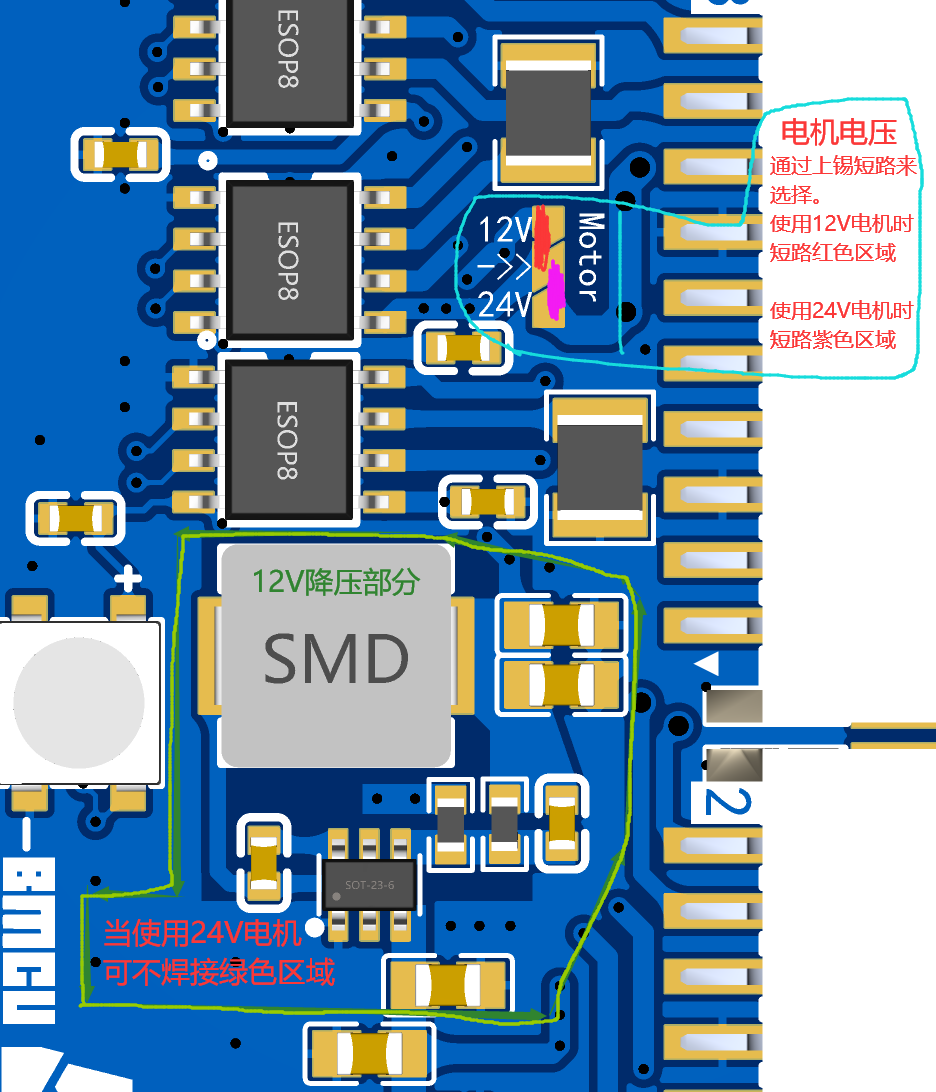
[picture p211: assets/images/build-370x/pcb/motor.png]
motor
   
- *Motor voltage selection by solder bridge:*  
  - Short **red area** for 12V motor  
  - Short **purple area** for 24V motor  
- *12V step-down circuit area*  
- When using a 24V motor, **the green area is optional to solder**
   
4. Switch the slave part back to dual optocouplers (130 basic version).
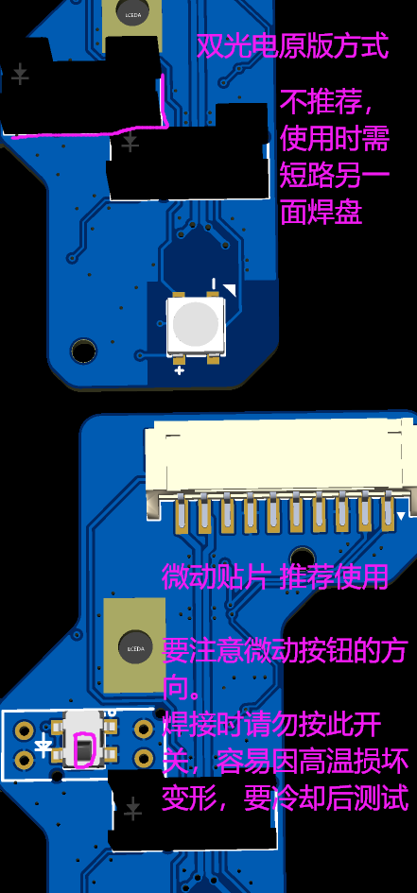
[picture p212: assets/images/build-370x/pcb/light.jpg]
   
with this version of PCB we have two options
	1.*Original dual-optical design* (Not recommended, requires bridging the pad on the other side when in use)  
  2.*Recommended:* Use surface-mount micro switch  
- Be careful with the micro switch direction.  
- **Do not press the switch during soldering**, it may deform due to high temperature. Test after cooling.

5. Slave part - Functionality
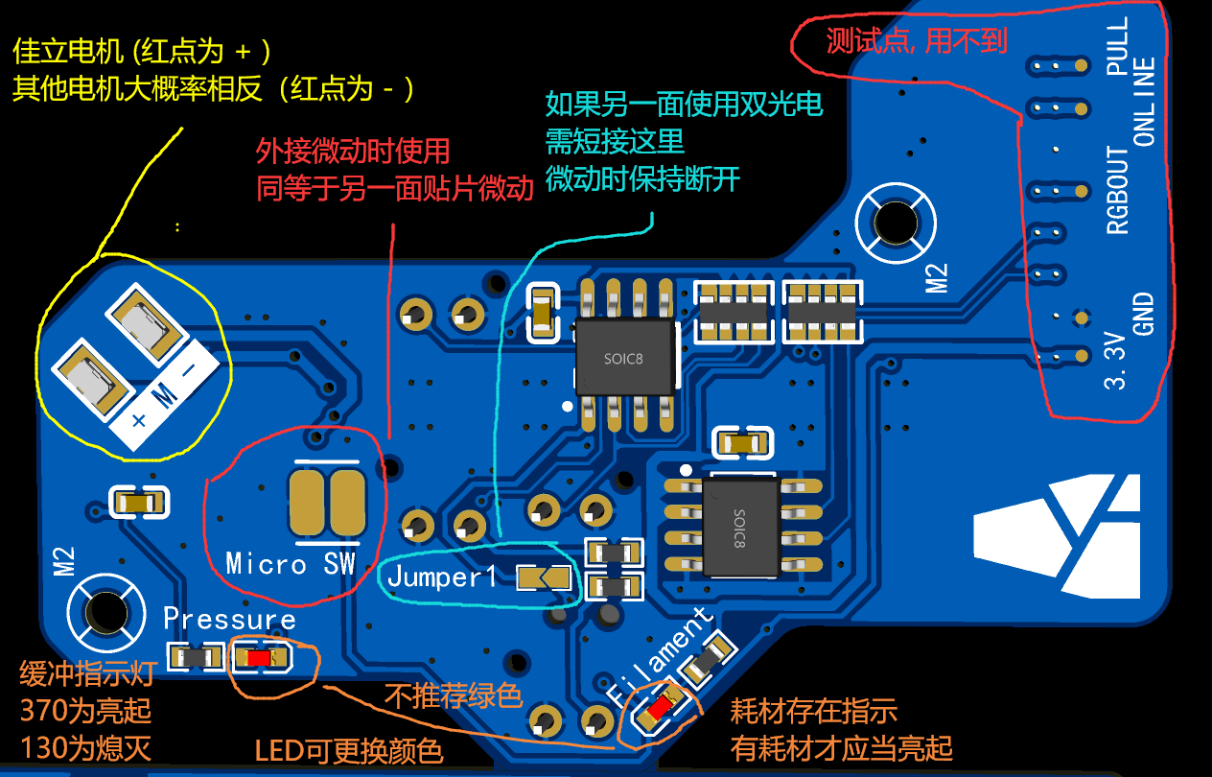
[picture p213: assets/images/build-370x/pcb/light_1.jpg]
   
**Suggested English:**  
- *Jiali Motor*: Red dot = +; **Other motors are likely reversed** (Red dot = -)  
- *External micro switch* works the same as the surface-mounted one  
- **If using dual optical sensors on the other side**, bridge here. Keep open when using the micro switch.  
- *Test points*: Not used  
- *Buffer indicator LED*: ON for 370 motors, OFF for 130 motors (Color can be changed, green is not recommended)  
- *Filament detection indicator*: Should light up only when filament is present

## Component Assembly

1. There might be some omissions in the tutorial, feel free to point out any mistakes and discuss with fellow members.
2. The shell is photographed based on the first version, so the appearance may vary slightly.
3. Start by assembling the bottom shell.
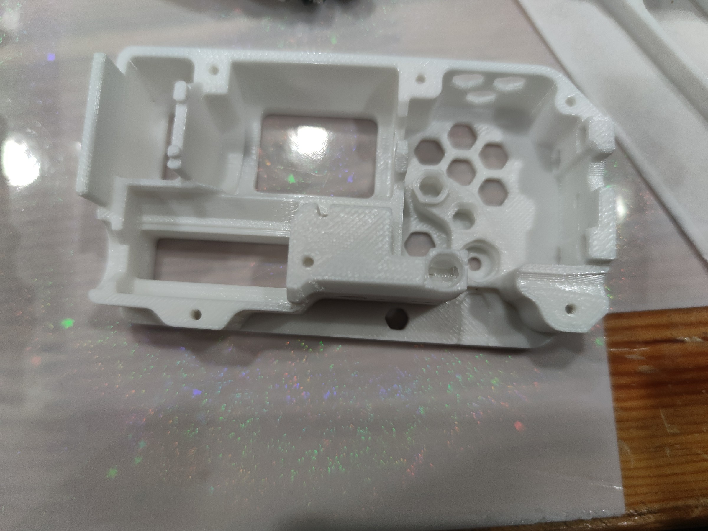
[picture p214: assets/images/build-370x/0.jpg]
   
4. Install 3 bushings and one MR85ZZ bearing. Ensure the bushings are pressed tightly with tools for the best fit.
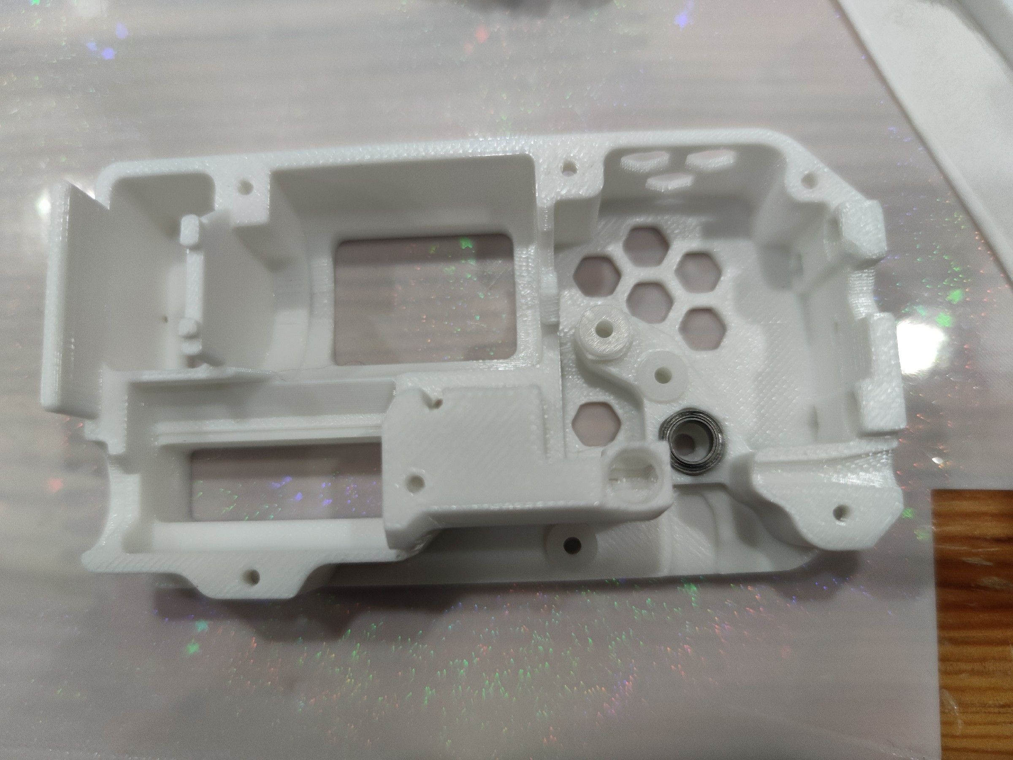
[picture p215: assets/images/build-370x/1.jpg]
   
5. Ensure motor wires are soldered properly. If the motor has no worm gear, insert the plastic worm gear aligned with the motor shaft, place it in the bottom shell, align the screw holes, and use M3x5 flathead screws to secure it.
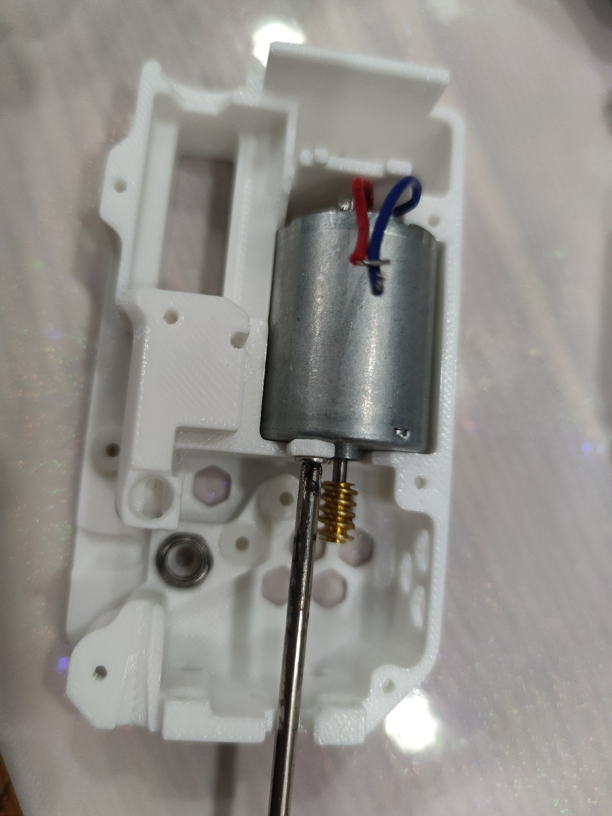
[picture p216: assets/images/build-370x/2.jpg]
   
6. Ensure the glass bead area is smooth. If there are small bumps, trim them with a craft knife.
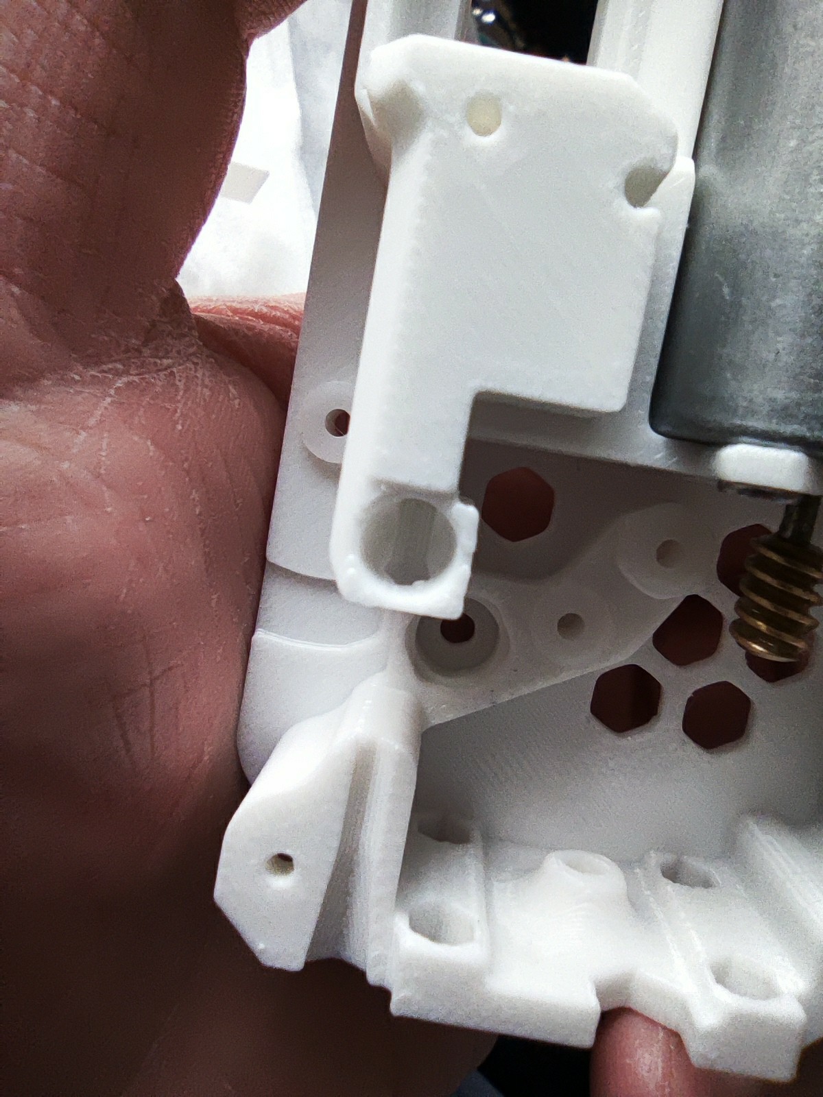
[picture p217: assets/images/build-370x/2.1-new.jpg]
   
7. After trimming, proceed to the next step.
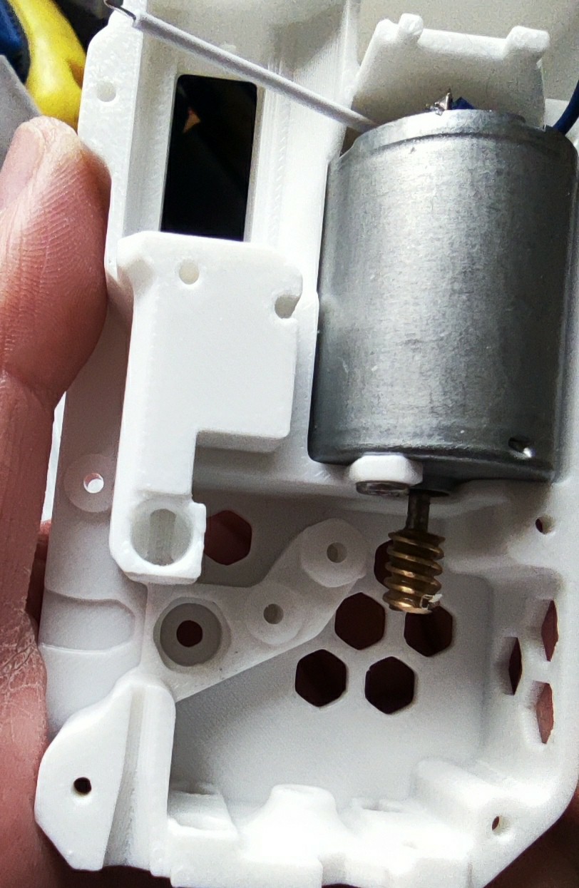
[picture p218: assets/images/build-370x/2.2-new.jpg]
   
8. Insert two m2x20 shafts. If using metal gears, use 1.95/1.9mm diameter shafts. Also, adjust the bottom shell/mid-frame as metal gears differ in thickness. Metal gears are not recommended.
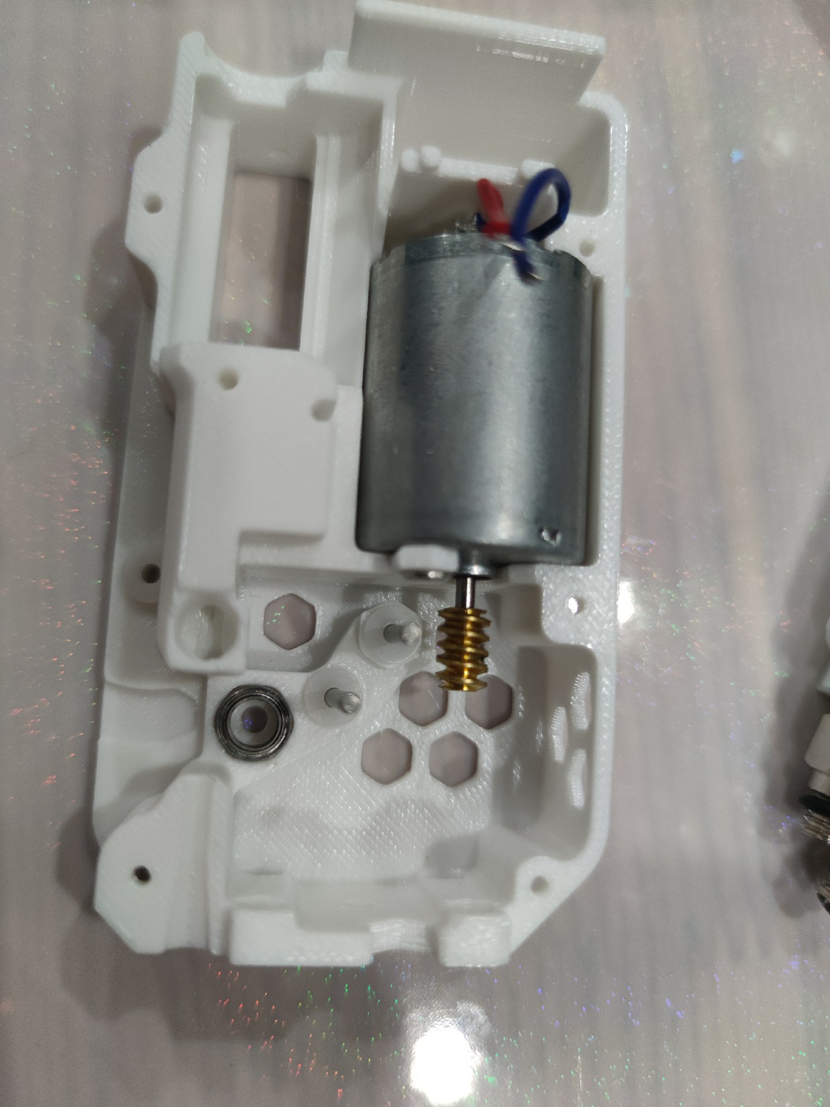
[picture p219: assets/images/build-370x/3.jpg]
   
9. Press the 182A plastic gear down fully. Align carefully and press the one closer to the motor first. Metal gears can be placed directly.
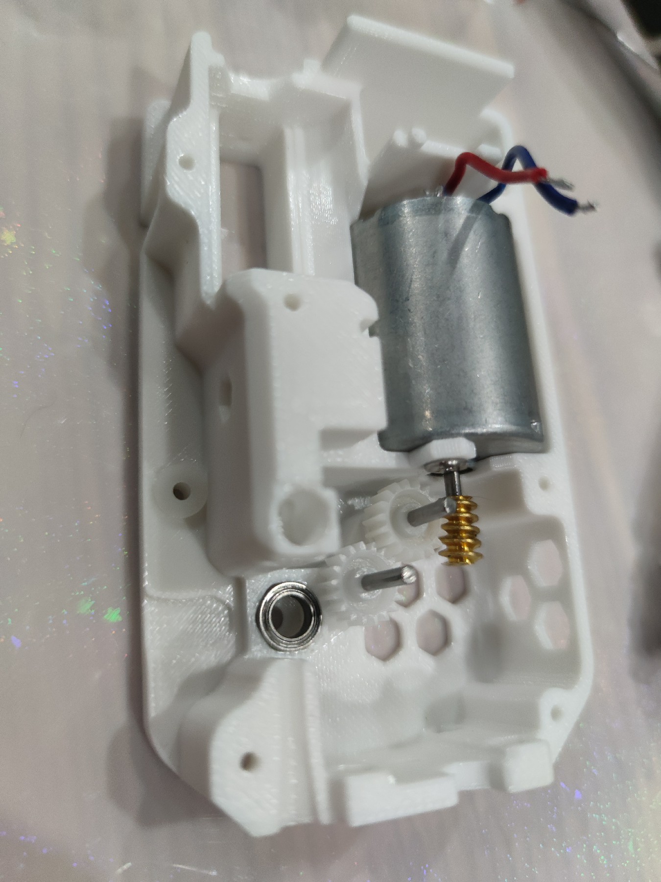
[picture p220: assets/images/build-370x/4.jpg]
   
10. Take the buffer cylinder printed part and slider, assemble them together. Ensure filament passes through smoothly; otherwise, reprint the cylinder with compensation.
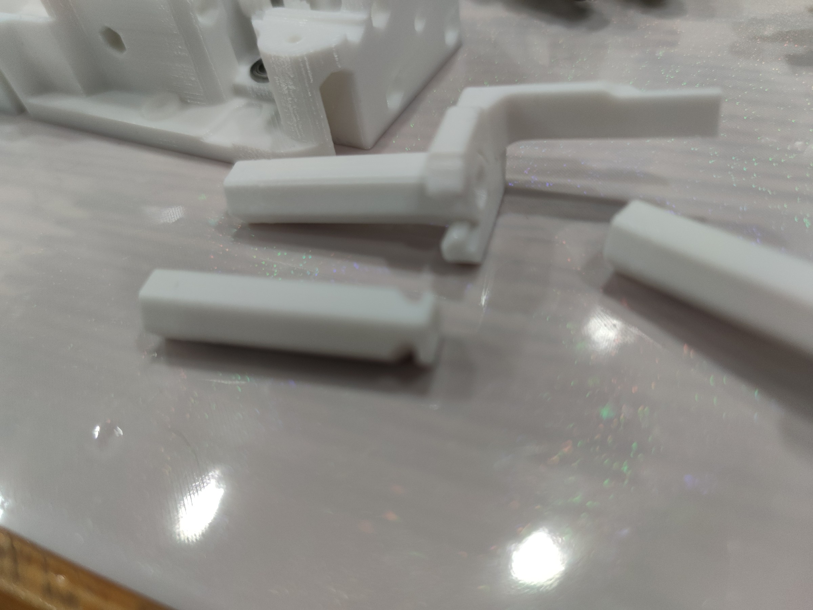
[picture p221: assets/images/build-370x/5.jpg]
    
11. For the new buffer cylinder, insert a spring (diameter 10).
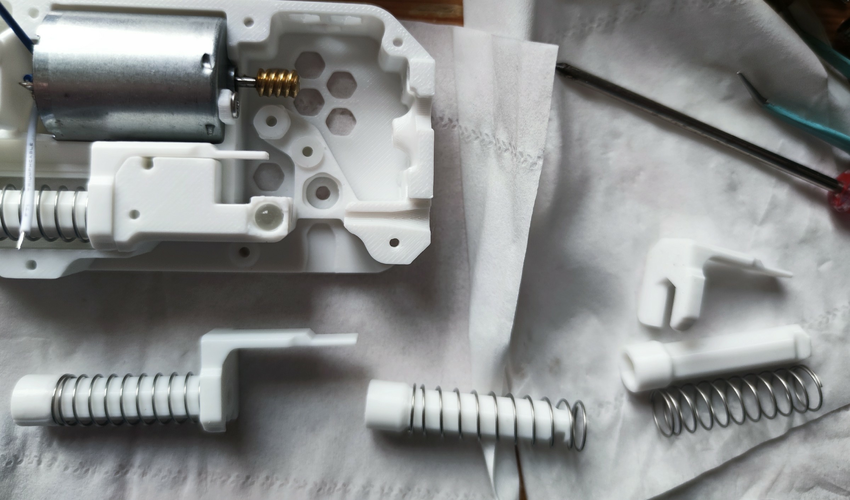
[picture p222: assets/images/build-370x/5-new.jpg]
    
12. Take the BMG gear with a hole, locate the black set screw, a MR85ZZ bearing, and several M5x22 shafts. Test the fit between the shaft and bearing to find the best one that fits easily.
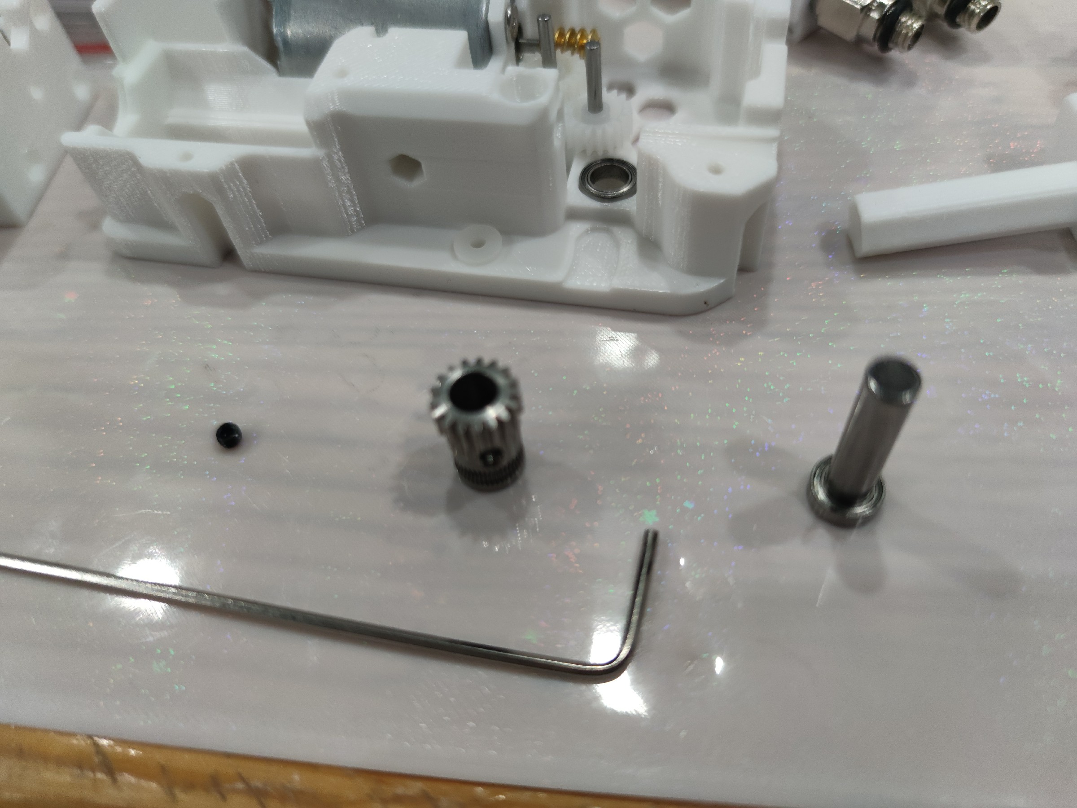
[picture p223: assets/images/build-370x/6.jpg]
    
13. Place the MR85ZZ bearing, insert the selected M5x22 shaft, then fit the BMG gear (smooth side down). Ensure everything is flush, then tighten the set screw with a hex wrench so the BMG rotates with the shaft and bearing.
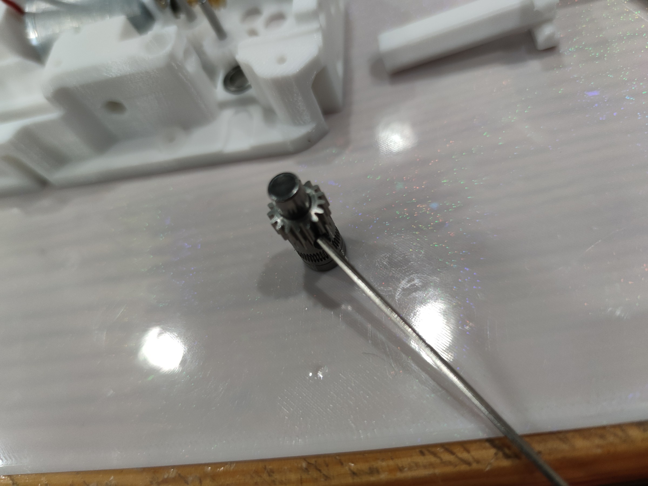
[picture p224: assets/images/build-370x/7.jpg]
    
14. Add lubricant to the worm gear and 182A gear. Do not lubricate the BMG gear to prevent contaminating the filament.
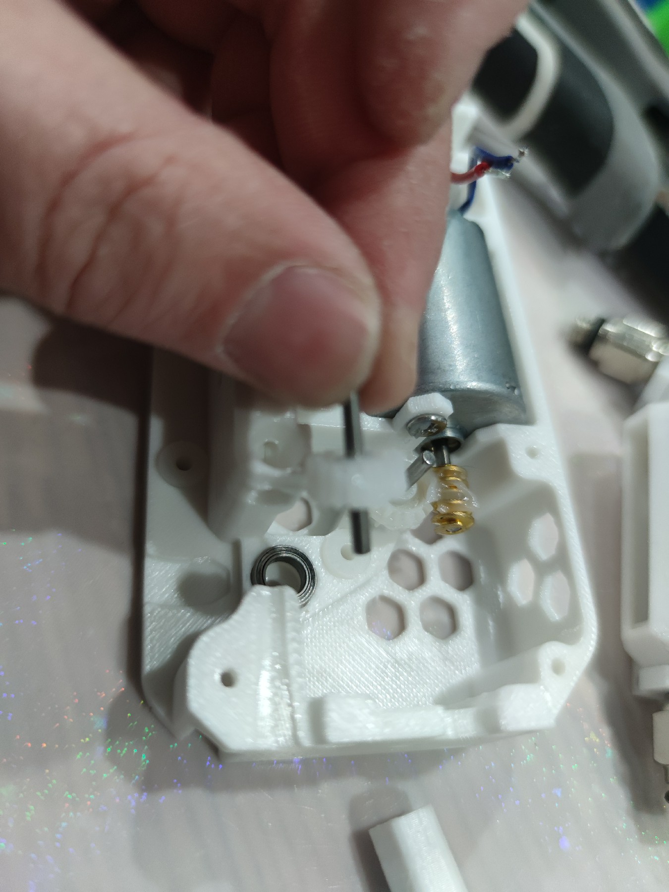
[picture p225: assets/images/build-370x/8.jpg]
    
15. Ensure proper placement.
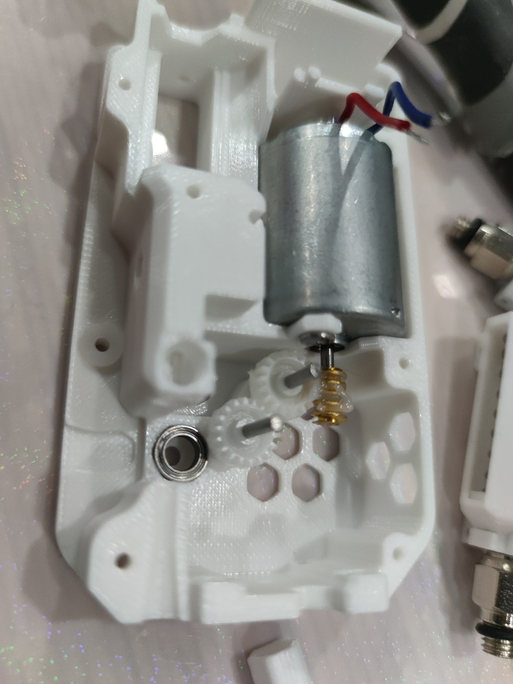
[picture p226: assets/images/build-370x/9.jpg]
    
16. Insert the BMG gear carefully, keeping it away from lubricants. The bottom part will get slightly lubricated by contact, but no active lubrication is needed.
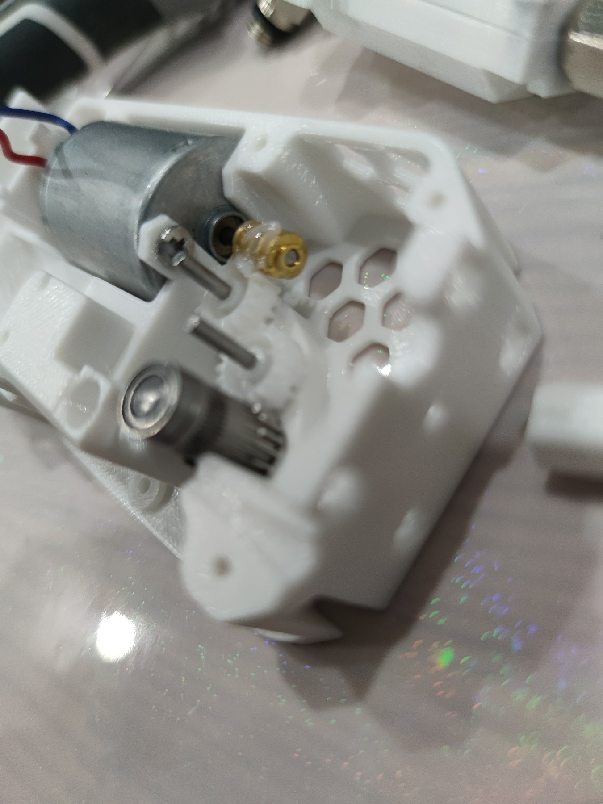
[picture p227: assets/images/build-370x/10.jpg]
    
17. Install the buffer and spring. Recommended lengths: 35mm (original), 50mm (extended).
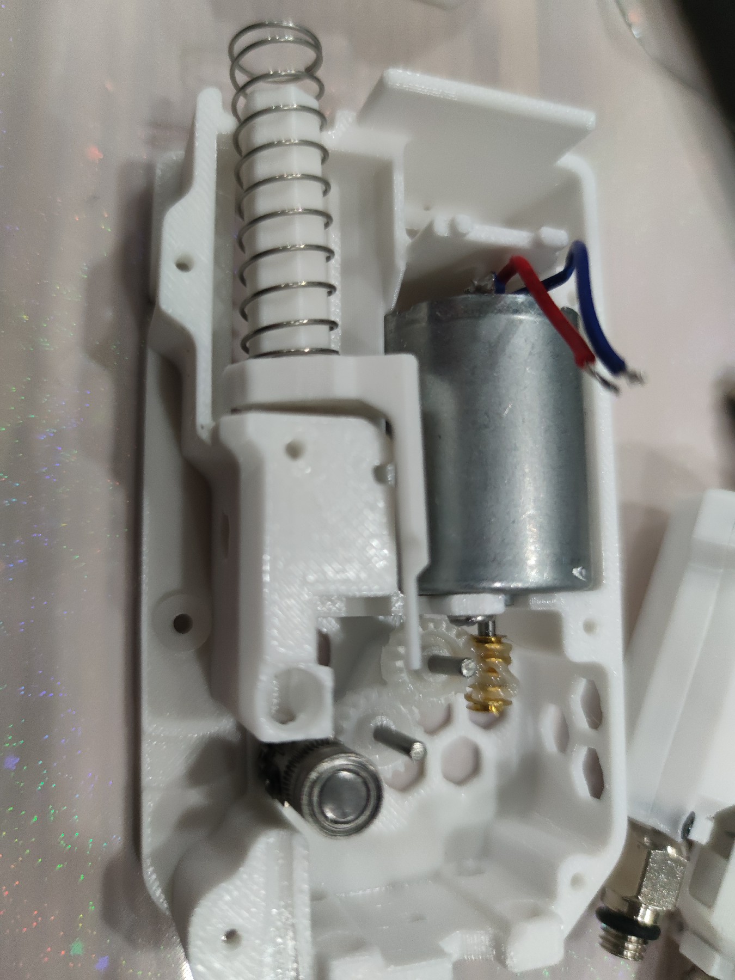
[picture p228: assets/images/build-370x/11.jpg]
    
18. Compress the spring into the shell; prevent it from popping out.
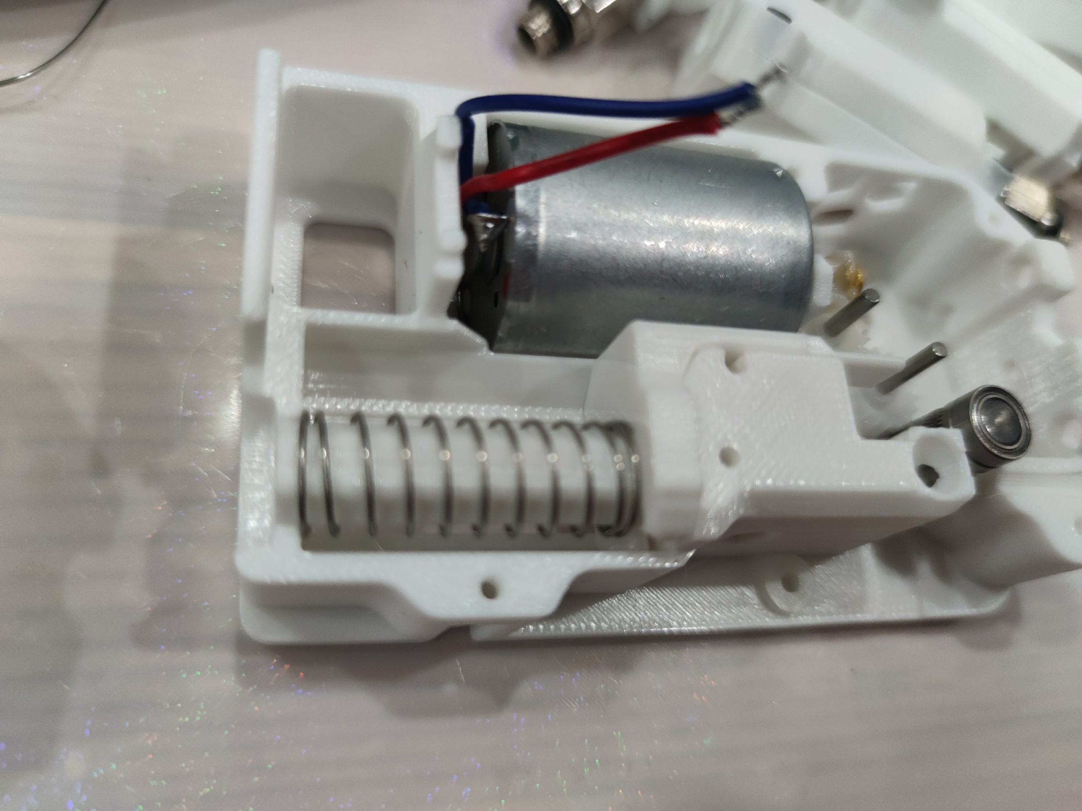
[picture p229: assets/images/build-370x/12.jpg]
    
19. Prepare the middle frame printed part.
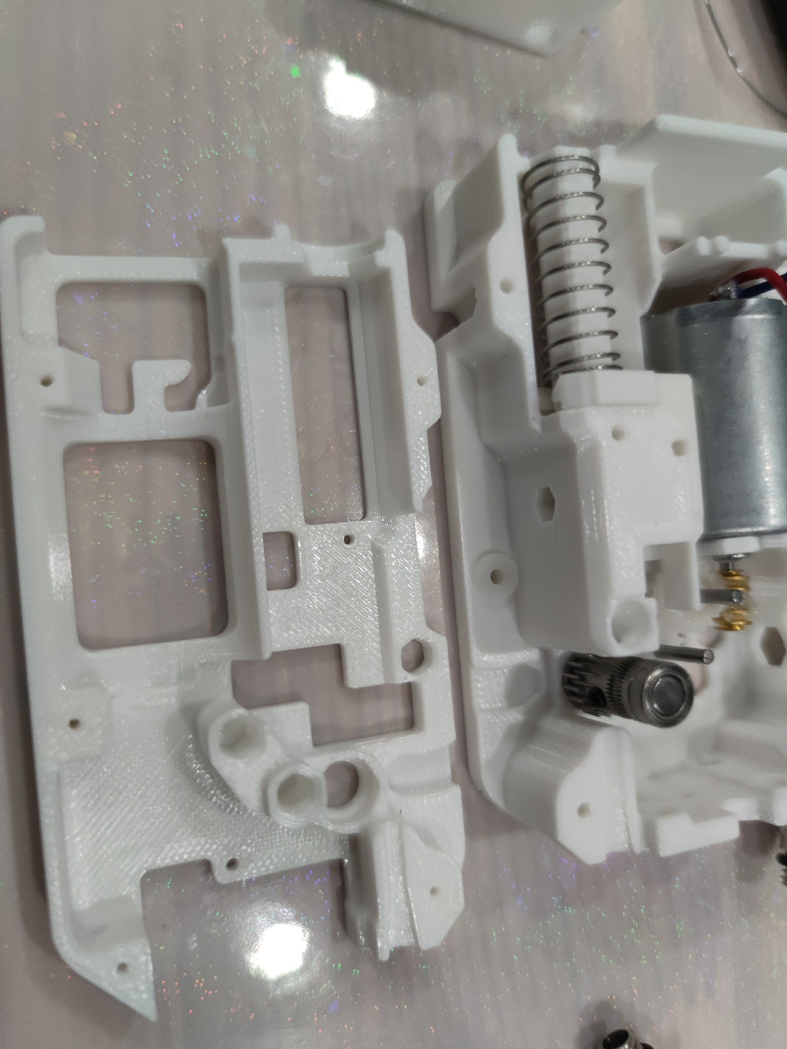
[picture p230: assets/images/build-370x/13.jpg]
    
20. Install three bushings on the middle frame; ensure they are as tight as the bottom shell (usually easier).
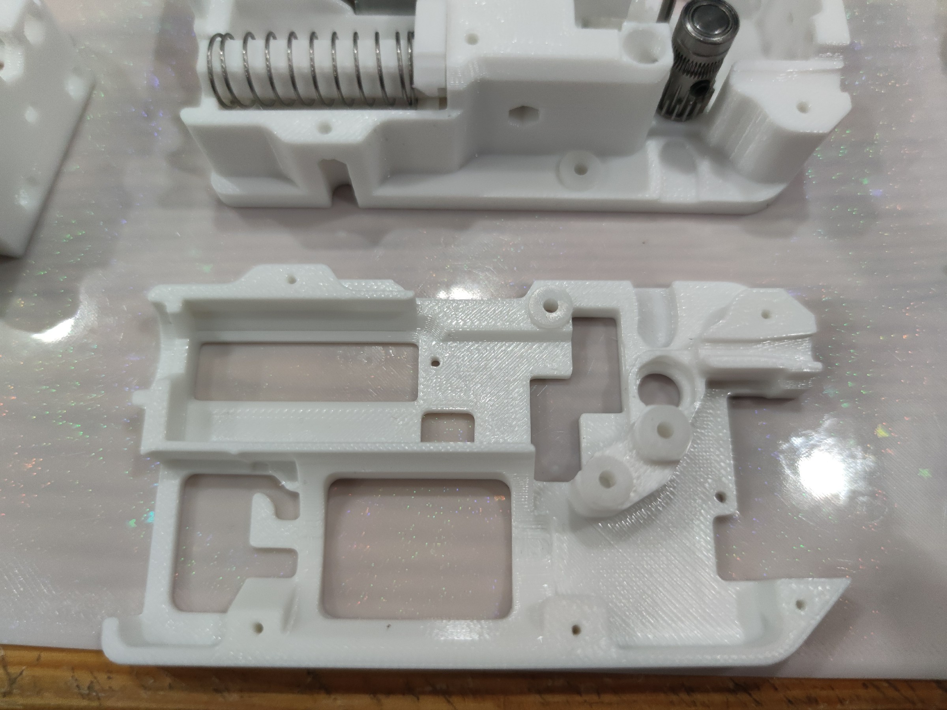
[picture p231: assets/images/build-370x/14.jpg]
    
21. Prepare for mid-frame installation: route motor wires out evenly without pinching. Align gear shafts with the bushing holes and MR85ZZ bearing with the slot. Ensure the spring stays inside. After securing, test the spring bounce.
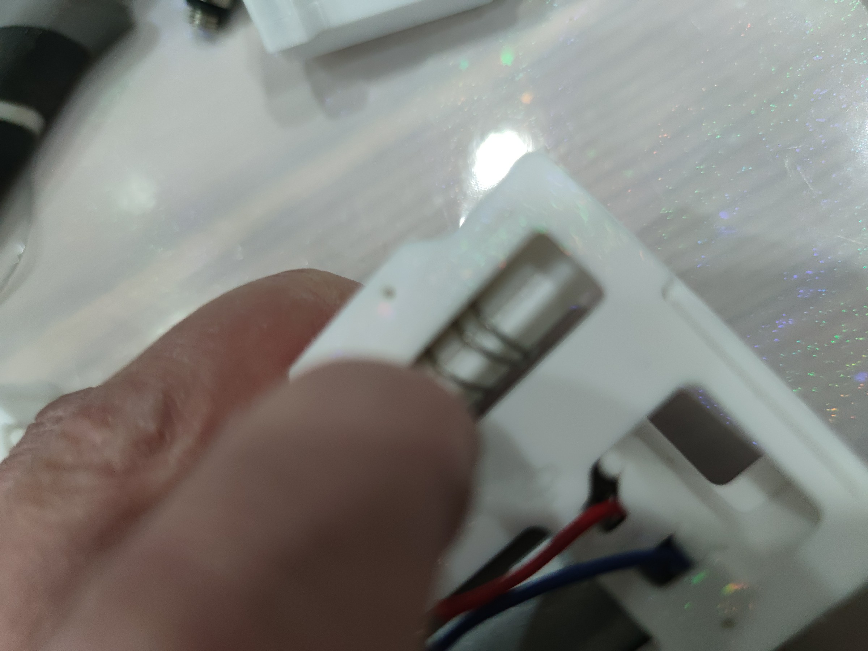
[picture p232: assets/images/build-370x/15.jpg]
    
22. Installed look.
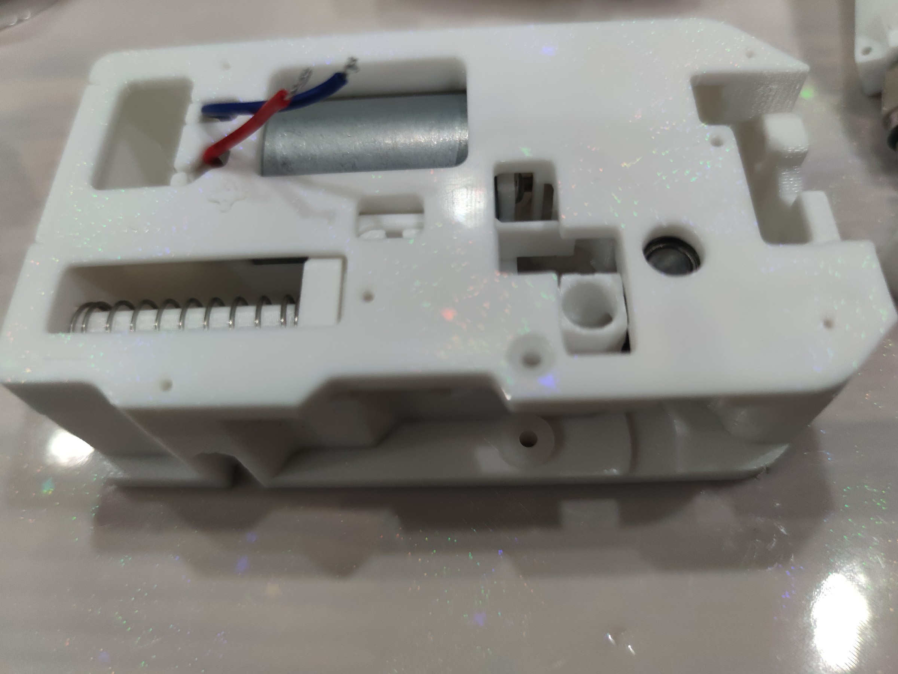
[picture p233: assets/images/build-370x/15.1.jpg]
    
23. Carefully flip it over, press to minimize gaps, and fasten with five m2x8 self-tapping screws.
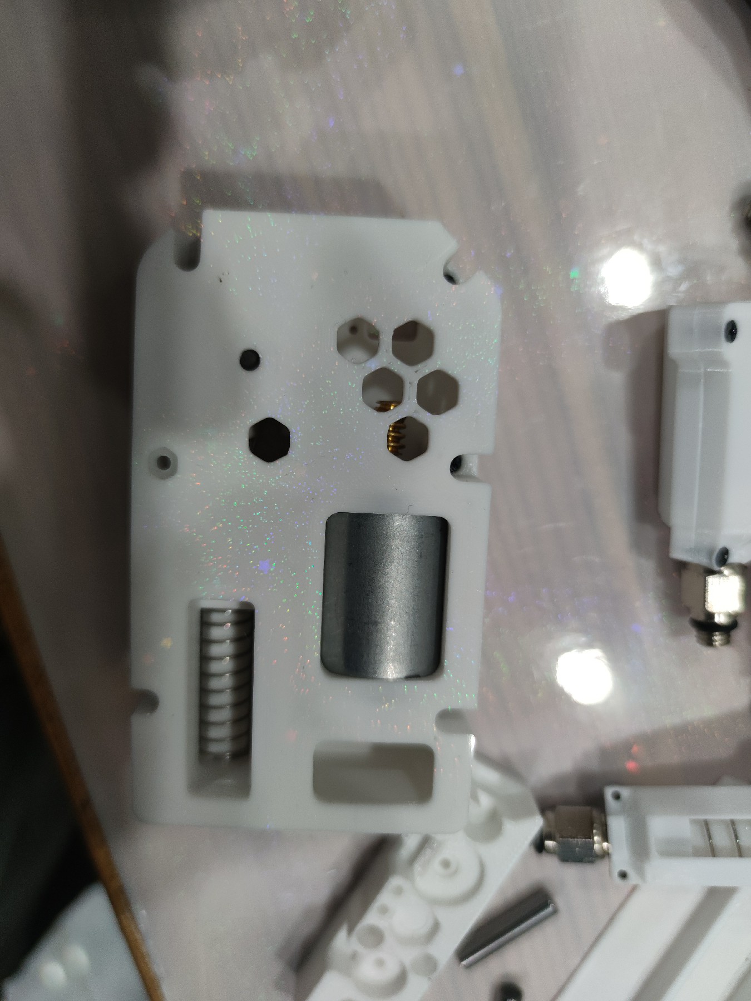
[picture p234: assets/images/build-370x/16.jpg]
    
24. Prepare the lever part: 0.6x4x15 spring (recommended 0.4x4x15), two M2x10 shafts, two ball bearings from BMG package, one shaft, and one BMG gear without a hole (some from 1688 may have holes).
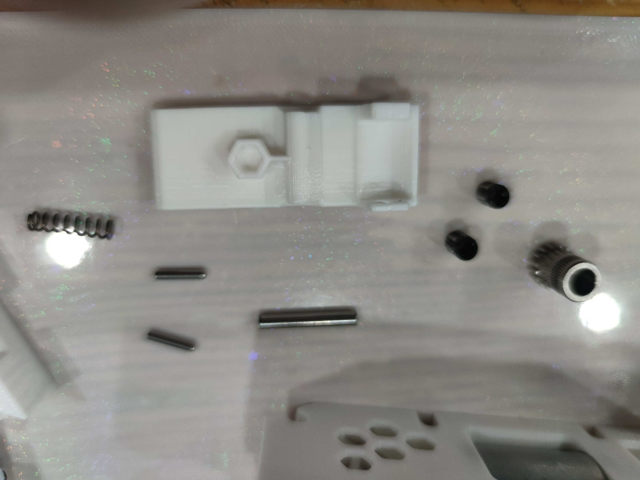
[picture p235: assets/images/build-370x/17.jpg]
    
25. Insert two ball bearings into the BMG gear.
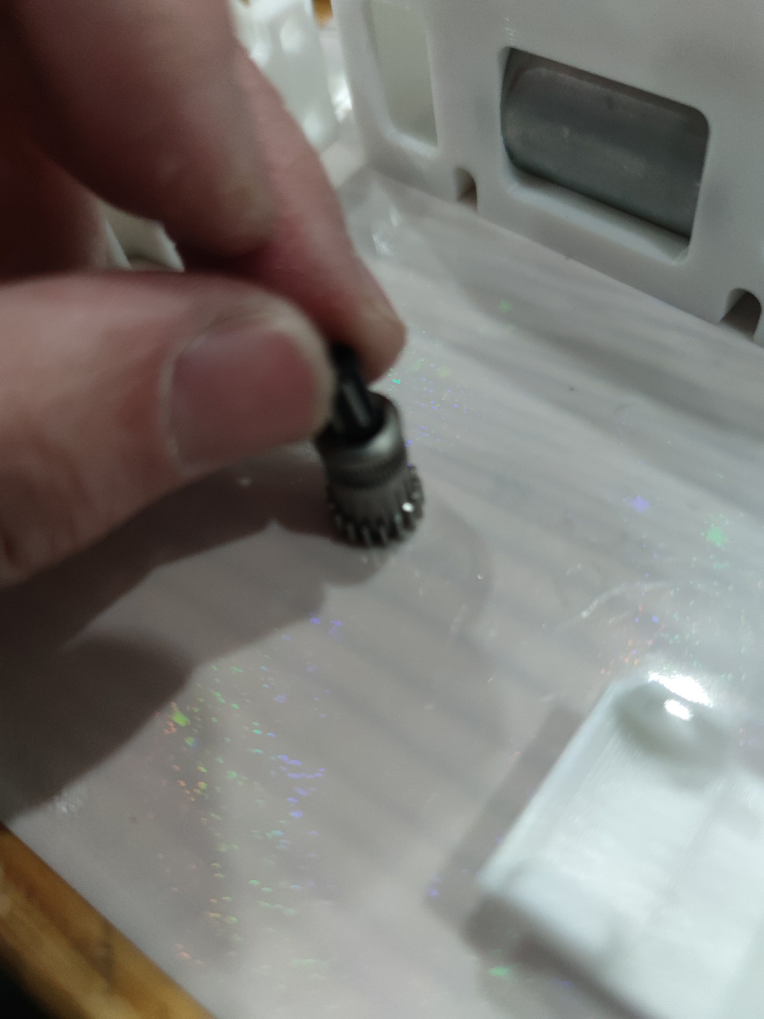
[picture p236: assets/images/build-370x/18.jpg]
    
26. Take the lever printed part (may need sanding if not printed standing) and install the BMG gear with the toothed side facing the thicker side.
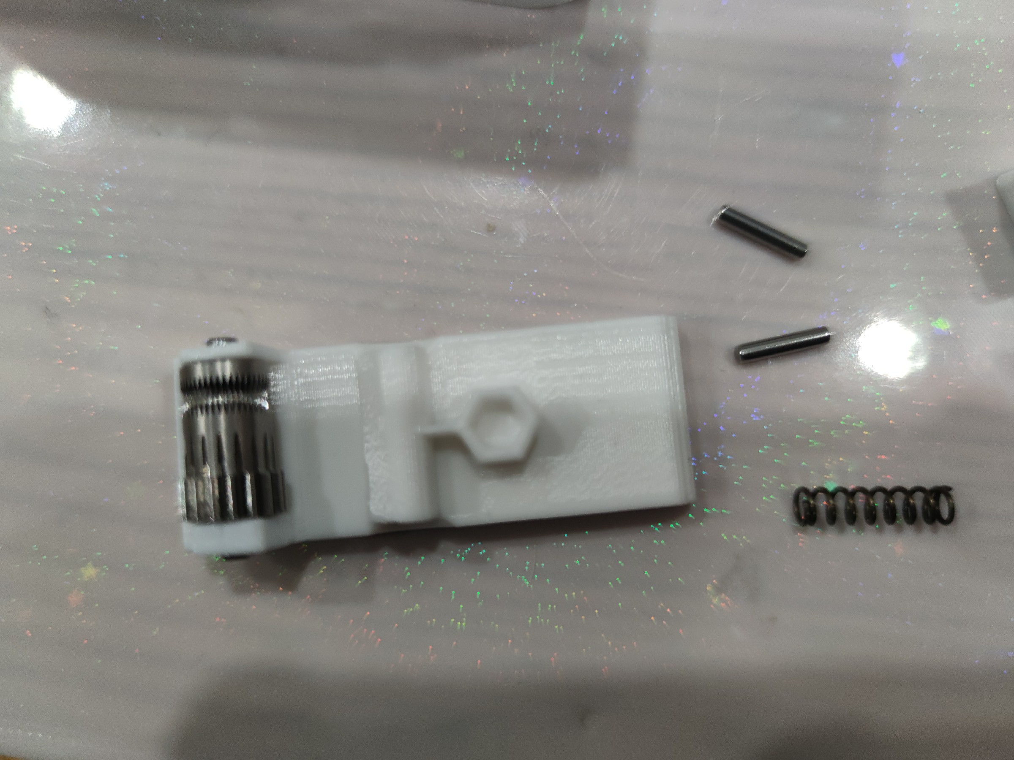
[picture p237: assets/images/build-370x/19.jpg]
    
27. Stand it up, press-fit the shaft from the kit, ensuring both sides are in place and centered.
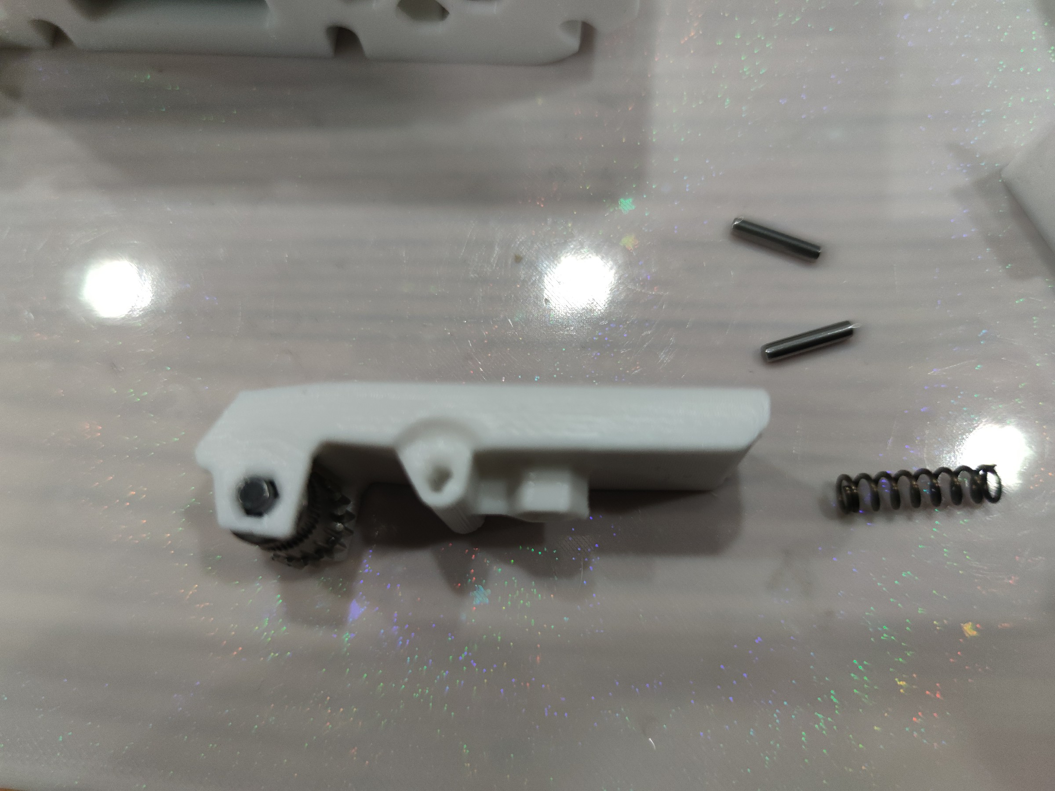
[picture p238: assets/images/build-370x/20.jpg]
    
28. After installation, rotate the BMG gear smoothly. Sand if necessary.
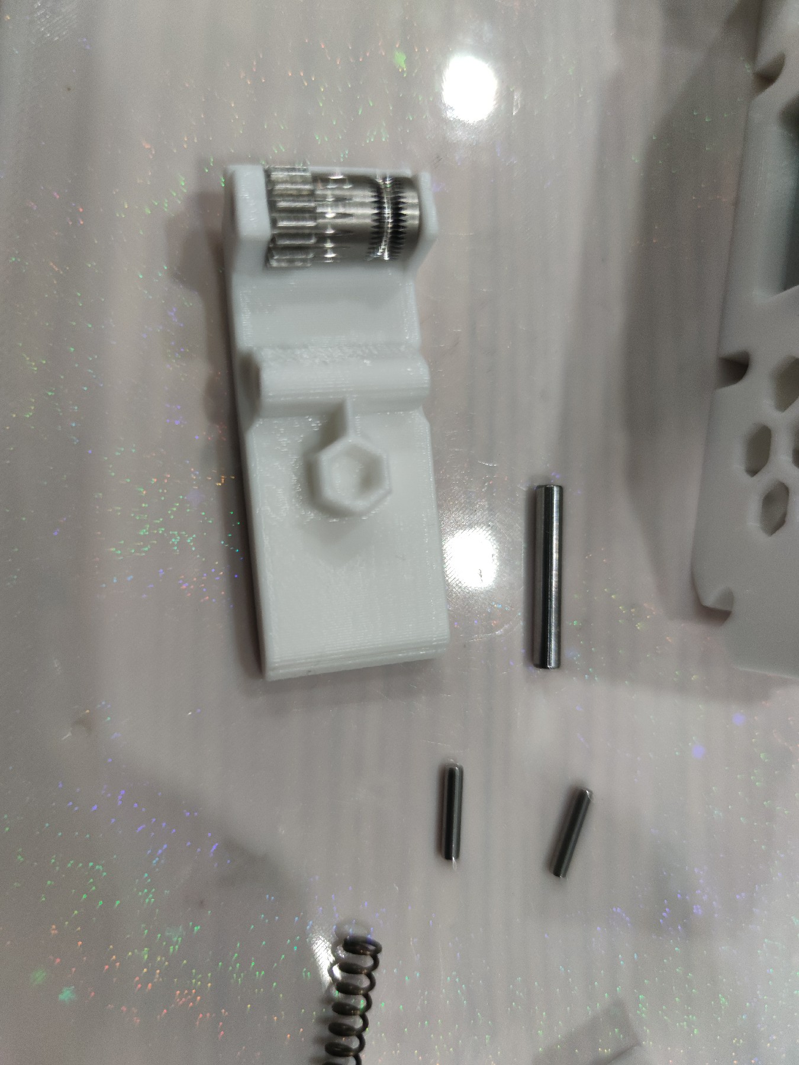
[picture p239: assets/images/build-370x/21.jpg]
    
29. Stand the feeding assembly upright, insert the 0.6x4x15 spring (recommended 0.4x4x15).
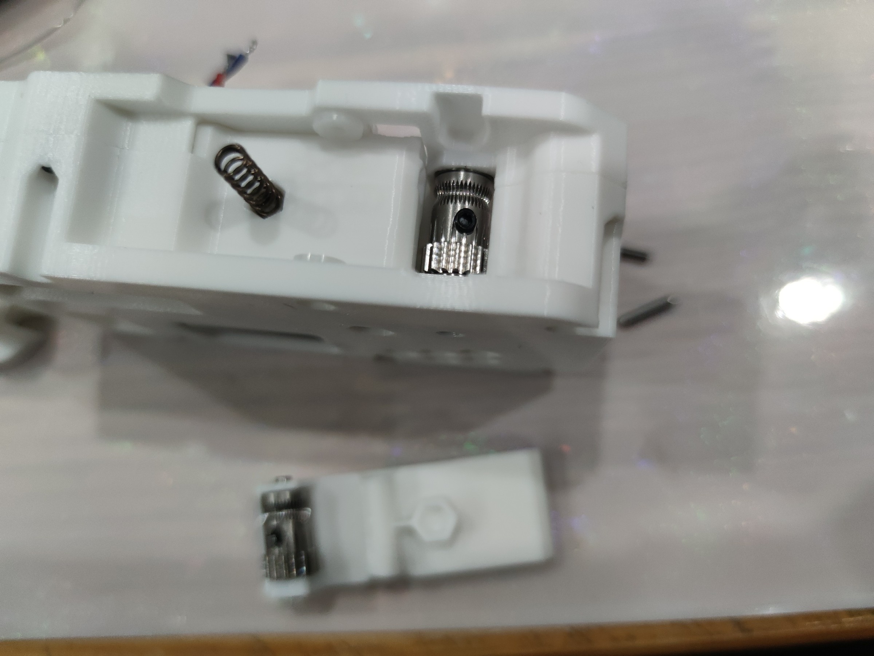
[picture p240: assets/images/build-370x/22.jpg]
    
30. Install the lever, aligning the spring with the hole.
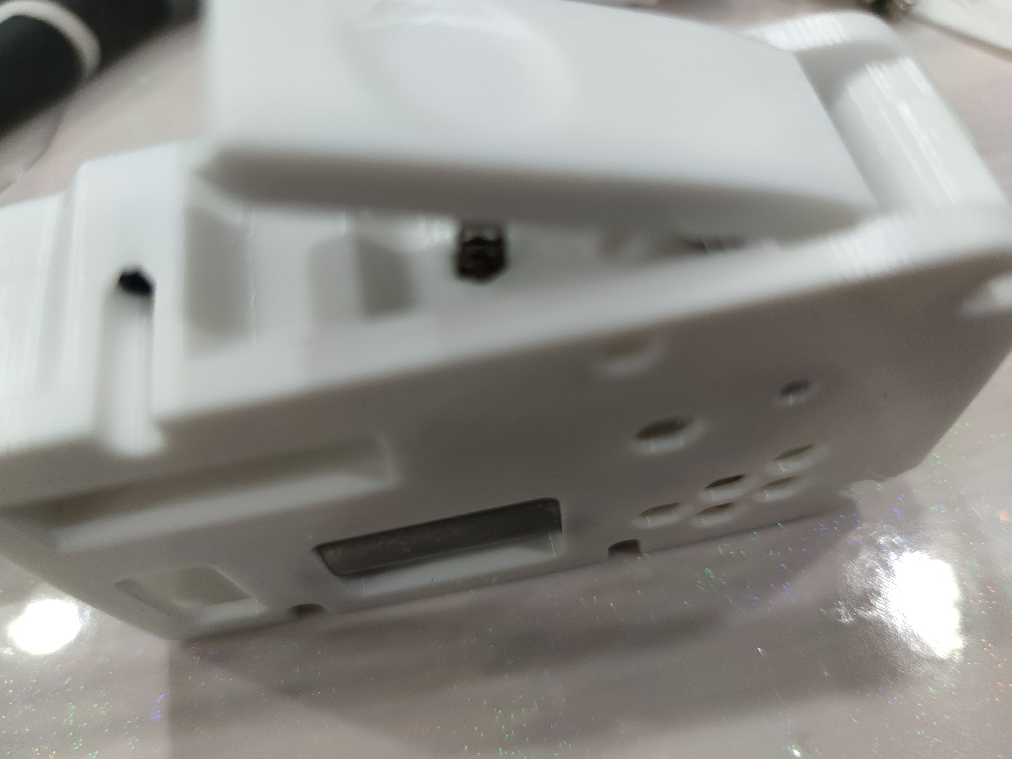
[picture p241: assets/images/build-370x/23.jpg]
    
31. Hold the lever and assembly horizontally, align bushing and lever holes for shaft installation.
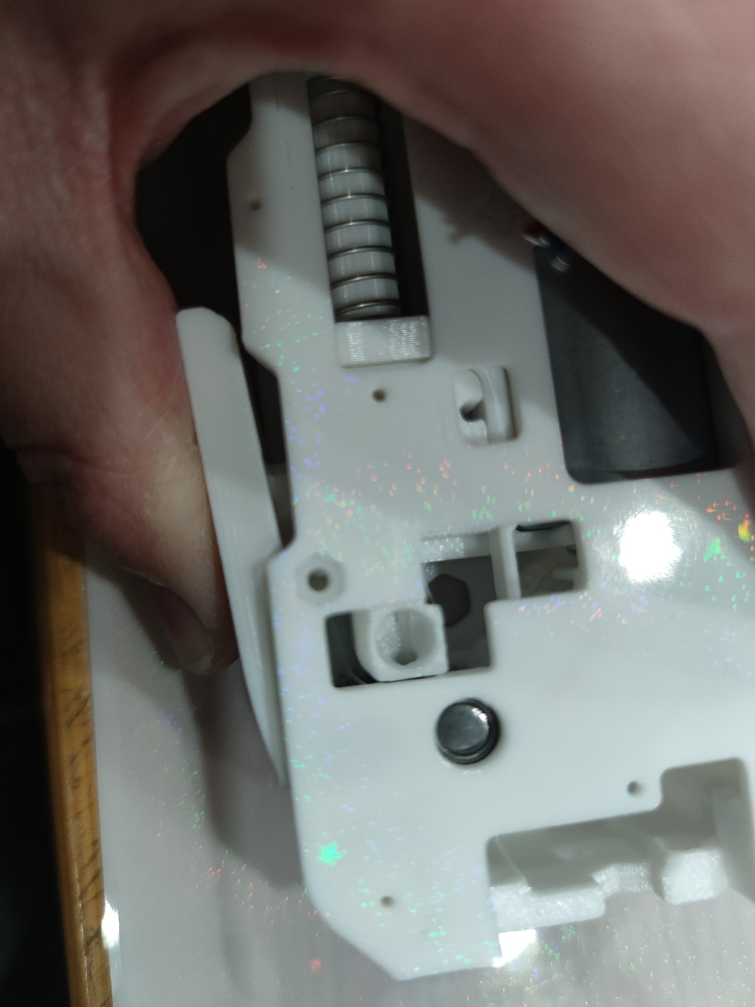
[picture p242: assets/images/build-370x/24.jpg]
    
32. Insert the M2x10 shaft and press it in with a tool.
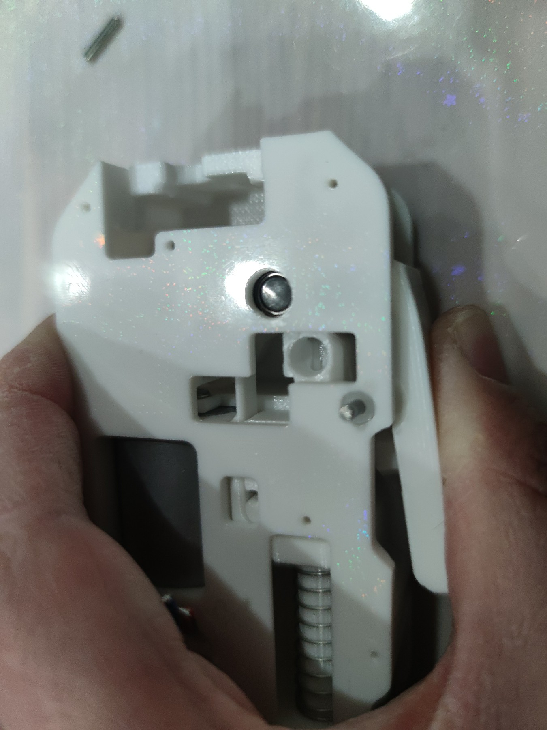
[picture p243: assets/images/build-370x/25.jpg]
    
33. Ensure proper installation; the protrusion should not exceed the shell.
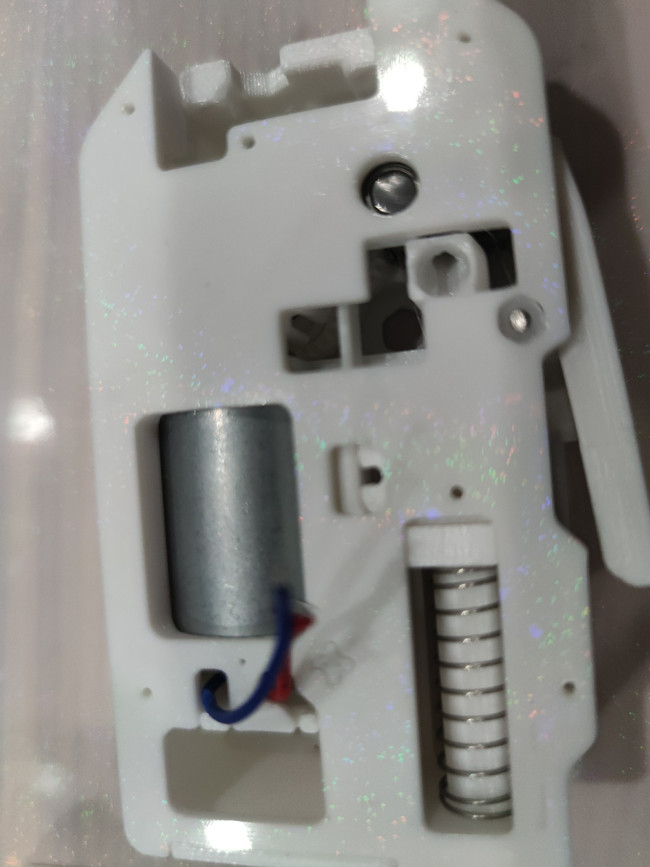
[picture p244: assets/images/build-370x/26.jpg]
    
34. Flip to the other side, repeat shaft installation.
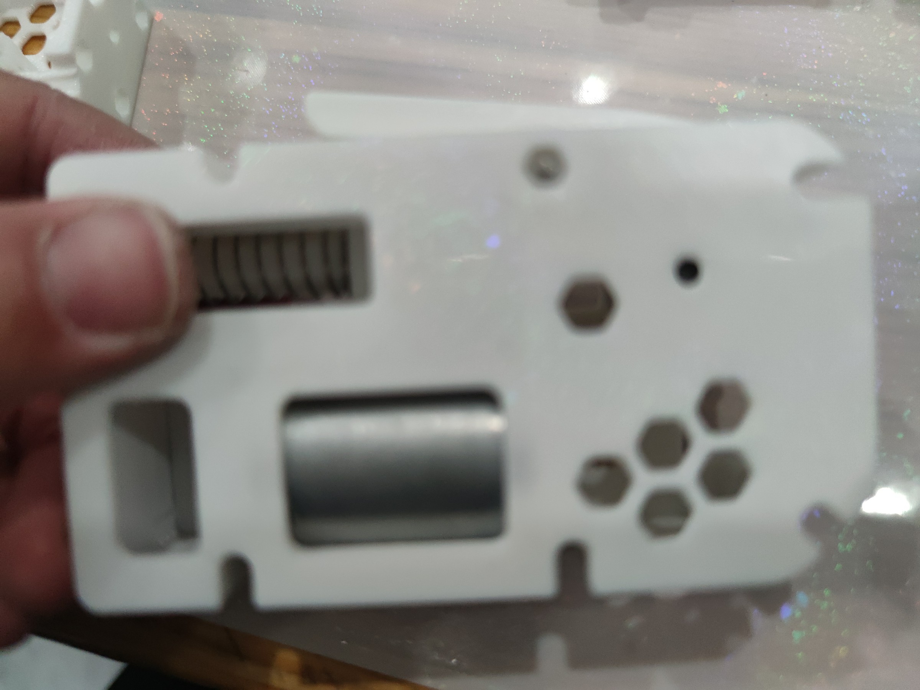
[picture p245: assets/images/build-370x/27.jpg]
    
35. Ensure proper installation and prepare for the next step.
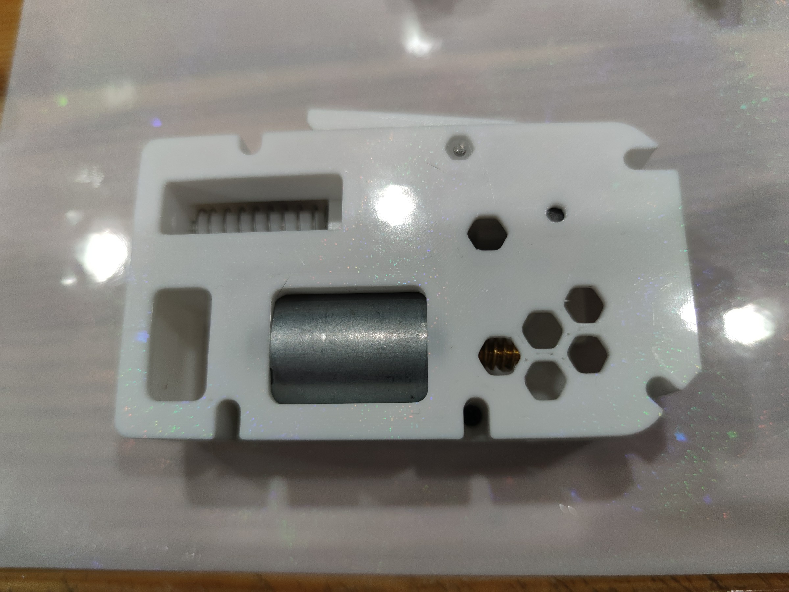
[picture p246: assets/images/build-370x/27.1.jpg]
    
36. Prepare a 5mm diameter glass bead (heavier ones like steel balls are not recommended).
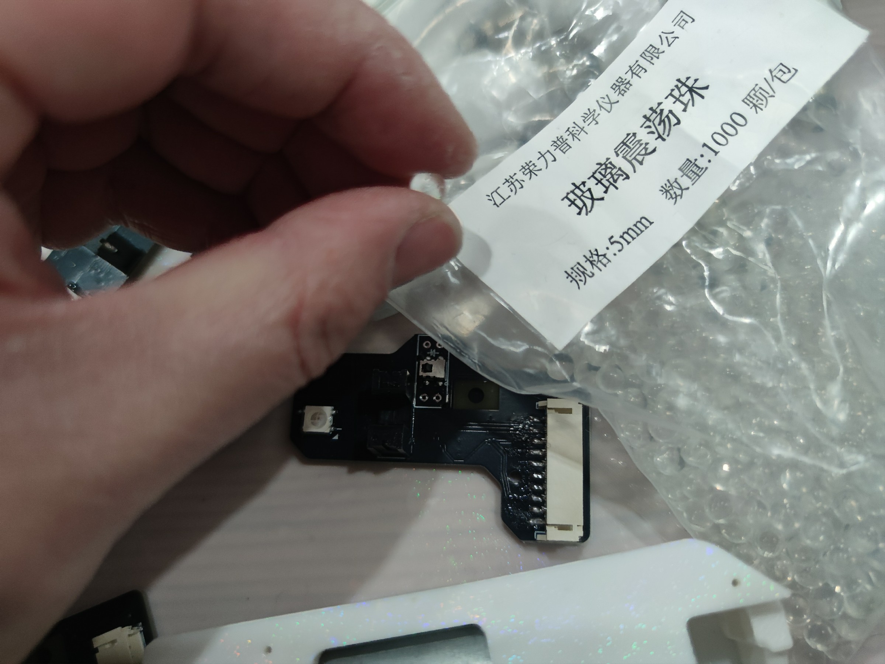
[picture p247: assets/images/build-370x/28.jpg]
    
37. Insert the bead into the hole; it should fall freely and drop out if facing down.
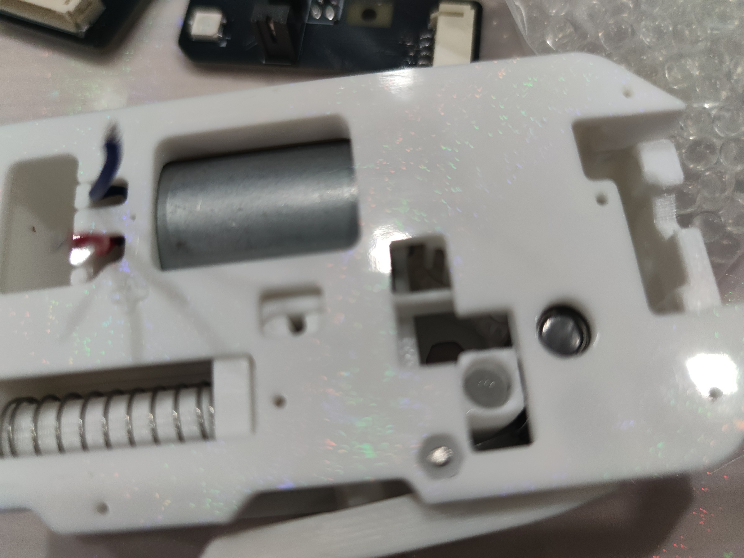
[picture p248: assets/images/build-370x/29.jpg]
    
38. Install the radial magnet on the BMG gear shaft (size: 6x2.5mm). Ensure proper clearance with the shell. Do not use ordinary magnets as substitutes.
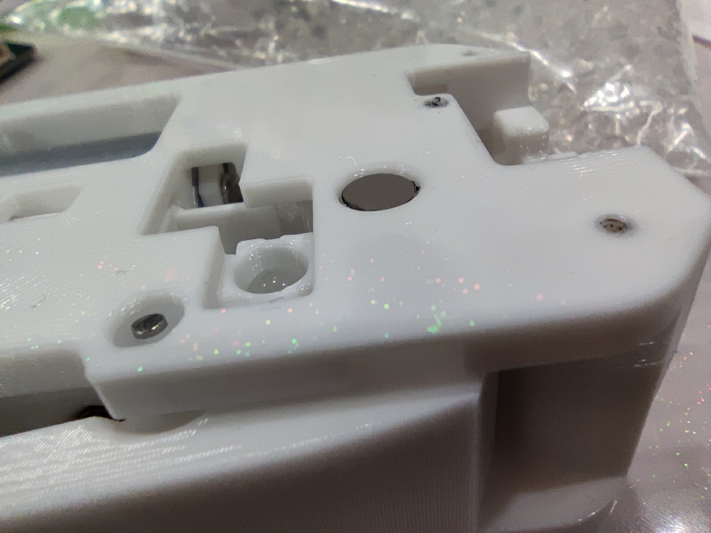
[picture p249: assets/images/build-370x/30.jpg]
    
39. Place the component PCB.
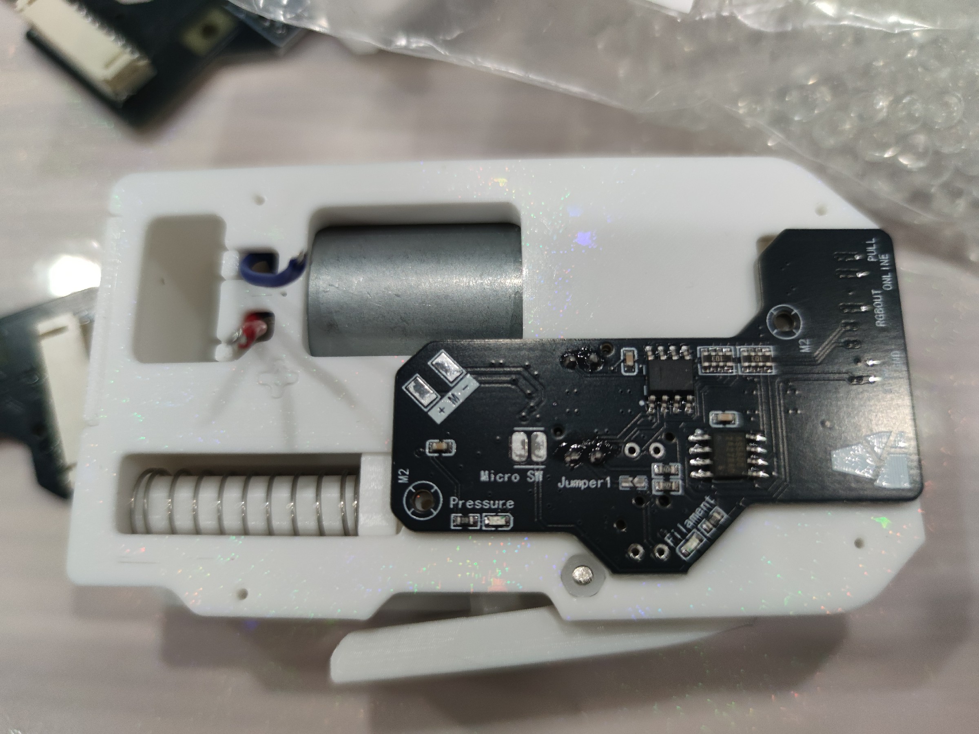
[picture p250: assets/images/build-370x/31.jpg]
    
40. Secure with two m2x8 self-tapping screws. Tighten after both are in place to prevent PCB tilting.
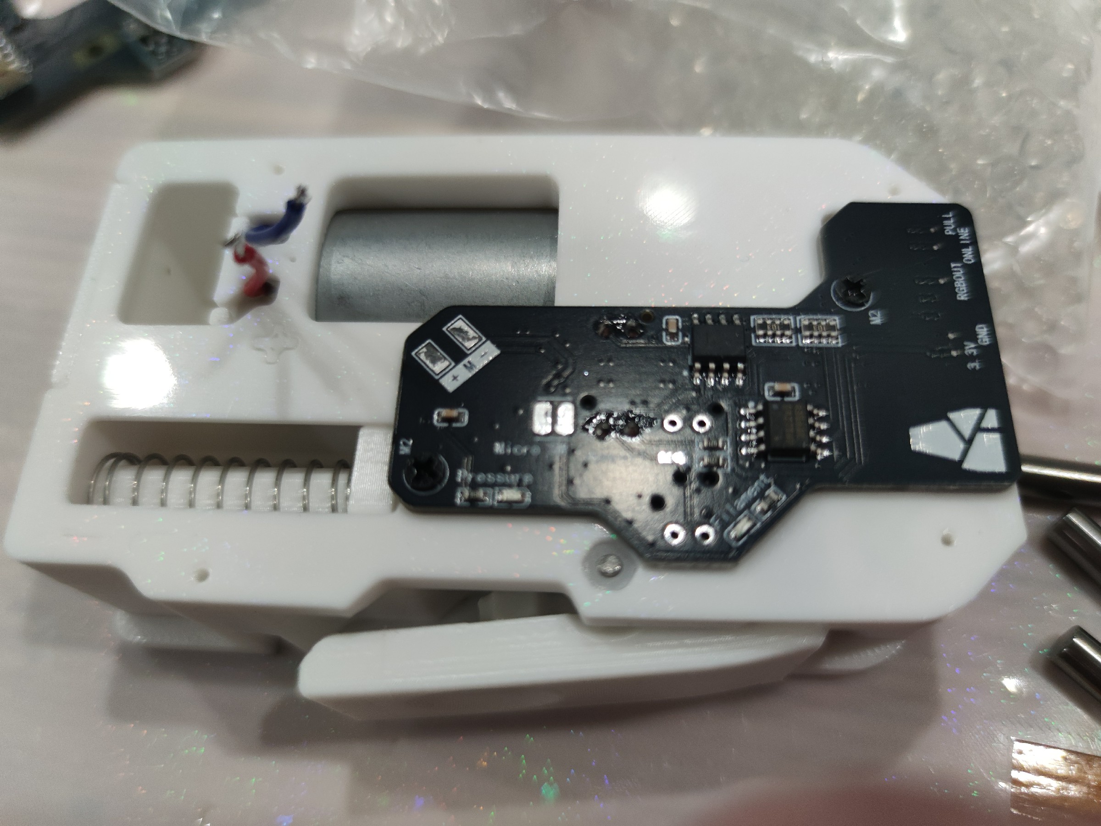
[picture p251: assets/images/build-370x/32.jpg]
    
41. Solder motor wires with a soldering iron. For old firmware (like 130), distinguish positive/negative to avoid reverse rotation. New firmware (3-14 onwards) auto-detects direction.
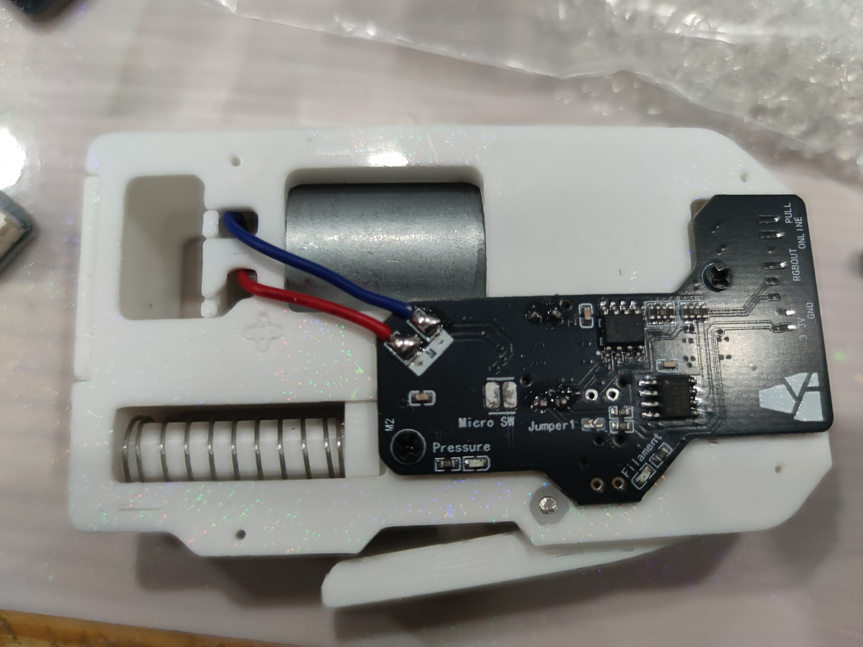
[picture p252: assets/images/build-370x/33.jpg]
    
42. Cover with the top plate, ensure no wires are pinched.
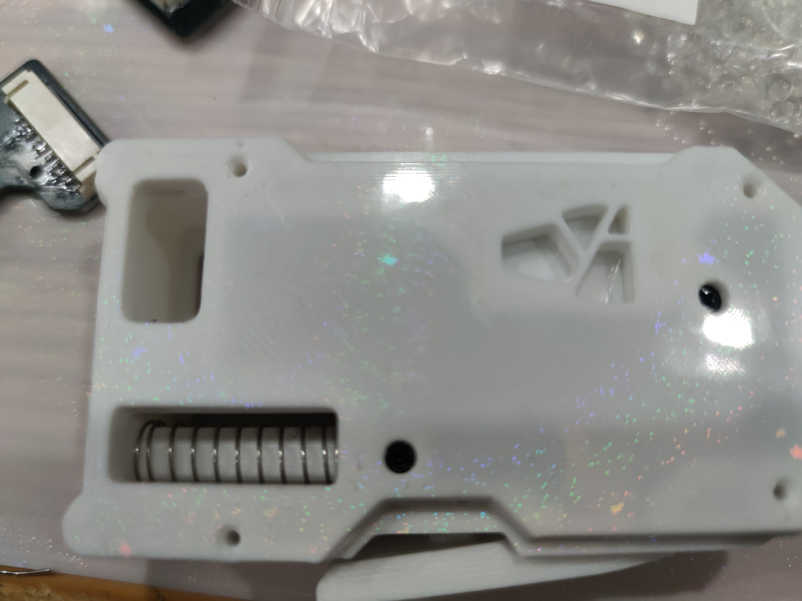
[picture p253: assets/images/build-370x/34.jpg]
    
43. Tighten four m2x8 self-tapping screws. Congratulations, you've completed one channel of the assembly!
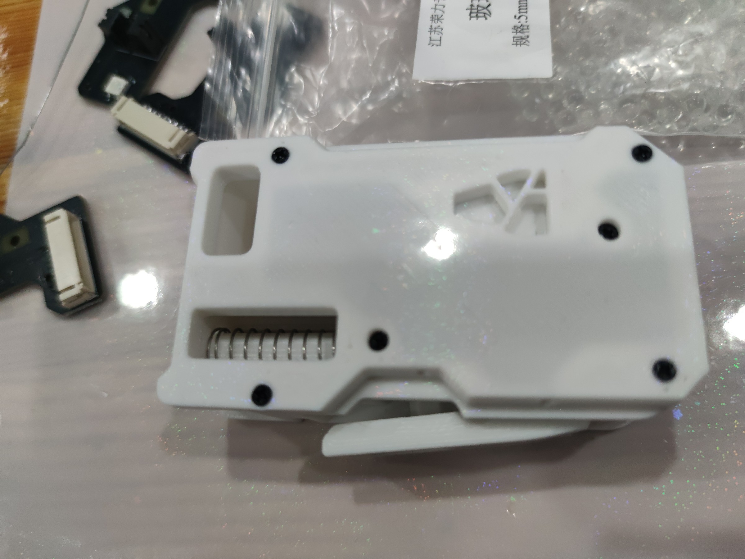
[picture p254: assets/images/build-370x/35.jpg]
