Ykai-f/wiki_yuekai_fr_BMCU/assets/images/bmcu_assembly_130_qtbz/bmcu_installation_2.7.2.jpg

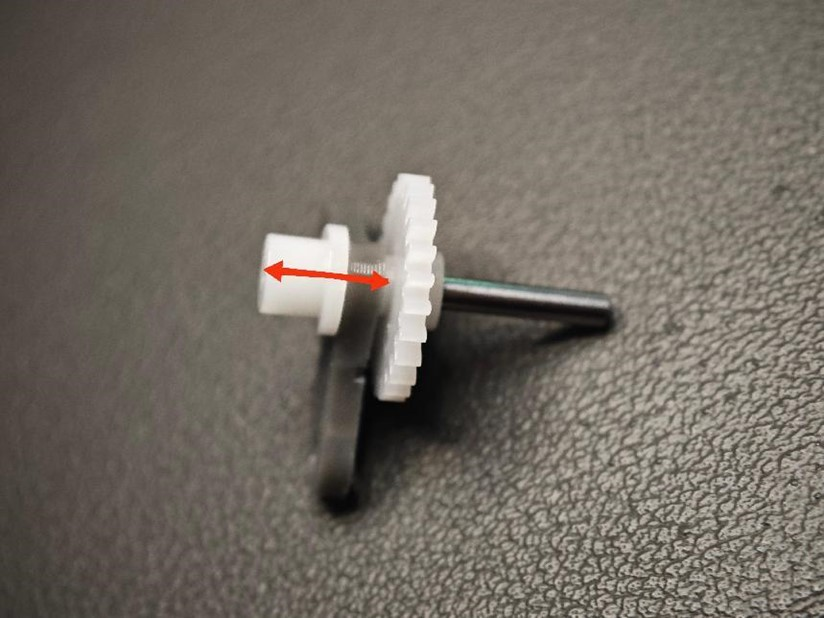
assets/images/bmcu_assembly_130_qtbz/bmcu_installation_2.7.2.jpg
