Ykai-f/wiki_yuekai_fr_BMCU/assets/images/bmcu_assembly_370_yuekai/370_23.jpg

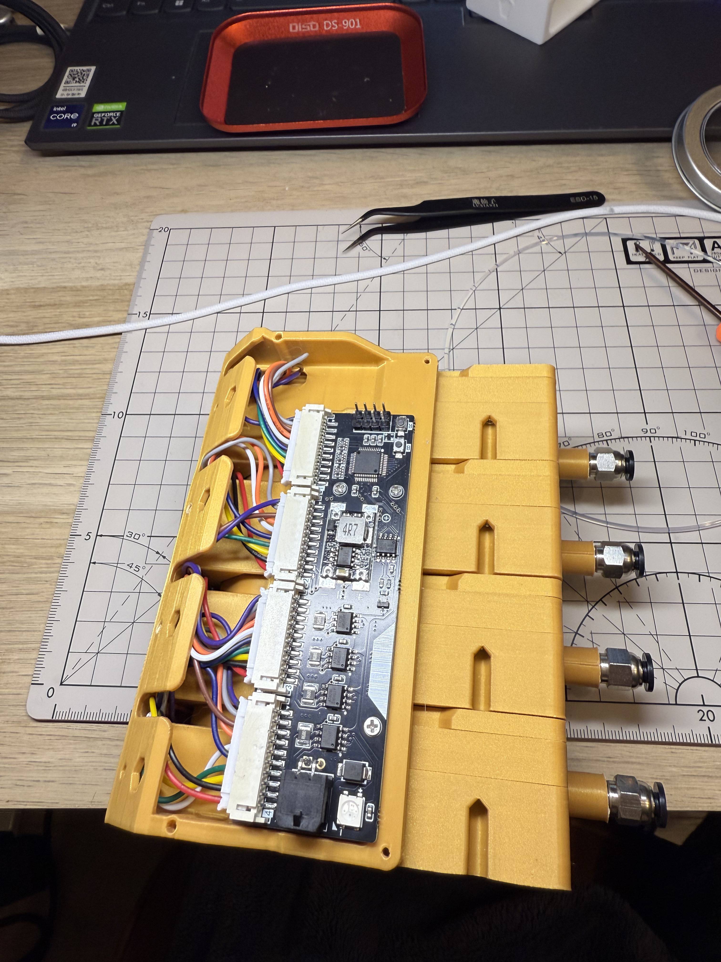
assets/images/bmcu_assembly_370_yuekai/370_23.jpg
