Ykai-f/wiki_yuekai_fr_BMCU/(list of files, drawings)

Other design files:
assets/files/download_center/pcb_files/project/PBMCU_C_Hall.epro
