Ykai-f/wiki_yuekai_fr_BMCU/(commit log)

2025-03-19 docs: add all untracked content
    [mechanical_components_bom.xlsx, pcb_bom.xlsx]
2025-03-19 docs: update BMCU/BMCU_Tutorial/Assembling
2025-03-19 docs: rename BMCU/BMCU_Tutorial/Assembling to BMCU/BMCU_Tutorial_Center/Assembling
2025-03-26 Reorganisation of the document structure
    [mechanical_components_bom.xlsx, pcb_bom.xlsx]
2025-03-30 New print files updated
    [180 version.3mf, 370 v2.5 extended version.3mf, 370+steel+ball+version+3.14.3mf, 370+v2.5+original.3mf]
2025-03-31 update firmware 3.31
    [Back frame.obj, Ball slider.obj, Base.obj, Buffer slider bar.obj, Buffer slider.obj, Front frame.obj, Middle frame.obj, PCB cover.obj]
2025-04-05 photo for screwdriver
2025-04-09 update bom and trouble shooting
2025-04-13 update bom 1
2025-04-14 update bom and photos
2025-04-14 update pcb files and soldering aids
2025-04-14 update pcb files 2
2025-04-15 add hall photo
2025-04-15 upload print file bmcu-c
    [BMCU_C.3mf]
2025-04-17 docs: update BMCU/pcb_voltage_to_ground
2025-04-20 new some f3d files
    [370 v2.5 extended version.3mf, Back frame.obj, Ball slider.obj, Base.obj, Buffer slider bar.obj, Buffer slider.obj, Front frame.obj, Middle frame.obj]
2025-04-23 start section and retraction when cut photo added
2025-05-07 update printer firmware backup
2025-05-13 update project file for bmcu-c
    [PBMCU_C_Hall.epro]
2025-06-16 upload禁止下载
2025-06-17 Update hall tuto
2025-06-28 update hall tutoriel
